Katleho-engineer/Solidworks-design/Calculations/Screenshot (3).png

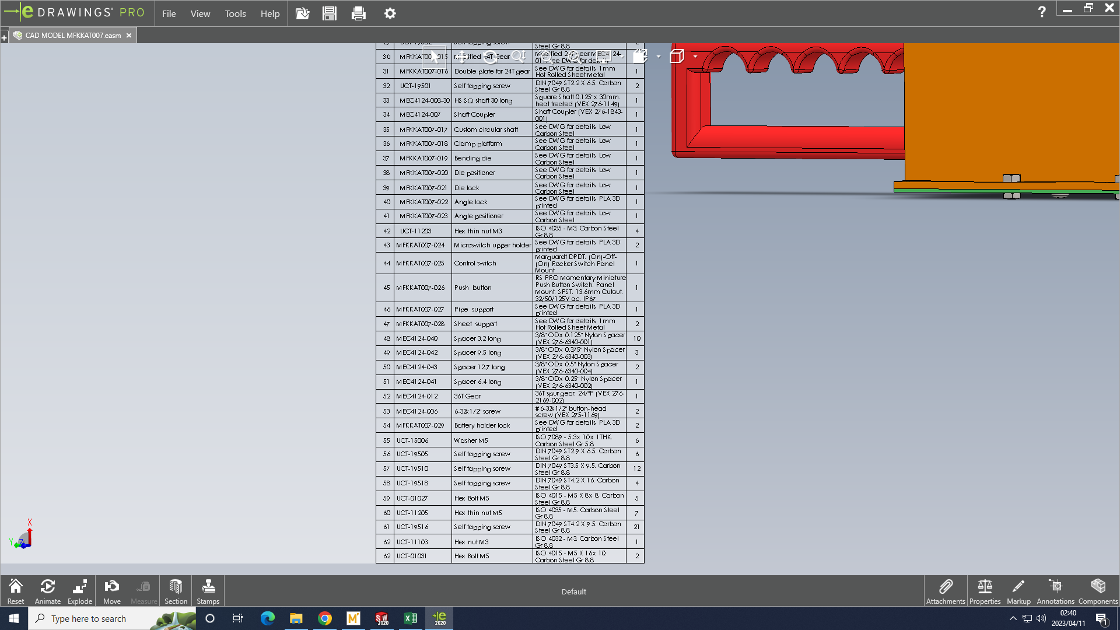
Calculations/Screenshot (3).png
