Katleho-engineer/Solidworks-design/Calculations/Screenshot (2).png

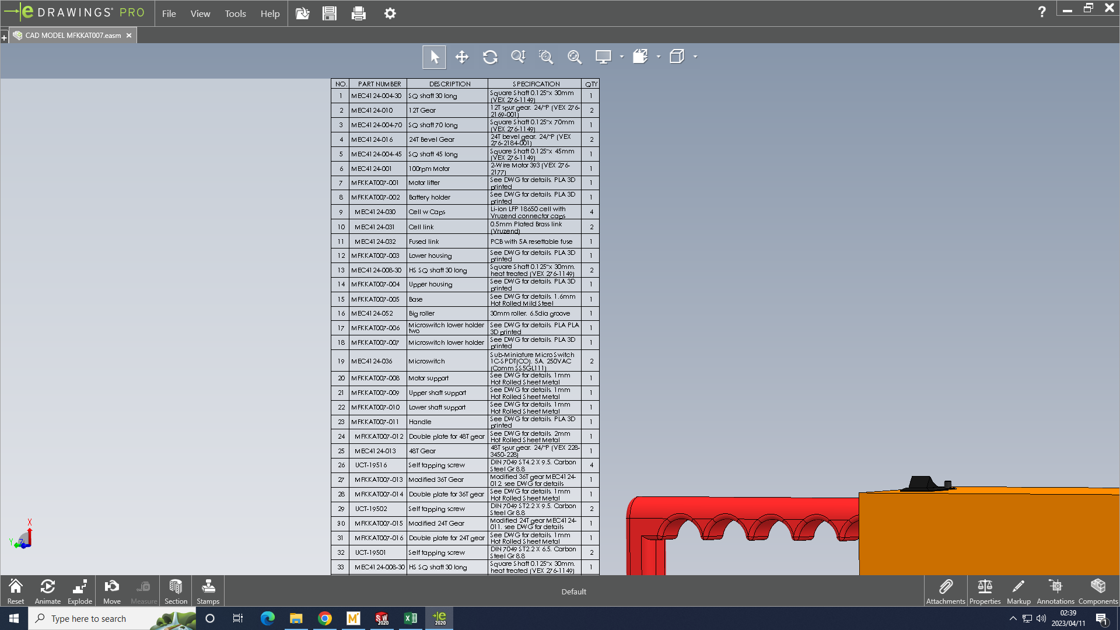
Calculations/Screenshot (2).png
