Katleho-engineer/Solidworks-design/PDF/Bending req.pdf

Appendix A: Bending requirements
The user requirements document gives the properties of the pipe that must be bent by the battery operated bending tool. Those properties are:
Pipe yield strength: | Tyield≔650 ⋅MPa
Pipe thickness: | t≔1.5 mm
Pipe outer diameter: | OD≔6 mm

Using the pipe outer diameter and thickness, the inner diameter can be calculated.

Pipe inner diameter: | ID≔OD -2 ⋅t
| ID =3 mm

Using the above pipe properties, the required bending moment to bend the pipe can be calculated.

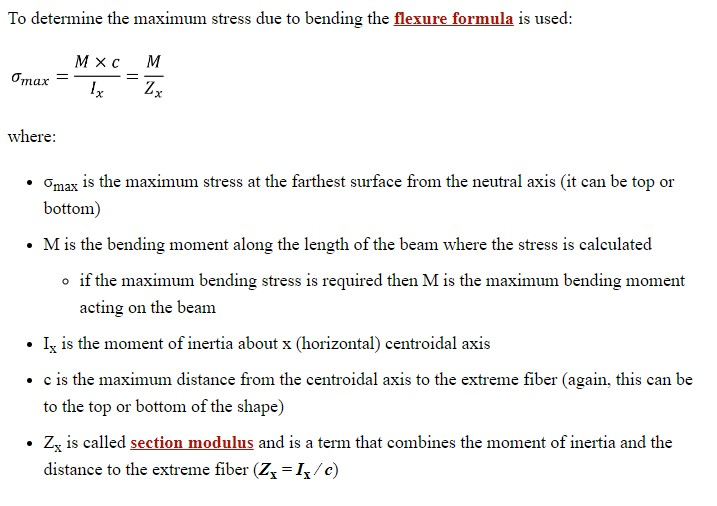
[picture p53: figure]

Figure 1: Bending stress formula

The above formula is taken from a book called "Mechanic of Materials" 11th edition, written by Russell C. Hibbeler

Non-Commercial Use Only

Figure 1: Section modulus formula

The above formula is taken from a book called "Mechanic of Materials" 11th edition, written by Russell C. Hibbeler.

Section Modulus: | SM≔―π⋅――――― ⎛⎝OD -
| 4 ID⁴ ⎞ ⎠ 32 ⋅ OD SM=19.88 mm³
Bending moment required: | Mrequired≔SM⋅Tyield
| Mrequired=12.922 N ⋅m

Now that the required bending moment is calculated, the gearbox should be designed such that the torque of the last gears is greater or equal to the required bending moment.

Non-Commercial Use Only
