Katleho-engineer/Solidworks-design/PDF/Deflection 4.pdf

Appendix D: Deflection calculations

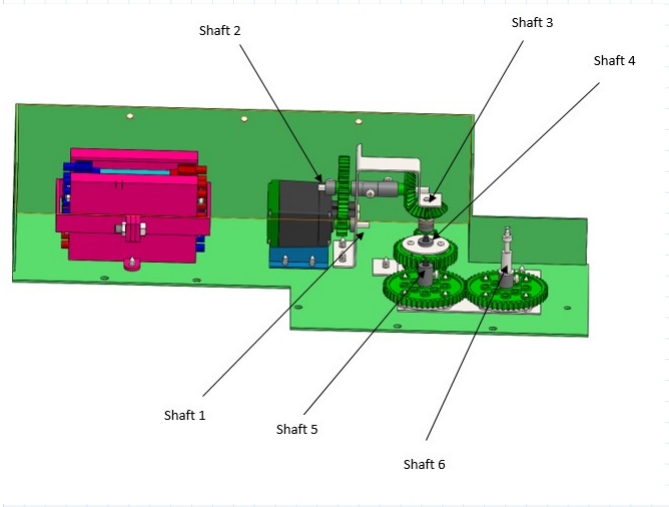
[picture p54: figure]

Figure 1: Shafts

Figure 1 above shows all the shafts that will be used in the prototype. It also shows all the the gears on the each shaft.

Non-Commercial Use Only

Maximum
Torque
[Nm]

Experience
d
Torque
[Nm]

Maximum
tangential
force [N]

Experience
d tangential
force [N]

Experience
d radial
force [N]

Rotational
speed
[rad/s]
Gear 1 [12T] | 3 | 0.941 | 450 | 148.228 | 53.95 | 14.537
Gear 2 [36T] | 3.4 | 2.627 | 700 | 137.879 | 50.184 | 4.508
Gear 3 [24T] | 3 | 2.627 | 300 | 206.819 | 75.276 | 4.508
Gear 4 [24T] | 3 | 2.489 | 300 | 195.99 | 71.335 | 4.272
Gear 5 [12T] | 3 | 2.489 | 450 | 391.98 | 142.669 | 4.272
Gear 6 [36T] | 3.4 | 6.946 | 700 | 364 | 132.709 | 1.324
Gear 7 [24T] | 1 | 6.946 | 580 | 546.923 | 199.064 | 1.324
Gear 8 [48T] | 1.2 | 13.269 | 580 | 522.417 | 190.144 | 0.638
Gear 9 [48T] | 1.2 | 12.922 | 580 | 508.74 | 185.166 | 0.621

Figure 1: Summary of the forces

The above table the shows all the forces calculated in Appendix C which will be used in this section to determine the deflection of each gear.

The above deflection equation from "Mechanic of Materials" 11th edition, written by Russell
C. Hibbeler, will be used to determine the deflection of the shaft.

All the shafts are made with low carbon steel and will have the same elastic modulus. All the square shafts have the same cross section and will the same moment of inertia.

Low carbon steel elastic
modulus:

Eshaft≔200 ⋅GPa

Cross sectional distance: | Dshaft≔3.18 mm

Moment of inertia: | Ishaft≔――― Dshaft
| 4
| 12
| Ishaft=8.522 mm⁴

Shaft 1

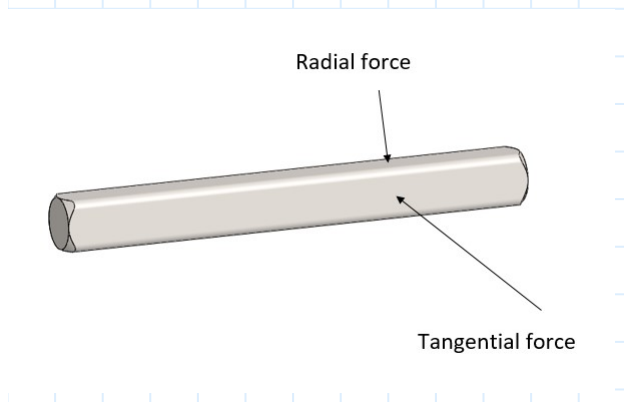
[picture p55: figure]

Shaft 1 has 12T spur gear on it. Thus, it will experience both radial and tangential forces. Shaft 1 has low carbon steel material.

Radial force will deflect the shaft vertically and the tangential force will deflect the shaft horizontally.

Shaft 1 length: | Lshaft_1≔30 mm

Deflection due to radial force

Radial force due to gear 1: | FR_1≔53.95 N

The distance from the
boundary the radial force:

ar1≔17.27 mm

The distance from the other boundary the radial force:

br1≔Lshaft_1-ar1

br1=12.73 mm

Maximum deflection caused
by the radial force:

δr1≔―――――――

| FR_1 ⋅ b ⋅ r1 | ar1
6 ⋅L | ⋅ | ⋅ shaft_1 Eshaft | Ishaft

⎛
⎝Lshaft_1 | - | -

### 2 br1

2
ar1

2 ⎞
⎠

δr1=0.017 mm

Deflection due to tangential force

Radial force due to gear 1: | FT_1≔148.228 N

The distance from the
boundary the radial force:

at1≔17.27 mm

The distance from the other boundary the radial force:

bt1≔Lshaft_1-ar1

bt1=12.73 mm

Maximum deflection caused
by the radial force:

δt1≔―――――――

| FT_1 ⋅ b ⋅ t1 | at1
6 ⋅L | ⋅ | ⋅ shaft_1 Eshaft | Ishaft

⎛
⎝Lshaft_1 | - | -

### 2 bt1

2
at1

2 ⎞
⎠

δt1=0.047 mm

Shaft 2

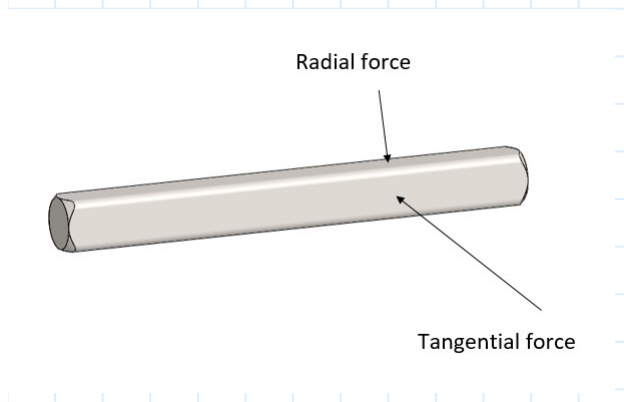
[picture p56: figure]

Shaft 2 has 36T spur gear and 24T bevel gear on it. Thus, it will experience both radial and tangential forces.

Radial force will deflect the shaft vertically and the tangential force will deflect the shaft horizontally.

Shaft 2 length: | Lshaft_2≔70 mm

Shaft 2 will experience radial forces caused by the 36T spur gear and 24T bevel gear. The deflection of interest will be at the two points at where the gears are meshing.

First meshing distance from the left: | b2_1l1≔16 mm

First meshing distance from
the right:

a2_1r1≔Lshaft_2-b2_1l1

a2_1r1=54 mm

Second meshing distance from the left:

a2_2l1≔58 mm

Second meshing distance from the right:

b2_2r2≔Lshaft_2-a2_2l1

b2_2r2=12 mm

Deflection due to radial force

Radial force due to 36T spur gear:

FR_2_36T≔50.184 N

Radial force due to 24T
bevel gear:

FR_2_24T≔75.276 N

For 36T gear

Deflection caused by the
radial force of gear 2 at the mesh 2:

δr2_36T≔―――――――

FR_2_36T ⋅ b | ⋅ 2_1l1 | a2_1r1
6 ⋅L | ⋅ | ⋅ shaft_2 | Eshaft | Ishaft

⎛
⎝Lshaft_2 - | -

### 2 b2_1l1

2
a2_1r1

2 ⎞
⎠

δr2_36T=0.105 mm

Deflection caused by the
radial force of gear 2 at the mesh 3:

δr3_36T≔―――――――

FR_2_36T ⋅ b | ⋅ 2_2r2 | b2_1l1
6 ⋅L | ⋅ | ⋅ shaft_2 | Eshaft | Ishaft

⎛
⎝Lshaft_2 - | -

### 2 b2_2r2

### 2 b2_1l1

2 ⎞
⎠

δr3_36T=0.061 mm

For 24T gear

Deflection caused by the
radial force of gear 3
at the mesh 2:

δr2_24T≔―――――――

FR_2_24T ⋅ b | ⋅ 2_2r2 | b2_1l1
6 ⋅L | ⋅ | ⋅ shaft_2 | Eshaft | Ishaft

⎛
⎝Lshaft_2 - | -

### 2 b2_2r2

### 2 b2_1l1

2 ⎞
⎠

δr2_24T=0.091 mm

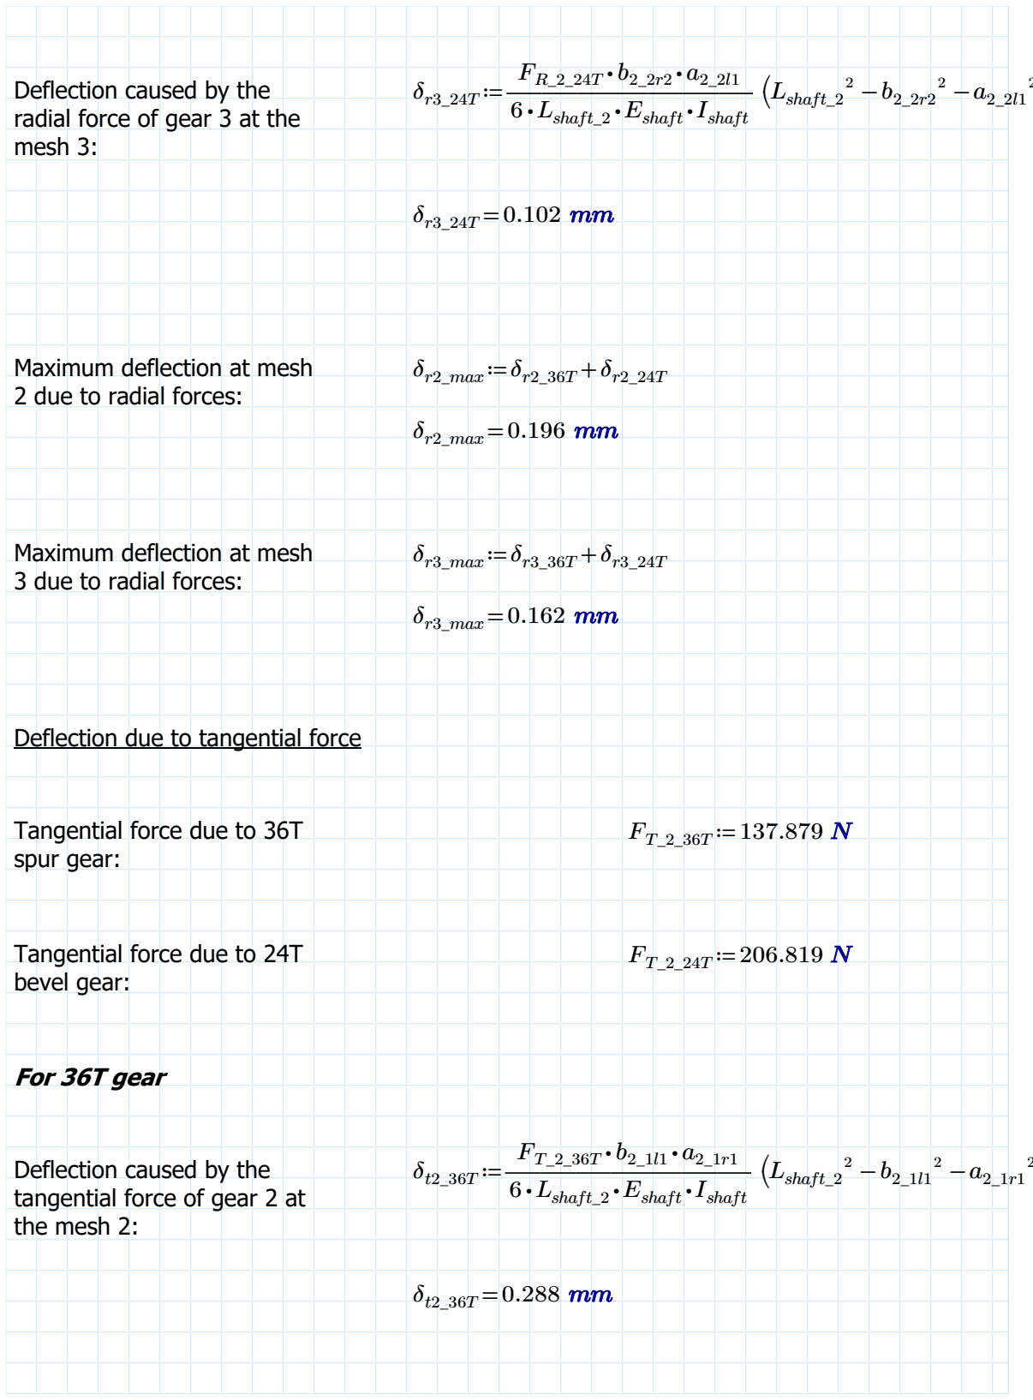
[picture p57: figure]
Deflection caused by the radial force of gear 3 at the mesh 3:; ⋅ shaft_2; Eshaft; Ishaft; ⎝Lshaft_2 -; Maximum deflection at mesh 2 due to radial forces:; δr2_max≔δr2_36T+δr2_24T; δr2_max=0.196 mm; Maximum deflection at mesh 3 due to radial forces:; δr3_max≔δr3_36T+δr3_24T; δr3_max=0.162 mm; Deflection due to tangential force; Tangential force due to 36T spur gear:; Tangential force due to 24T bevel gear:; For 36T gear; Deflection caused by the tangential force of gear 2 at the mesh 2:

2 ⎞
⎠

2 ⎞
⎠

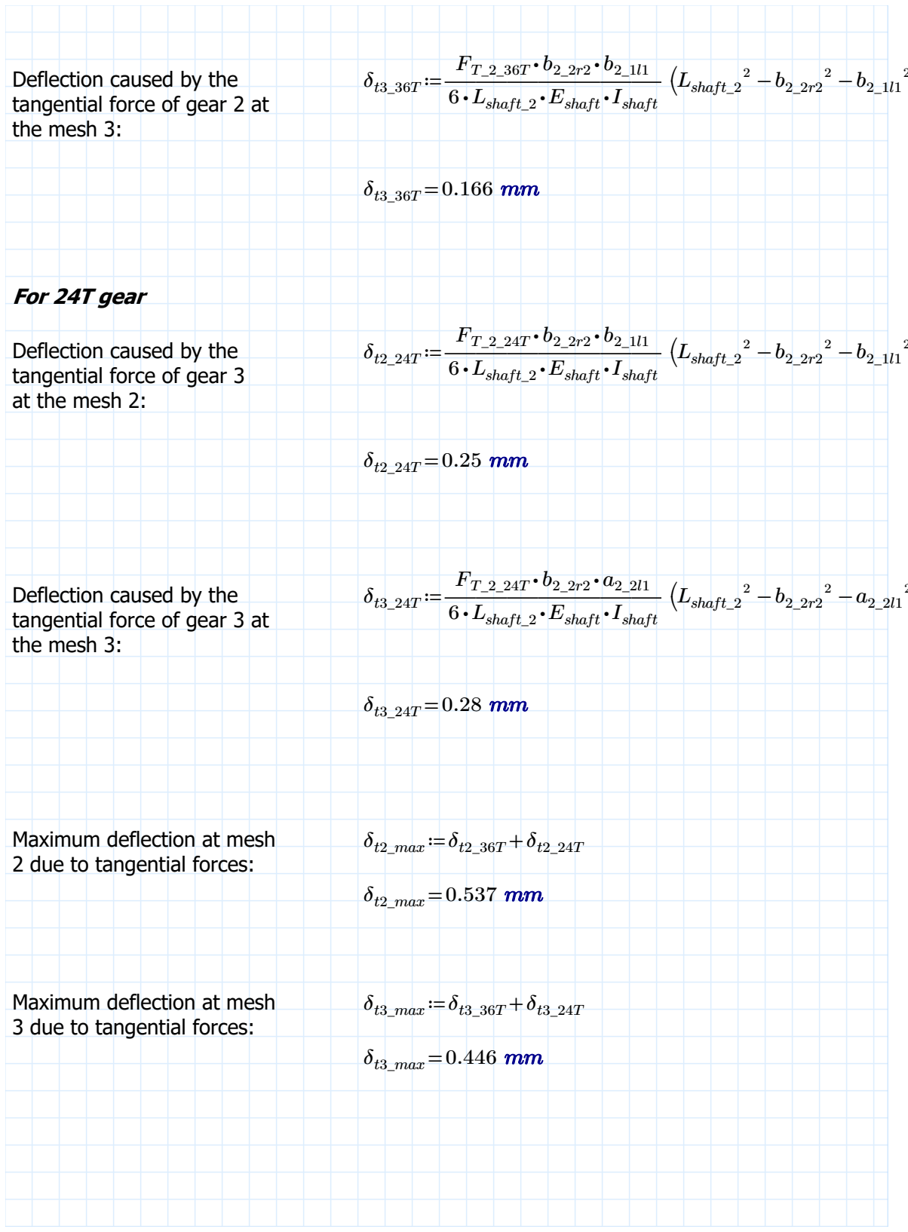
[picture p58: figure]
Deflection caused by the tangential force of gear 2 at the mesh 3:; ⋅ shaft_2; Eshaft; Ishaft; ⎝Lshaft_2 -; For 24T gear; Deflection caused by the tangential force of gear 3 at the mesh 2:; Deflection caused by the tangential force of gear 3 at the mesh 3:; Maximum deflection at mesh 2 due to tangential forces:; δt2_max≔δt2_36T+δt2_24T; δt2_max=0.537 mm; Maximum deflection at mesh 3 due to tangential forces:; δt3_max≔δt3_36T+δt3_24T; δt3_max=0.446 mm

2 ⎞
⎠

2 ⎞
⎠

2 ⎞
⎠

Shaft 3

Shaft 3 has 24T spur gear and 12T bevel gear on it. Thus, it will experience both radial and tangential forces.

Radial force will deflect the shaft vertically and the tangential force will deflect the shaft horizontally.

Shaft 3 length: | Lshaft_3≔45 mm

Shaft 3 will experience radial forces caused by the 24T bevel gear and 12T spur gear. The deflection of interest will be at the two points at where the gears are meshing.

First meshing distance from the left: | b3_1l1≔8 mm

First meshing distance from
the right:

a3_1r1≔Lshaft_3-b3_1l1

a3_1r1=37 mm

Second meshing distance from the left:

a3_2l1≔26 mm

Second meshing distance from the right:

b3_2r2≔Lshaft_3-a3_2l1

b3_2r2=19 mm

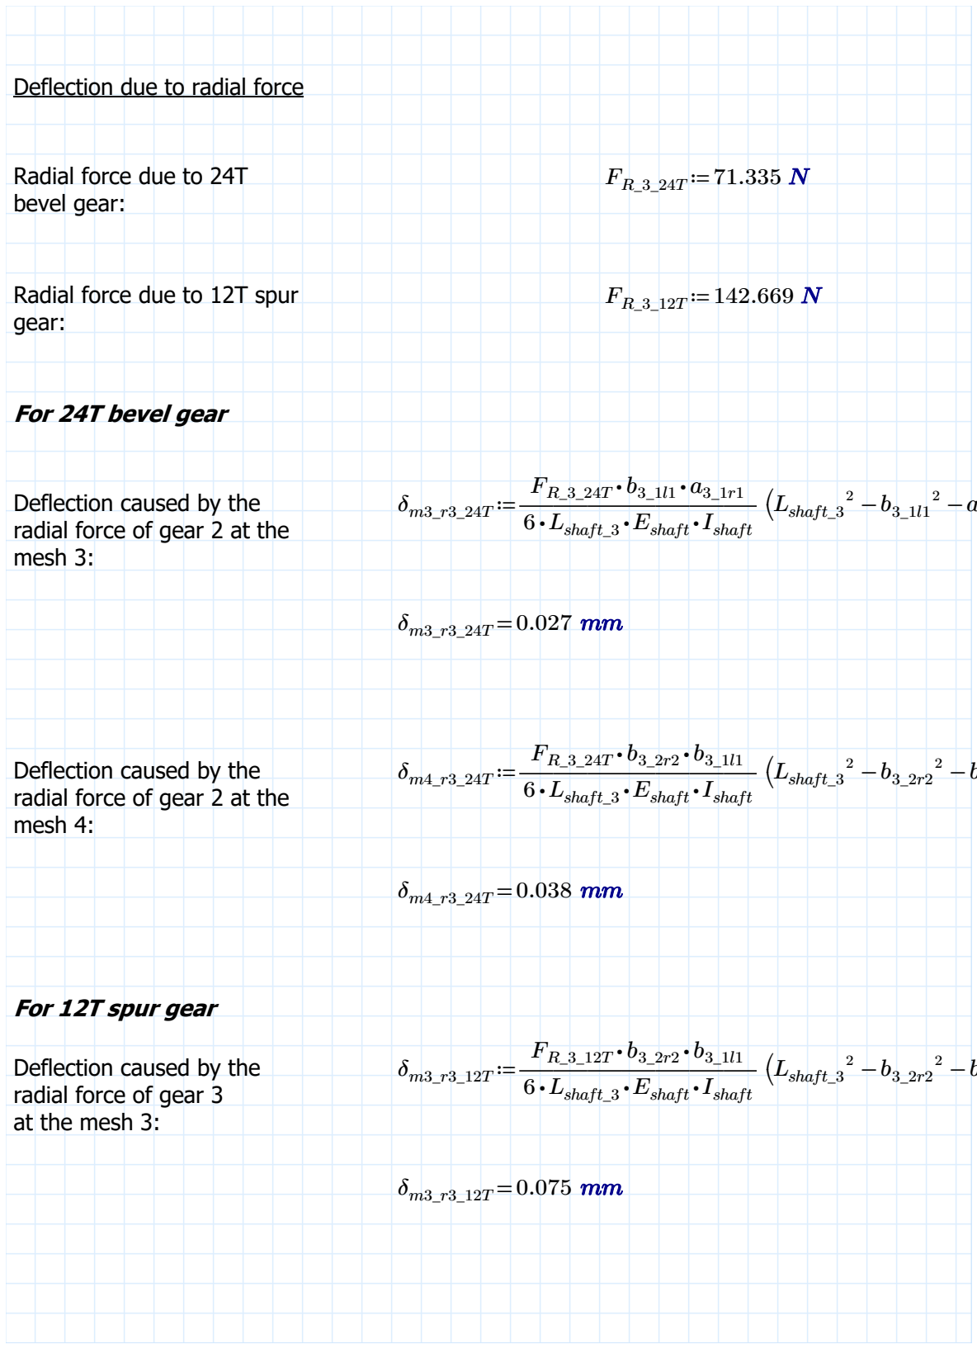
[picture p59: figure]
Deflection due to radial force; Radial force due to 24T bevel gear:; Radial force due to 12T spur gear:; For 24T bevel gear; Deflection caused by the radial force of gear 2 at the mesh 3:; ⋅ shaft_3; Eshaft; Ishaft; ⎝Lshaft_3 -; Deflection caused by the radial force of gear 2 at the mesh 4:; For 12T spur gear; Deflection caused by the radial force of gear 3 at the mesh 3:

a3_1r1

2 ⎞
⎠

### 2 b3_1l1

2 ⎞
⎠

### 2 b3_1l1

2 ⎞
⎠

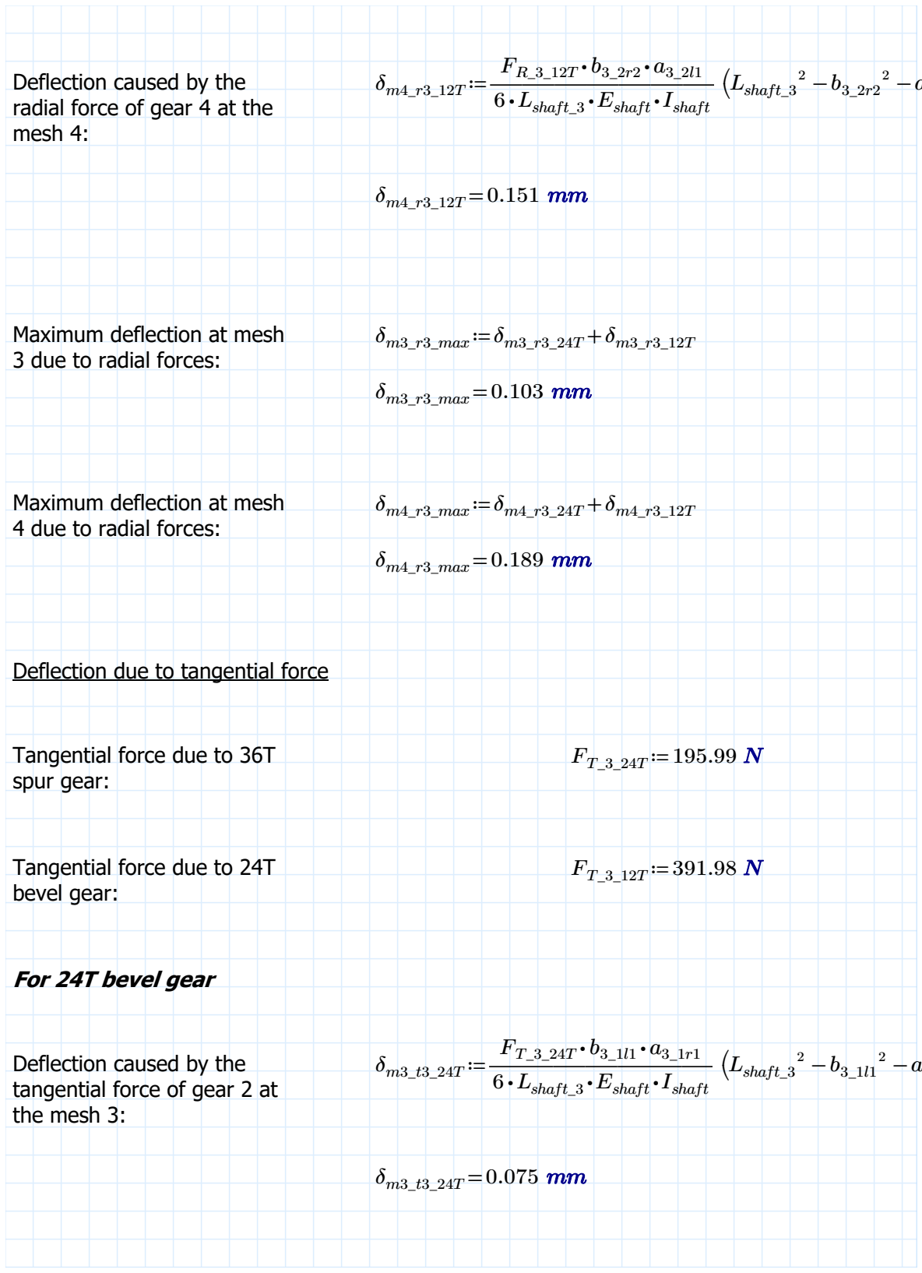
[picture p60: figure]
Deflection caused by the radial force of gear 4 at the mesh 4:; ⋅ shaft_3; Eshaft; Ishaft; ⎝Lshaft_3 -; Maximum deflection at mesh 3 due to radial forces:; δm3_r3_max≔δm3_r3_24T+δm3_r3_12T; δm3_r3_max=0.103 mm; Maximum deflection at mesh 4 due to radial forces:; δm4_r3_max≔δm4_r3_24T+δm4_r3_12T; δm4_r3_max=0.189 mm; Deflection due to tangential force; Tangential force due to 36T spur gear:; Tangential force due to 24T bevel gear:; For 24T bevel gear; Deflection caused by the tangential force of gear 2 at the mesh 3:

a3_2l1

2 ⎞
⎠

a3_1r1

2 ⎞
⎠

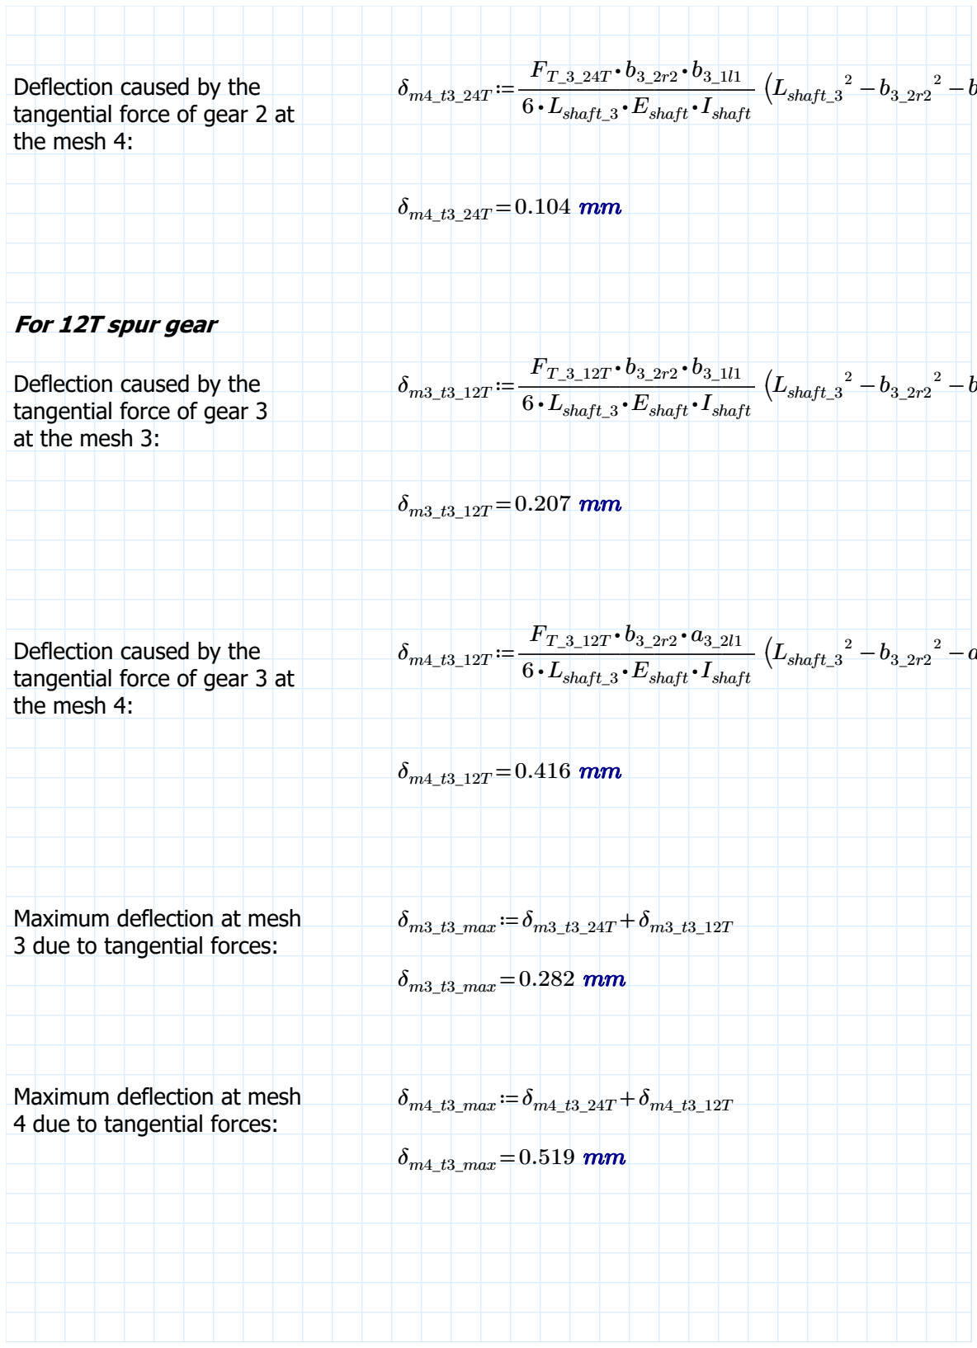
[picture p61: figure]
Deflection caused by the tangential force of gear 2 at the mesh 4:; ⋅ shaft_3; Eshaft; Ishaft; ⎝Lshaft_3 -; For 12T spur gear; Deflection caused by the tangential force of gear 3 at the mesh 3:; Deflection caused by the tangential force of gear 3 at the mesh 4:; Maximum deflection at mesh 3 due to tangential forces:; δm3_t3_max≔δm3_t3_24T+δm3_t3_12T; δm3_t3_max=0.282 mm; Maximum deflection at mesh 4 due to tangential forces:; δm4_t3_max≔δm4_t3_24T+δm4_t3_12T; δm4_t3_max=0.519 mm

### 2 b3_1l1

2 ⎞
⎠

### 2 b3_1l1

2 ⎞
⎠

a3_2l1

2 ⎞
⎠

Shaft 4

Shaft 4 has 36T spur gear and 24T bevel gear on it. Thus, it will experience both radial and tangential forces.

Radial force will deflect the shaft vertically and the tangential force will deflect the shaft horizontally.

Shaft 4 length: | Lshaft_4≔30 mm

Shaft 3 will experience radial forces caused by the 24T bevel gear and 12T spur gear. The deflection of interest will be at the two points at where the gears are meshing.

First meshing distance from the left: | b4_1l1≔11 mm

First meshing distance from
the right:

a4_1r1≔Lshaft_4-b4_1l1

a4_1r1=19 mm

Second meshing distance from the left:

a4_2l1≔19 mm

Second meshing distance from the right:

b4_2r2≔Lshaft_4-a4_2l1

b4_2r2=11 mm

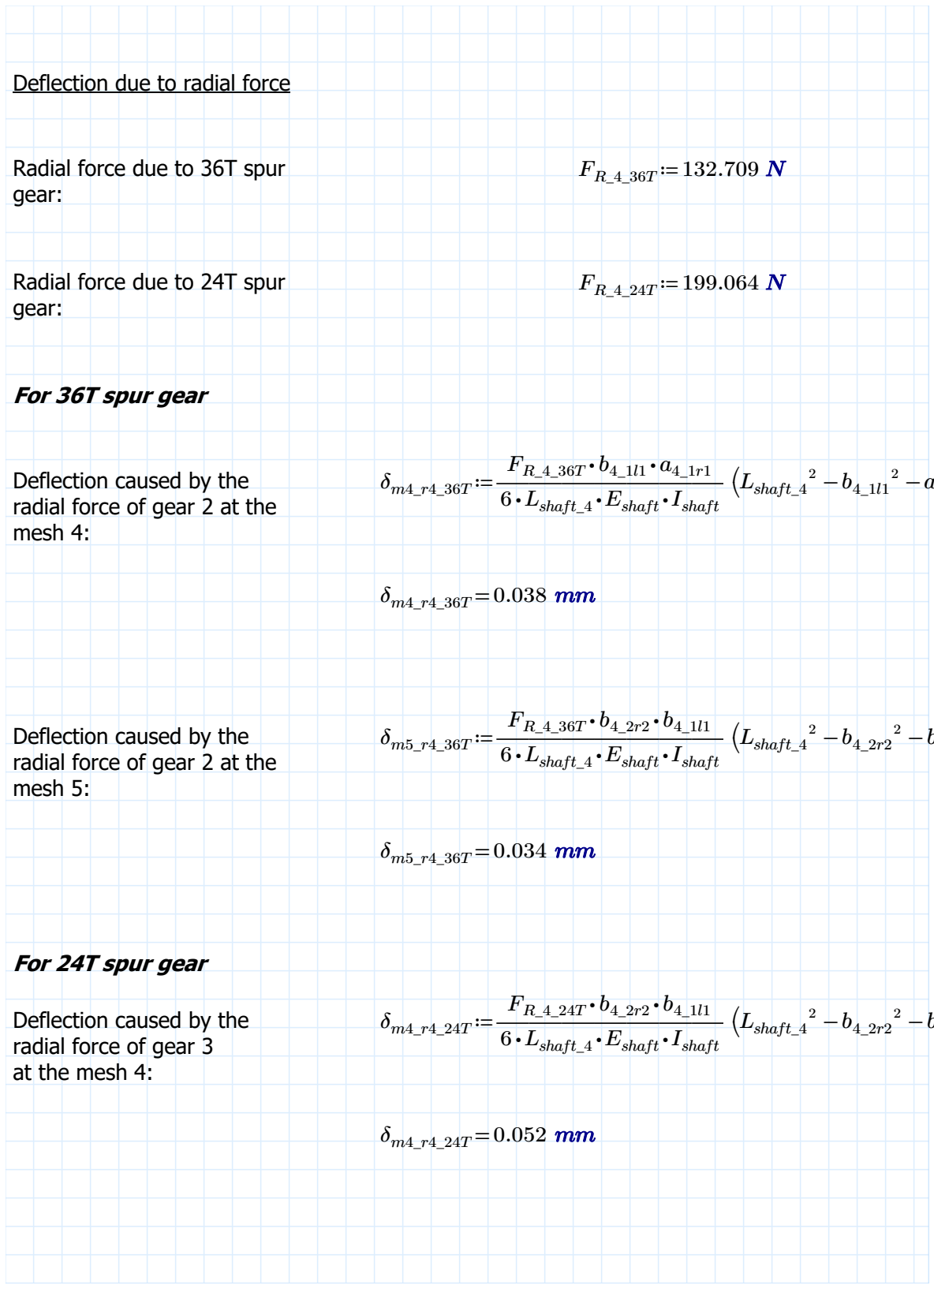
[picture p62: figure]
Deflection due to radial force; Radial force due to 36T spur gear:; Radial force due to 24T spur gear:; For 36T spur gear; Deflection caused by the radial force of gear 2 at the mesh 4:; ⋅ shaft_4; Eshaft; Ishaft; ⎝Lshaft_4 -; Deflection caused by the radial force of gear 2 at the mesh 5:; For 24T spur gear; Deflection caused by the radial force of gear 3 at the mesh 4:

a4_1r1

2 ⎞
⎠

### 2 b4_1l1

2 ⎞
⎠

### 2 b4_1l1

2 ⎞
⎠

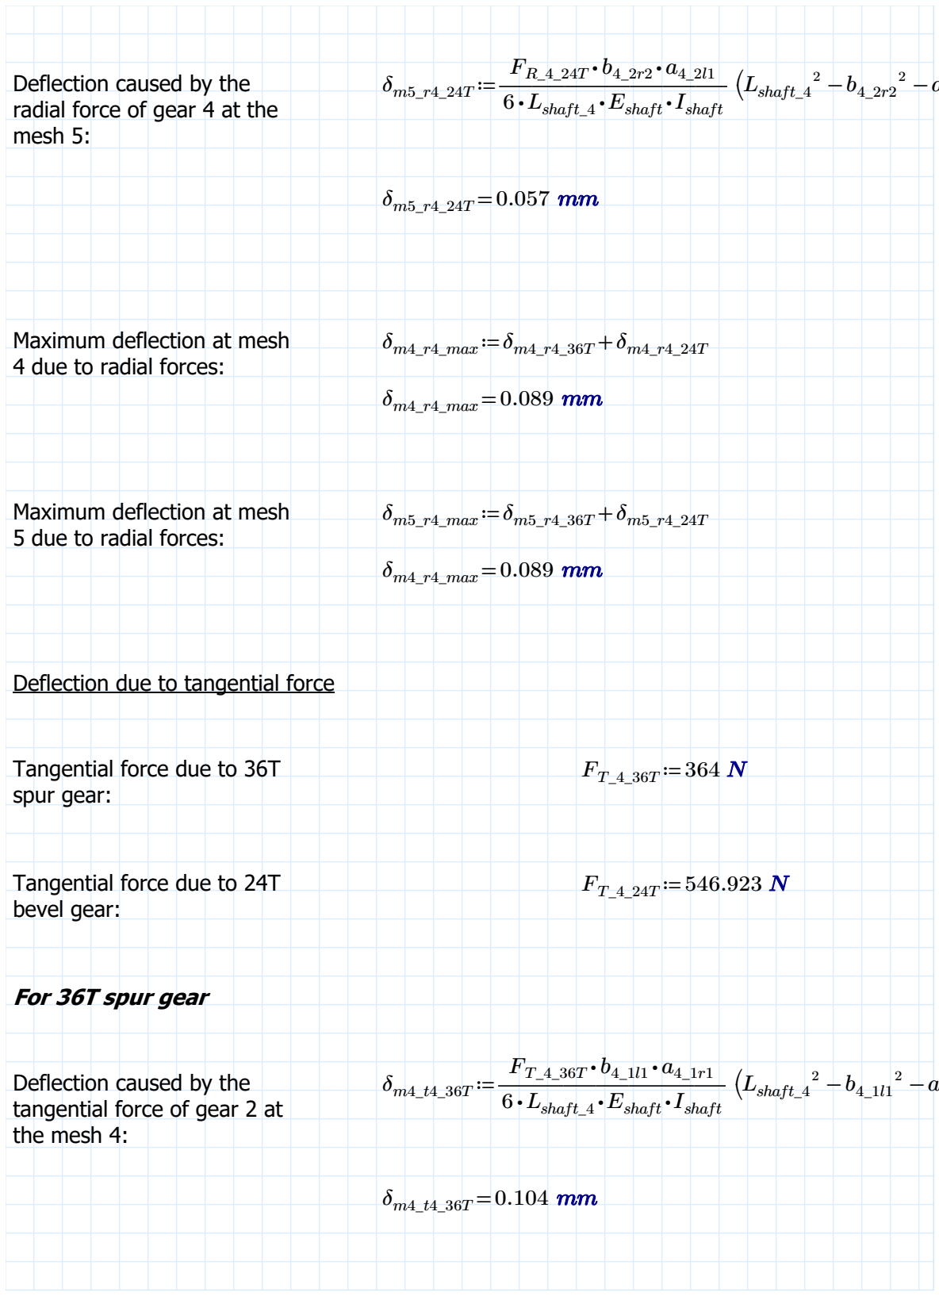
[picture p63: figure]
Deflection caused by the radial force of gear 4 at the mesh 5:; ⋅ shaft_4; Eshaft; Ishaft; ⎝Lshaft_4 -; Maximum deflection at mesh 4 due to radial forces:; δm4_r4_max≔δm4_r4_36T+δm4_r4_24T; δm4_r4_max=0.089 mm; Maximum deflection at mesh 5 due to radial forces:; δm5_r4_max≔δm5_r4_36T+δm5_r4_24T; Deflection due to tangential force; Tangential force due to 36T spur gear:; Tangential force due to 24T bevel gear:; For 36T spur gear; Deflection caused by the tangential force of gear 2 at the mesh 4:

a4_2l1

2 ⎞
⎠

a4_1r1

2 ⎞
⎠

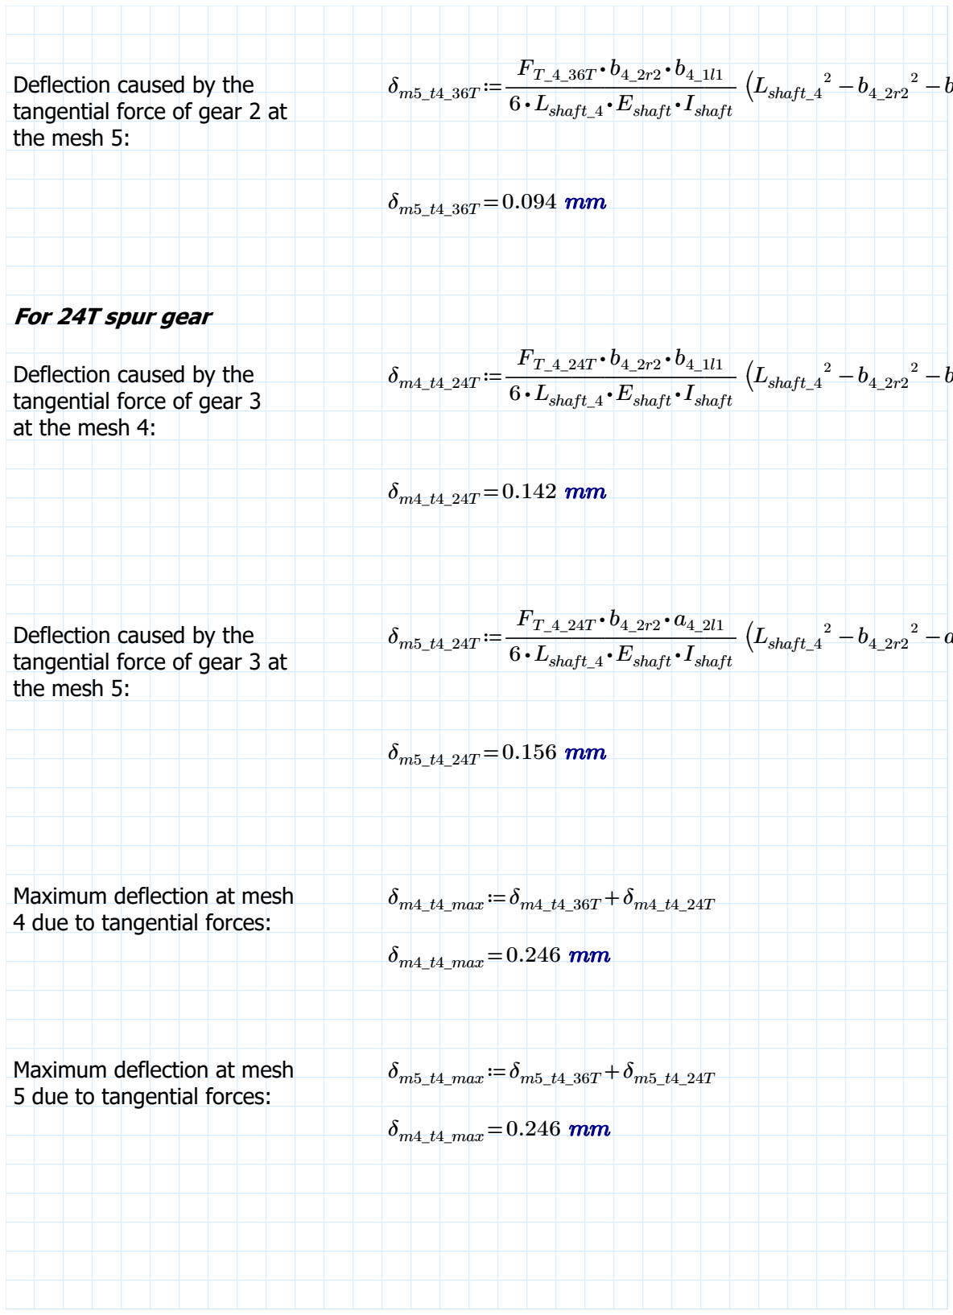
[picture p64: figure]
Deflection caused by the tangential force of gear 2 at the mesh 5:; ⋅ shaft_4; Eshaft; Ishaft; ⎝Lshaft_4 -; For 24T spur gear; Deflection caused by the tangential force of gear 3 at the mesh 4:; Deflection caused by the tangential force of gear 3 at the mesh 5:; Maximum deflection at mesh 4 due to tangential forces:; δm4_t4_max≔δm4_t4_36T+δm4_t4_24T; δm4_t4_max=0.246 mm; Maximum deflection at mesh 5 due to tangential forces:; δm5_t4_max≔δm5_t4_36T+δm5_t4_24T

### 2 b4_1l1

2 ⎞
⎠

### 2 b4_1l1

2 ⎞
⎠

a4_2l1

2 ⎞
⎠

Shaft 5

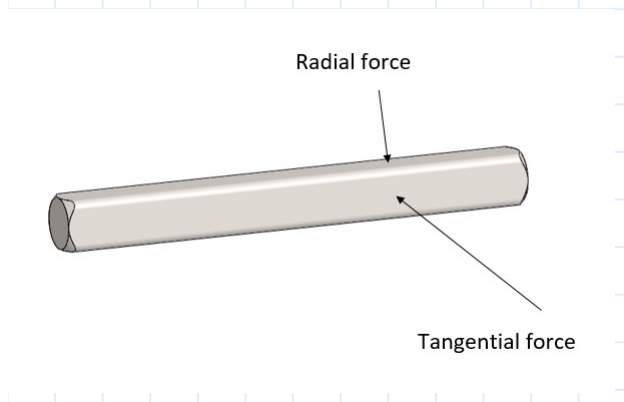
[picture p65: figure]

Shaft 5 has 48T spur gear on it. Thus, it will experience both radial and tangential forces.

Radial force will deflect the shaft vertically and the tangential force will deflect the shaft horizontally.

Shaft 5 length: | Lshaft_5≔30 mm

Shaft 5 will experience radial forces caused by the 24T bevel gear and 12T spur gear. The deflection of interest will be at the two points at where the gears are meshing.

First meshing distance from
the left:

b5_1l1≔18.57 mm

First meshing distance from the right:

a5_1r1≔Lshaft_5-b5_1l1

a5_1r1=11.43 mm

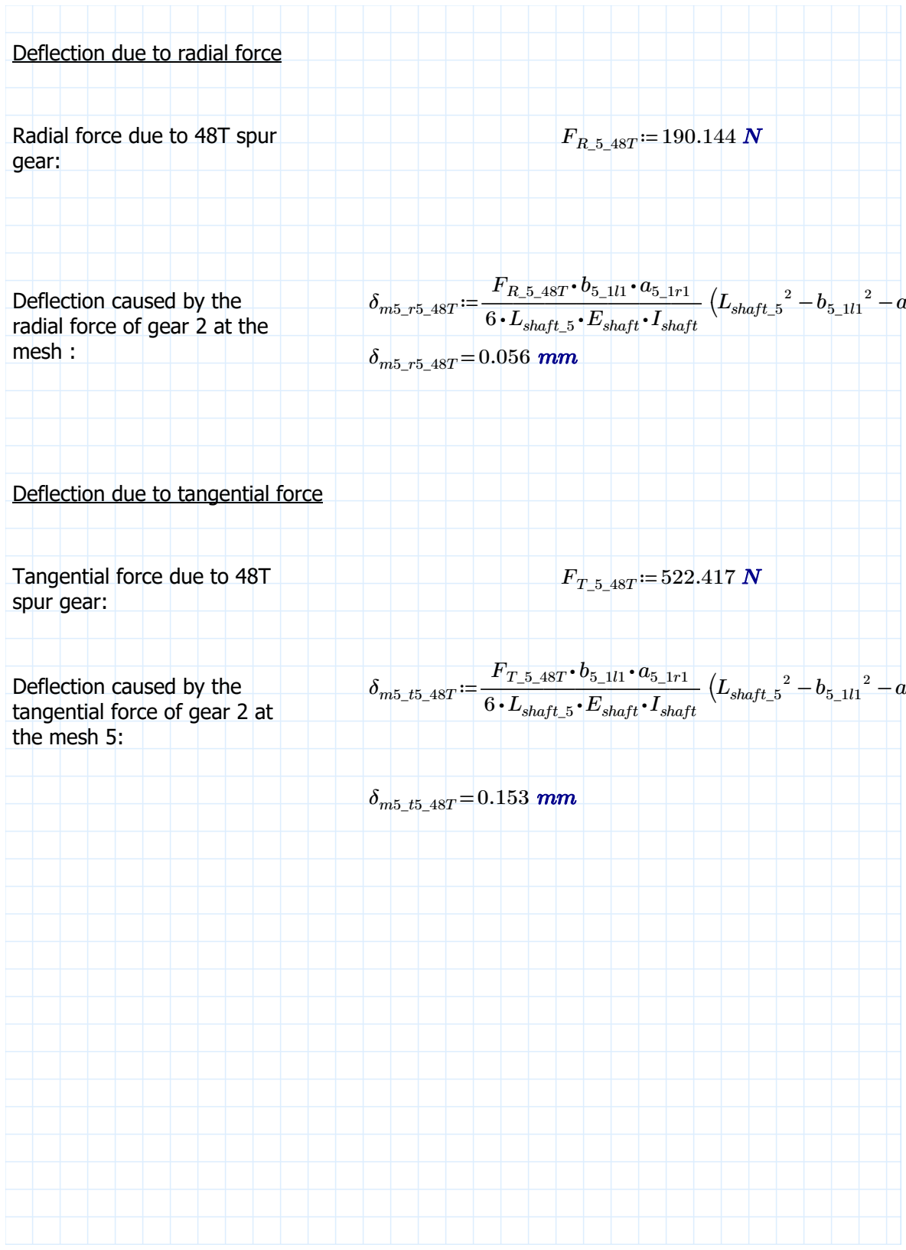
[picture p66: figure]
Deflection due to radial force; Radial force due to 48T spur gear:; Deflection caused by the radial force of gear 2 at the mesh :; ⋅ shaft_5; Eshaft; Ishaft; ⎝Lshaft_5 -; Deflection due to tangential force; Tangential force due to 48T spur gear:; Deflection caused by the tangential force of gear 2 at the mesh 5:

a5_1r1

2 ⎞
⎠

a5_1r1

2 ⎞
⎠

Shaft 6

Shaft 6 has 48T spur gear on it. Thus, it will experience both radial and tangential forces.

Radial force will deflect the shaft vertically and the tangential force will deflect the shaft horizontally.

Shaft 5 length: | Lshaft_6≔54.2 | mm

Shaft 5 will experience radial forces caused by the 24T bevel gear and 12T spur gear. The deflection of interest will be at the two points at where the gears are meshing.

First meshing distance from
the left:

b6_1l1≔11 mm

First meshing distance from the right:

a6_1r1≔Lshaft_6-b6_1l1

a6_1r1=43.2 mm

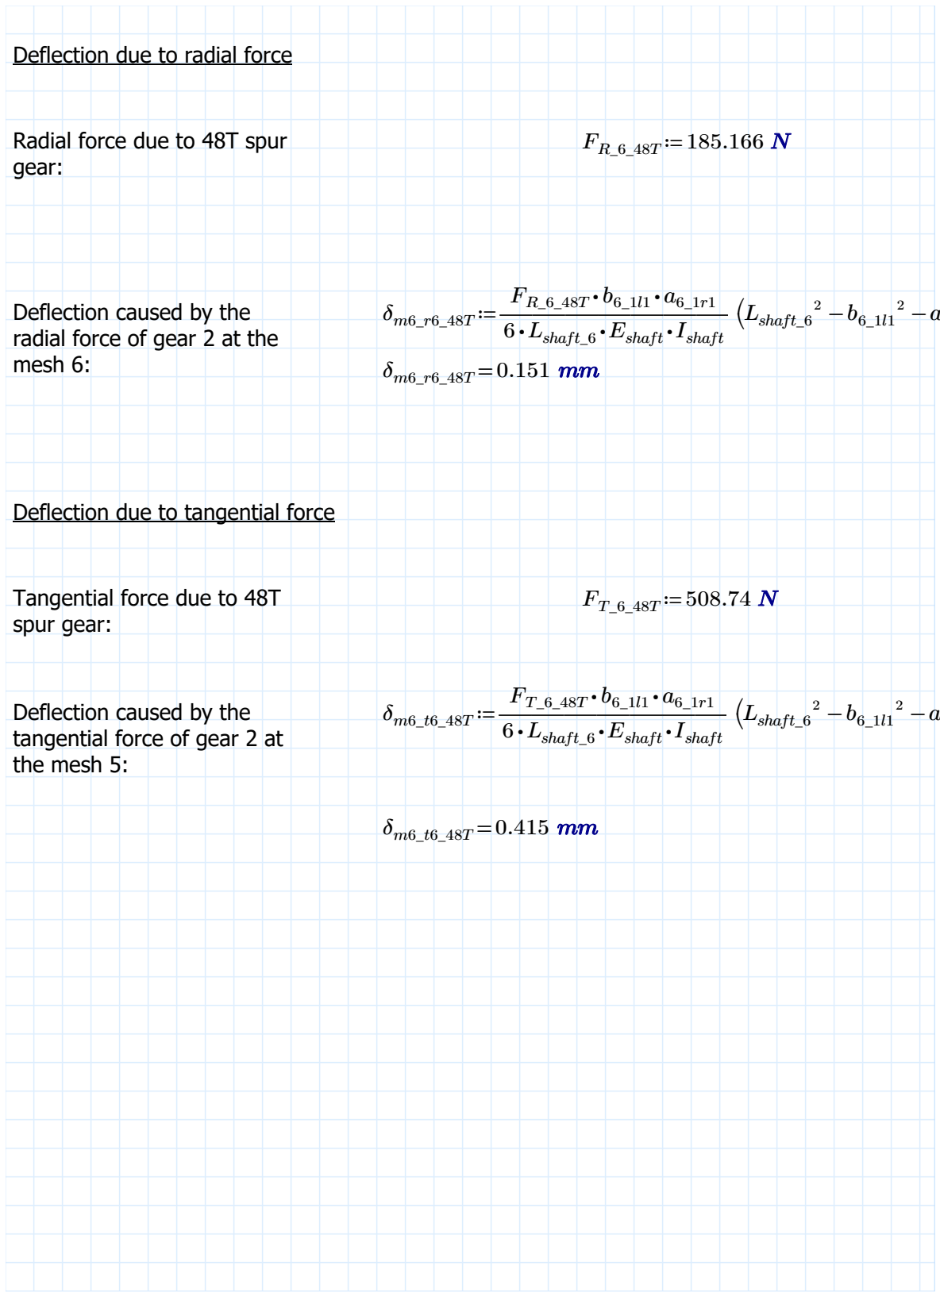
[picture p67: figure]
Deflection due to radial force; Radial force due to 48T spur gear:; Deflection caused by the radial force of gear 2 at the mesh 6:; ⋅ shaft_6; Eshaft; Ishaft; ⎝Lshaft_6 -; Deflection due to tangential force; Tangential force due to 48T spur gear:; Deflection caused by the tangential force of gear 2 at the mesh 5:

a6_1r1

2 ⎞
⎠

a6_1r1

2 ⎞
⎠
