Katleho-engineer/Solidworks-design/PDF/Gear 3.pdf

Appendix C: Gear calculations

In Appendix B the 100 rpm motor was selected. Its calculated properties are listed below:

The maximum motor
current: | Imax≔2.936 A

The maximum output
torque: | Tmax≔1.211 N ⋅m
The maximum output speed: | wmax≔11.367 ―rad―s

The maximum overload time
to trip:

tmax_trip≔3.091 s

In Appendix A the required bending moment to bend the pipe was determined to be the following:

Bending moment required to
bend the pipe:

Mrequired≔12.922 N ⋅m

Before selecting the gears, the required gear ratio needs to be determined. The required gear ratio will be determined using the required bending moment and the peak output torque of the motor.

Required gear ratio: | GRrequired≔――― Mrequired Tmax GRrequired=10.671

Therefore, the gear train ratio has to be equal to the required gear ratio taking into account all the efficiencies.

Through trial and error, and taking into account the shape of the model and the user requirements. Below is how the gear train is designed.

Non-Commercial Use Only

Gears | Driven by | Drives | On the same shaft as
12T spur gear | The motor | 36T spur gear | -
36T spur gear | 12T spur gear | - | 24T bevel gear
24T bevel gear | - | 24T bevel gear | 36T spur gear
24T bevel gear | 24T bevel gear | - | 12T spur gear
12T spur gear | - | 36T spur gear | 24T bevel gear
36T spur gear | 12T spur gear | - | 24T spur gear
24T spur gear | - | 48T spur gear | 36T spur gear
48T spur gear | 24T spur gear | - | -

Figure 2: Table summarising the gearbox design.

In the table above each gear is given its own colour to make it easy for the reader to follow. The table also shows which gears are driven, which gears drives and which gears are on the same shaft.

Using figure 1 and 2, the meshing gears can be shown in the table below.

Meshing gears
Mesh 1 | 12T spur gear with 36T spur gear
Mesh 2 | 24T bevel gear with 24T bevel gear
Mesh 3 | 12T spur gear with 36T spur gear
Mesh 4 | 24T spur gear with 48T spur gear
Mesh 5 | 48T spur gear with 48T spur gear

Figure 3: Table showing meshing gears

Using the above table, the gear train efficiency can be calculated

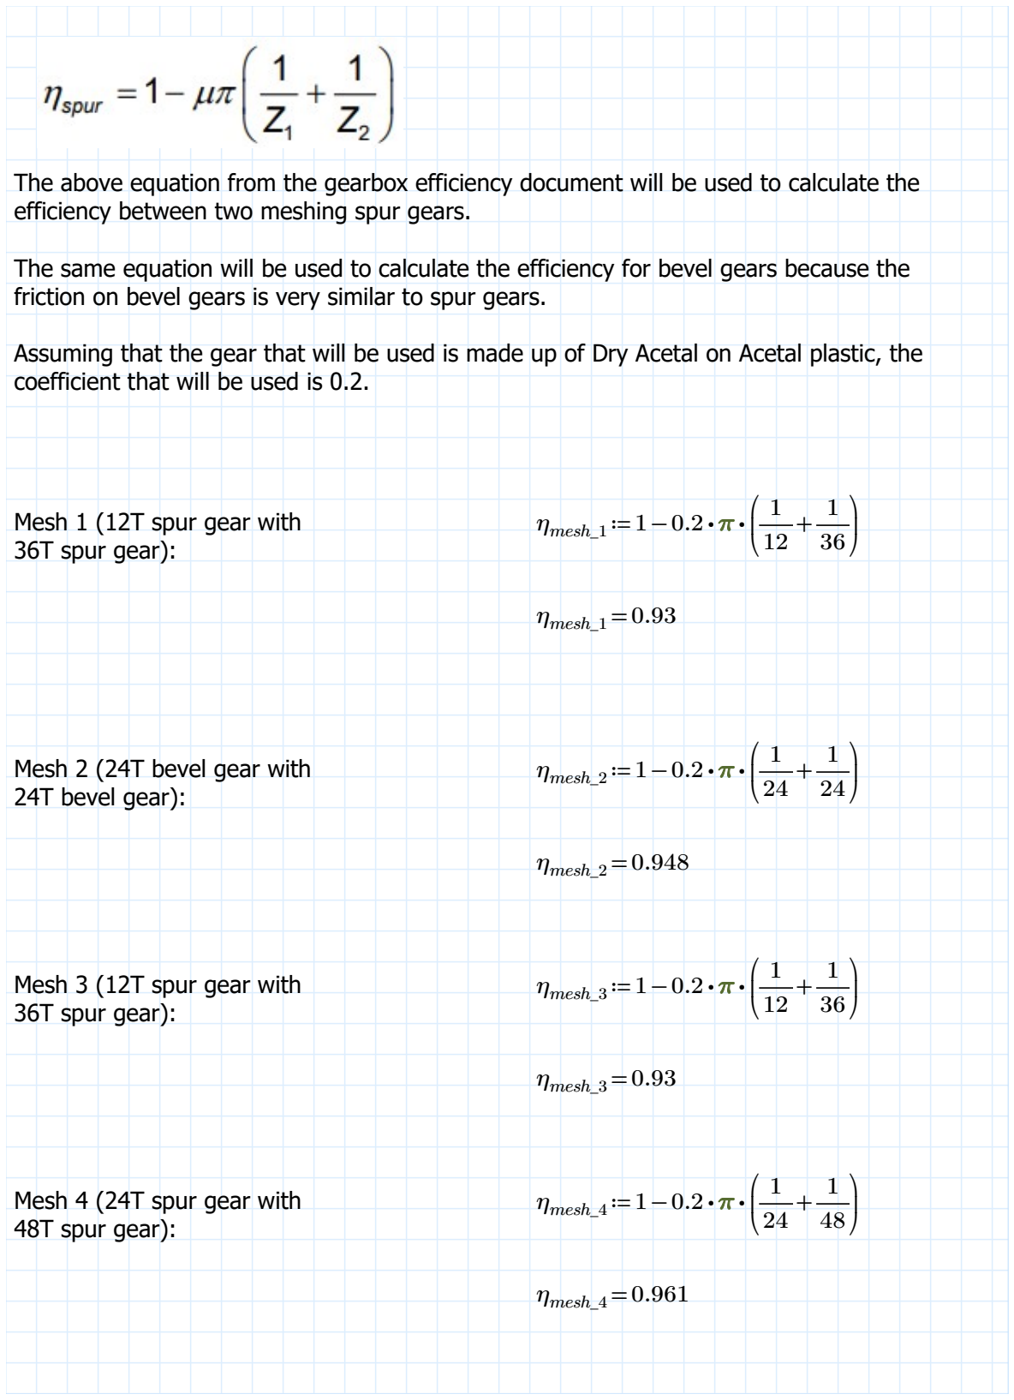
[picture p68: figure]
coefficient that will be used is 0.2.; Mesh 1 (12T spur gear with 36T spur gear):; ηmesh_1≔1-0.2 ⋅π⋅; ηmesh_1=0.93; Mesh 2 (24T bevel gear with 24T bevel gear):; ηmesh_2≔1-0.2 ⋅π⋅; ηmesh_2=0.948; Mesh 3 (12T spur gear with 36T spur gear):; ηmesh_3≔1-0.2 ⋅π⋅; ηmesh_3=0.93; Mesh 4 (24T spur gear with 48T spur gear):; ηmesh_4≔1-0.2 ⋅π⋅; ηmesh_4=0.961

The above equation from the gearbox efficiency document will be used to calculate the efficiency between two meshing spur gears.

The same equation will be used to calculate the efficiency for bevel gears because the friction on bevel gears is very similar to spur gears.

Assuming that the gear that will be used is made up of Dry Acetal on Acetal plastic, the

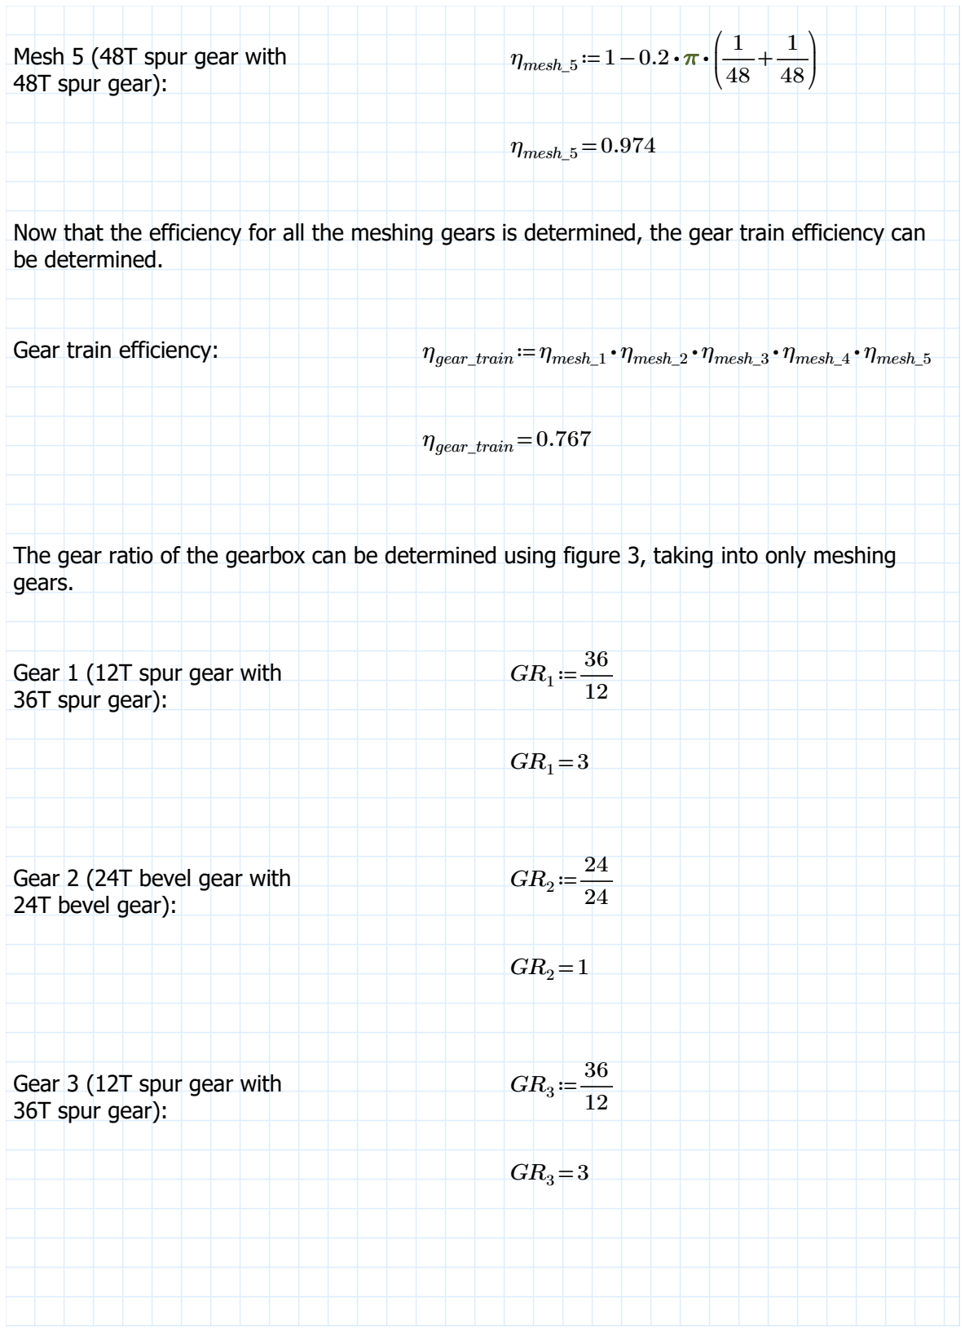
[picture p69: figure]
Mesh 5 (48T spur gear with 48T spur gear):; ηmesh_5≔1-0.2 ⋅π⋅; ηmesh_5=0.974; be determined.; Gear train efficiency:; ηgear_train≔ηmesh_1 ⋅ηmesh_2 ⋅ηmesh_3 ⋅ηmesh_4 ⋅ηmesh_5; ηgear_train=0.767; gears.; Gear 1 (12T spur gear with 36T spur gear):; Gear 2 (24T bevel gear with 24T bevel gear):; Gear 3 (12T spur gear with 36T spur gear):

Now that the efficiency for all the meshing gears is determined, the gear train efficiency can

The gear ratio of the gearbox can be determined using figure 3, taking into only meshing

Gear 4 (24T spur gear with 48T spur gear):

GR4≔―48
24

GR4=2

Gear 5 (48T spur gear with 48T spur gear):

GR5≔―48
48

GR5=1

Now that the gear ratio for all the meshing gears is determined, the gear train ratio can be determined, taking into account the efficiency.

Gear train ratio: | GRgear_train≔GR ⋅ | ⋅ | ⋅ | ⋅ | ⋅ 1 | GR2 GR3 GR4 GR5 ηgear_train

GRgear_train=13.808

The gear train ratio works out perfectly because it greater than the required gear ratio, which
is | GR | = | . required | 10.671

Now the actual current, output torque, output speed and trip time for the motor can be calculated.

Actual output motor torque: | Tactual≔――――

Mrequired

GRgear_train

Tactual=0.936 N ⋅m

Figure 4: Motor torque equation

The above equation is from the motor specification document, it will be used to calculate the operating motor current. The motor specification document also gives the values for the constant in the equation.

Gearbox reduction ratio: | rg≔156.8
Gearbox efficiency: | ηg≔0.7
Static drag: | T0≔110 ⋅N ⋅mm
Torque constant: | KT≔4.1 N ⋅―mm―A
Armature resistance: | Ra≔1.87 Ω
Operating motor current: | Iactual≔―――― Tactual-T0 KT ⋅ r ⋅ g ηg Iactual=1.835 A

Figure 5: Motor speed equation

The above equation is from the motor specification document, it will be used to calculate the motor output speed.

Supply voltage to the motor
calculated in Appendix B:
Vsupply≔12.8 | V
Motor output speed: | wactual≔――――――
Vsupply-I | ⋅ actual Ra
KT ⋅ rg

wactual=14.573 ―rad―s

⎛

⎞
-3.54

Overload time to trip: | tactual_trip≔140 ⋅ | ⋅

⎛
⎜

⎝――

Iactual
1 ⋅A

⎞
⎟
⎠

-3.54
s

tactual_trip=16.322 s

| Peak condition | Actual condition
Current [A] | 2.936 | 1.847
Output speed [rad/s] | 11.367 | 14.537
Output torque [Nm] | 1.211 | 0.941
Trip time [s] | 3.091 | 15.948

Figure 6: Comparing peak conditions and actual conditions

The table above the shows the difference when the motor is operating at its peak and at its actual point.

Now the torque and forces experienced by each gear can calculated. The efficiencies for all the meshing gears are calculated.

Gear 1

Gear 1 is a spur gear driven by the motor through a shaft.

Number of teeth of gear 1: | Ngear_1≔12
Diameter of gear 1: | Dgear_1≔12.7 | mm
Pressure angle of gear 1: | θgear_1≔20 | °
Speed of gear 1: | wgear_1≔wactual
wgear_1=14.573 ―rad―s

Torque of gear 1: | Tgear_1≔Tactual
| Tgear_1=0.936 N ⋅m
Tangential force of gear 1: | Ftan_gear_1≔――――

Tgear_1

D | ⋅ gear_1 | 0.5

Ftan_gear_1=147.374 N

Radial force of gear 1: | Frad_gear_1≔F | ⋅ tan_gear_1 | tan⎛⎝θgear_1⎞
⎠

Frad_gear_1=53.64 N

Gear 2

Gear 2 is a spur gear that meshes with gear 1. The efficiency is already calculated earlier in this section.

Number of teeth of gear 2: | Ngear_2≔36
Diameter of gear 2: | Dgear_2≔38.1 | mm
Pressure angle of gear 2: | θgear_2≔20 | °
Speed of gear 2: | wgear_2≔―――⋅ | ⋅
| Ngear_1 Ngear_2
wgear_1 | ηmesh_1
| wgear_2=4.518 ―rad―s

Torque of gear 2: | Tgear_2≔―――⋅ | ⋅
| Ngear_2 Ngear_1
Tgear_1 | ηmesh_1
| Tgear_2=2.611 N ⋅m
Tangential force of gear 2: | Ftan_gear_2≔――――

Tgear_2

D | ⋅ gear_2 | 0.5

Ftan_gear_2=137.085 N

Radial force of gear 2: | Frad_gear_2≔F | ⋅ tan_gear_2 | tan⎛⎝θgear_2⎞
⎠

Frad_gear_2=49.895 N

Gear 3

Gear 3 is a bevel gear and is on the shaft as gear 2.

Number of teeth of gear 3: | Ngear_3≔24
Diameter of gear 3: | Dgear_3≔25.4 | mm
Pressure angle of gear 3: | θgear_3≔20 | °
Speed of gear 3: | wgear_3≔wgear_2
wgear_3=4.518 ―rad―s
Torque of gear 3: | Tgear_3≔Tgear_2

gear_3 gear_2

Tgear_3=2.611 N ⋅m

Tangential force of gear 3: | Ftan_gear_3≔――――

Tgear_3

D | ⋅ gear_3 | 0.5

Ftan_gear_3=205.627 N

Radial force of gear 3: | Frad_gear_3≔F | ⋅ tan_gear_3 | tan⎛⎝θgear_1⎞
⎠

Frad_gear_3=74.842 N

Gear 4

Gear 4 is a bevel gear that meshes with gear 3. The efficiency is already calculated earlier in this section.

Number of teeth of gear 4: | Ngear_4≔24
Diameter of gear 4: | Dgear_4≔25.4 | mm
Pressure angle of gear 4: | θgear_4≔20 | °
Speed of gear 4: | wgear_4≔―――⋅ | ⋅
| Ngear_3 Ngear_4
wgear_3 | ηmesh_2
| wgear_4=4.282 ―rad―s

Torque of gear 4: | Tgear_4≔―――⋅ | ⋅
| Ngear_4 Ngear_3
Tgear_3 | ηmesh_2
| Tgear_4=2.475 N ⋅m
Tangential force of gear 4: | Ftan_gear_4≔――――

Tgear_4

D | ⋅ gear_4 | 0.5

Ftan_gear_4=194.861 N

Radial force of gear 4: | Frad_gear_4≔F | ⋅ tan_gear_4 | tan⎛⎝θgear_4⎞
⎠

Frad_gear_4=70.924 N

Gear 5

Gear 5 is a spur gear and it's on the shaft as gear 4.

Number of teeth of gear 5: | Ngear_5≔12
Diameter of gear 5: | Dgear_5≔12.7 | mm
Pressure angle of gear 5: | θgear_5≔20 | °
Speed of gear 5: | wgear_5≔wgear_4
wgear_5=4.282 ―rad―s
Torque of gear 5: | Tgear_5≔Tgear_4
| Tgear_5=2.475 N ⋅m

gear_5

Tangential force of gear 5: | Ftan_gear_5≔――――

Tgear_5

D | ⋅ gear_5 | 0.5

Ftan_gear_5=389.722 N

Radial force of gear 5: | Frad_gear_5≔F | ⋅ tan_gear_5 | tan⎛⎝θgear_5⎞
⎠

Frad_gear_5=141.847 N

Gear 6

Gear 6 is a spur gear that meshes with gear 5. The efficiency is already calculated earlier in this section.

Number of teeth of gear 6: | Ngear_6≔36
Diameter of gear 6: | Dgear_6≔38.1 | mm
Pressure angle of gear 6: | θgear_6≔20 | °
Speed of gear 6: | wgear_6≔―――⋅ | ⋅
| Ngear_5 Ngear_6
wgear_5 | ηmesh_3
| wgear_6=1.328 ―rad―s

Torque of gear 6: | Tgear_6≔―――⋅ | ⋅
| Ngear_6 Ngear_5
Tgear_5 | ηmesh_3
| Tgear_6=6.906 N ⋅m
Tangential force of gear 6: | Ftan_gear_6≔――――

Tgear_6

D | ⋅ gear_6 | 0.5

Ftan_gear_6=362.514 N

Radial force of gear 6: | Frad_gear_6≔F | ⋅ tan_gear_6 | tan⎛⎝θgear_6⎞
⎠

Frad_gear_6=131.944 N

Gear 7

Gear 7 is a spur gear and it's on the shaft as gear 6.

Number of teeth of gear 7: | Ngear_7≔24
Diameter of gear 7: | Dgear_7≔25.4 | mm
Pressure angle of gear 7: | θgear_7≔20 | °
Speed of gear 7: | wgear_7≔wgear_6
wgear_7=1.328 ―rad―s
Torque of gear 7: | Tgear_7≔Tgear_6

Tgear_7=6.906 N ⋅m

Tangential force of gear 7: | Ftan_gear_7≔――――

Tgear_7

D | ⋅ gear_7 | 0.5

Ftan_gear_7=543.771 N

Radial force of gear 7: | Frad_gear_7≔F | ⋅ tan_gear_7 | tan⎛⎝θgear_7⎞
⎠

Frad_gear_7=197.916 N

Gear 8

Gear 8 is a spur gear that meshes with gear 7. The efficiency is already calculated earlier in this section.

Number of teeth of gear 8: | Ngear_8≔48
Diameter of gear 8: | Dgear_8≔50.8 | mm
Pressure angle of gear 8: | θgear_8≔20 | °
Speed of gear 8: | wgear_8≔―――⋅ | ⋅
| Ngear_7 Ngear_8
wgear_7 | ηmesh_4
| wgear_8=0.638 ―rad―s

Torque of gear 8: | Tgear_8≔―――⋅ | ⋅
| Ngear_8 Ngear_7
Tgear_7 | ηmesh_4
| Tgear_8=13.269 N ⋅m
Tangential force of gear 8: | Ftan_gear_8≔――――

Tgear_8

D | ⋅ gear_8 | 0.5

Ftan_gear_8=522.417 N

Radial force of gear 8: | Frad_gear_8≔F | ⋅ tan_gear_8 | tan⎛⎝θgear_8⎞
⎠

Frad_gear_8=190.144 N

Gear 9

Gear 9 is a spur gear that meshes with gear 8. The efficiency is already calculated earlier in this section.

Number of teeth of gear 8: | Ngear_9≔48
Diameter of gear 8: | Dgear_9≔50.8 | mm
Pressure angle of gear 8: | θgear_9≔20 | °
Speed of gear 8: | wgear_9≔―――⋅ | ⋅
| Ngear_8 Ngear_9
wgear_8 | ηmesh_5
| wgear_9=0.621 ―rad―s

Torque of gear 8: | Tgear_9≔―――⋅ | ⋅
| Ngear_9 Ngear_8
Tgear_8 | ηmesh_5
| Tgear_9=12.922 N ⋅m
Tangential force of gear 8: | Ftan_gear_9≔――――

Tgear_9

D | ⋅ gear_9 | 0.5

Ftan_gear_9=508.74 N

Radial force of gear 8: | Frad_gear_9≔F | ⋅ tan_gear_9 | tan⎛⎝θgear_9⎞
⎠

Frad_gear_9=185.166 N

Maximum
Torque
[Nm]

Experience
d
Torque
[Nm]

Maximum
tangential
force [N]

Experience
d tangential
force [N]

Experience
d radial
force [N]

Rotational
speed
[rad/s]
Gear 1 [12T] | 3 | 0.941 | 450 | 148.228 | 53.95 | 14.537
Gear 2 [36T] | 3.4 | 2.627 | 700 | 137.879 | 50.184 | 4.508
Gear 3 [24T] | 3 | 2.627 | 300 | 206.819 | 75.276 | 4.508
Gear 4 [24T] | 3 | 2.489 | 300 | 195.99 | 71.335 | 4.272
Gear 5 [12T] | 3 | 2.489 | 450 | 391.98 | 142.669 | 4.272
Gear 6 [36T] | 3.4 | 6.946 | 700 | 364 | 132.709 | 1.324
Gear 7 [24T] | 1 | 6.946 | 580 | 546.923 | 199.064 | 1.324
Gear 8 [48T] | 1.2 | 13.269 | 580 | 522.417 | 190.144 | 0.638
Gear 9 [48T] | 1.2 | 12.922 | 580 | 508.74 | 185.166 | 0.621

Figure 6: Summary of gear calculations

The above highlights which gears must be support in red, this is because the torque that their experiencing is more than the torque it can withstand.

From the above table the following must be supported:
Gear 6 (36T spur gear)
Gear 7 (24T spur gear)
Gear 8 (48T spur gear)
Gear 9 (48T spur gear)
