Katleho-engineer/Solidworks-design/PDF/Mass 7.pdf

### 1. Appendix G: Mass calculations

Notation:

p : | density
m : | mass
V : | volume

The mass of each part will be calculated using the below equation:

Mass = density x volume

Density will be a value specific to the material used. The volume will be a value from solidworks, because solidworks is able to calculate the volume of complex parts accurately.

3D printed parts

The material that will be used for 3D printed parts is PLA plastic. ρPLA≔1240 ⋅―kg―m

3

Battery holder

Vbh≔30227.85 ⋅mm³

mbh≔ρPLA ⋅Vbh

mbh=0.037 kg

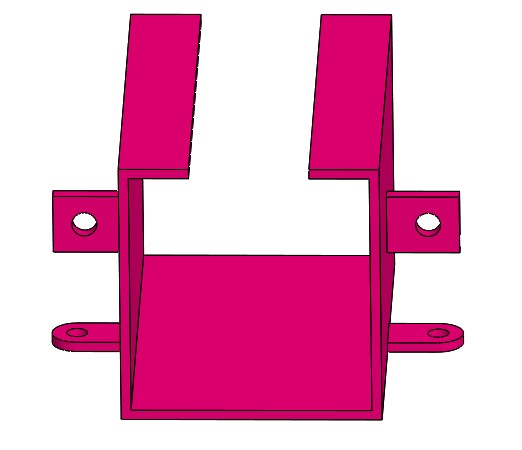
[picture p70: figure]

Motor lifter

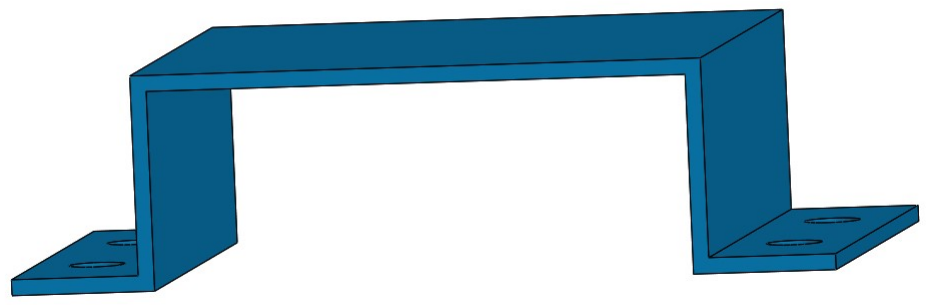
[picture p71: figure]

Vml≔2810.52 ⋅mm³

mml≔ρPLA ⋅Vml

mml=0.003 kg

Non-Commercial Use Only

Lower housing

Vlh≔128903.53 ⋅mm³

mlh≔ρPLA ⋅Vlh

mlh=0.16 kg

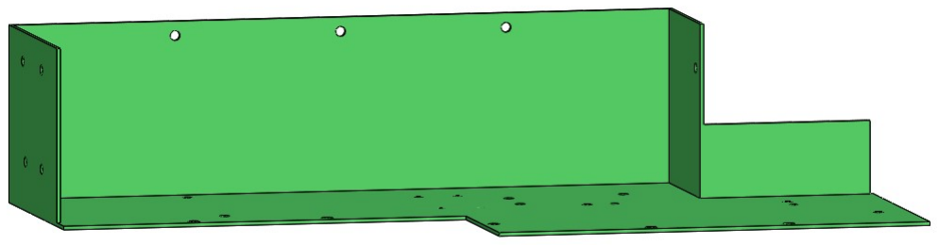
[picture p72: figure]

Upper housing

Vuh≔120305.23 ⋅mm³

muh≔ρPLA ⋅Vuh

muh=0.149 kg

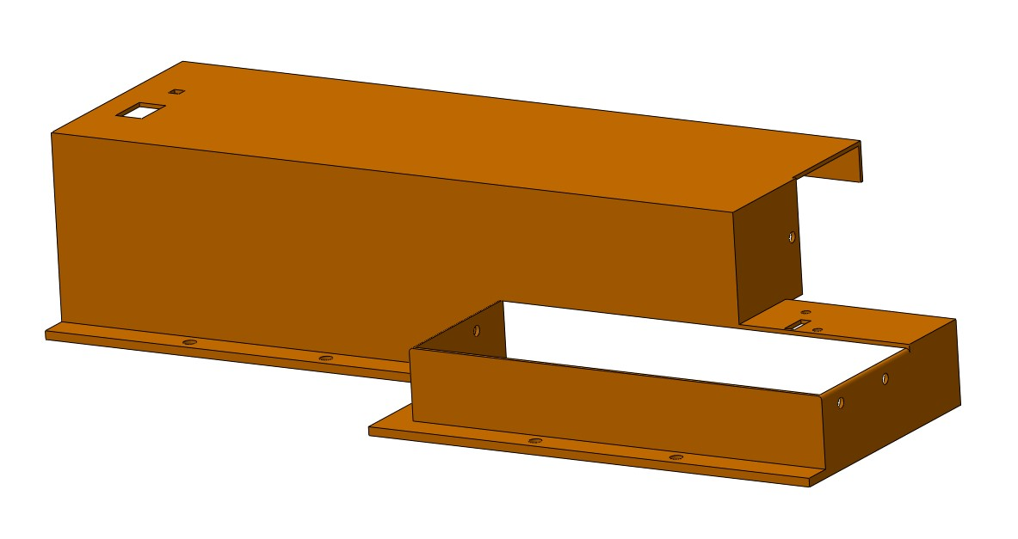
[picture p73: figure]

Handle

Vh≔77838.31 ⋅mm³

mh≔ρPLA ⋅Vh

mh=0.097 kg

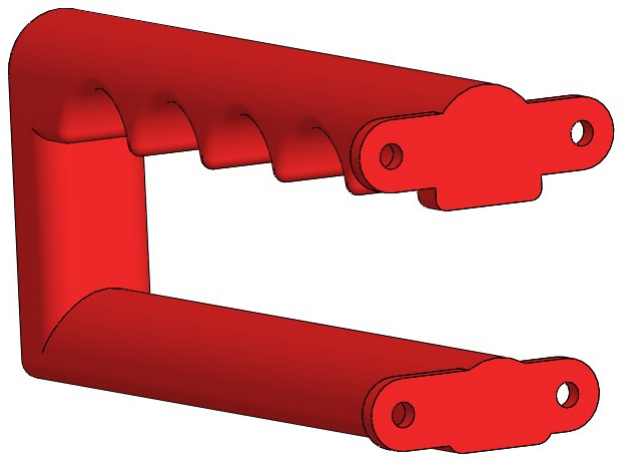
[picture p74: figure]

Angle lock

Val≔409.63 ⋅mm³

mal≔ρPLA ⋅Val

mal=⎛⎝5.079 ⋅ 10⁻⁴⎞
⎠ kg

al

Microswitch holder

Vmch≔3068.22 ⋅mm³

mmch≔ρPLA ⋅Vmch

mmch=0.004 kg

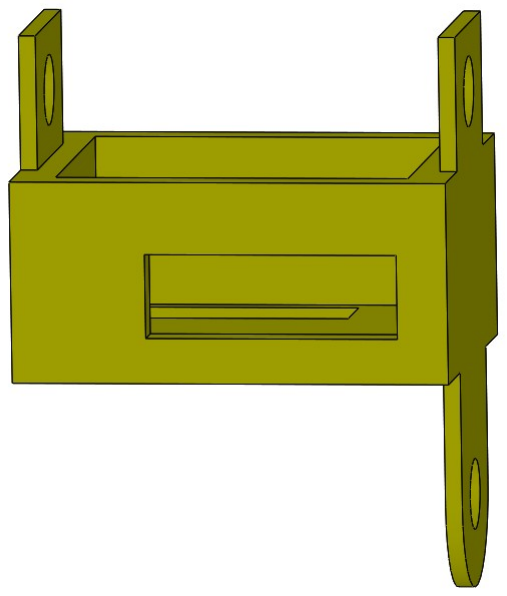
[picture p75: figure]

Microswitch holder two

Vmcht≔3223.97 ⋅mm³

mmcht≔ρPLA ⋅Vmcht

mmcht=0.004 kg

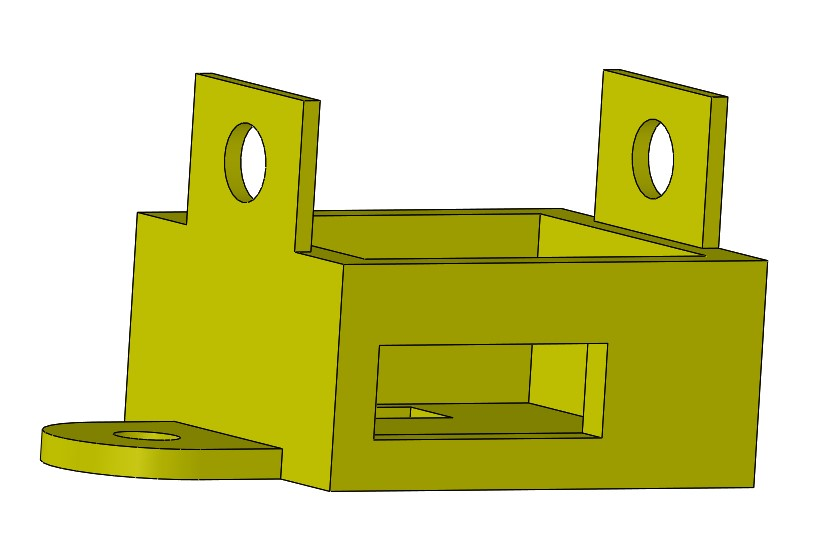
[picture p76: figure]

Two microswitch upper holders

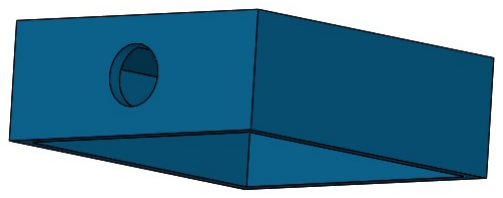
[picture p77: figure]

Vmuh≔1494.40 ⋅mm³

mmuh≔2 ⋅ ρPLA ⋅Vmuh

mmuh=0.004 kg

Two battery clamps

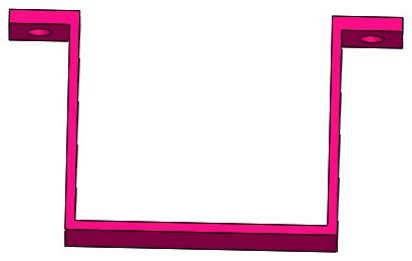
[picture p78: figure]

Vb_clamp≔4286.19 ⋅mm³

mb_c≔2 ⋅ ρPLA ⋅Vb_clamp

mb_c=0.011 kg

M3D_p≔mbh+mml+mlh+muh+mh+mal+mmch+mmcht+mmuh+mb_c

M3D_p=0.469 kg

Sheet metal parts

Sheet metal will be made using hot rolled mild steel. The density varies based on the alloying constituents but usually ranges between 7750 and 8050 kg/m3.

To design for maximum conditions, I'll assume that the density of hot rolled mild steel is 8050 kg/m3.

ρmild_steel≔8050 ⋅―kg―m

3

Base

Vbase≔20288.17 ⋅mm³

mbase≔ρmild_steel⋅Vbase

mbase=0.163 kg

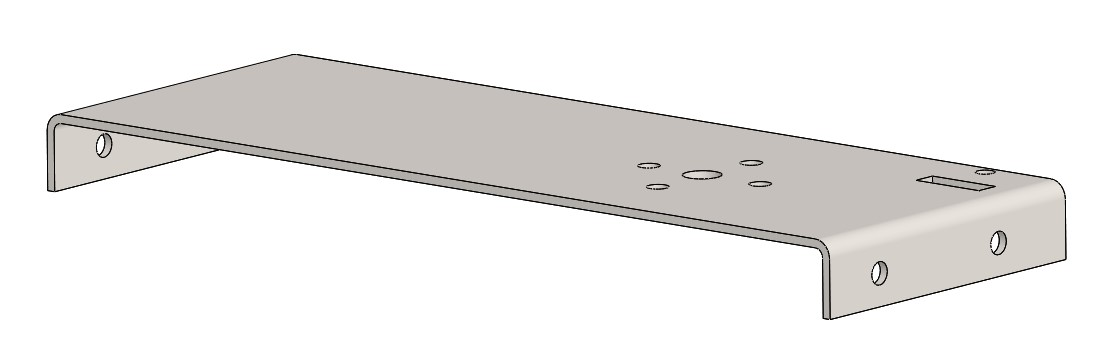
[picture p79: figure]

Lower shaft support

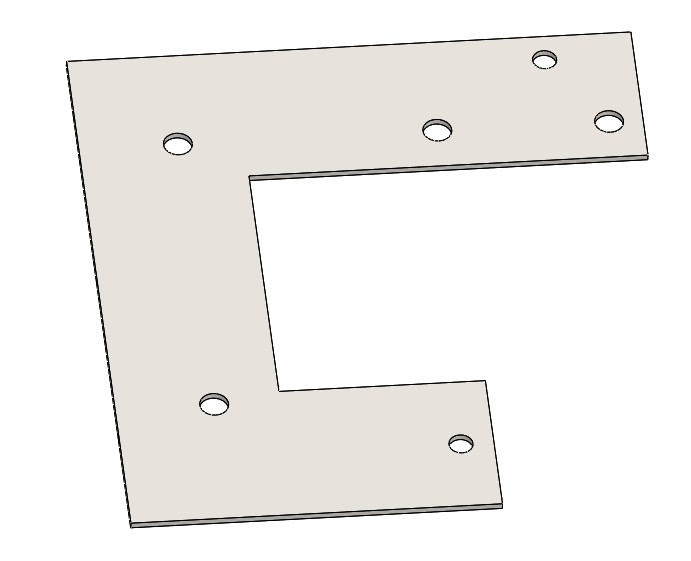
[picture p80: figure]

Vlss≔4197.34 ⋅mm³

mlss≔ρmild_steel⋅Vlss

mlss=0.034 kg

Upper shaft support

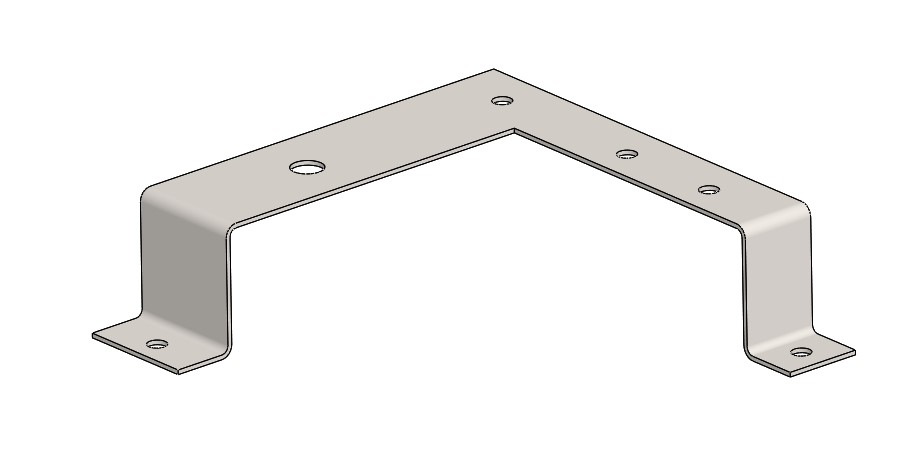
[picture p81: figure]

Vuss≔5116.73 ⋅mm³

muss≔ρmild_steel⋅Vuss

muss=0.041 kg

Motor support

Vmotor_s≔4596.91 ⋅mm³

mmotor_s≔ρmild_steel⋅Vmotor_s

mmotor_s=0.037 kg

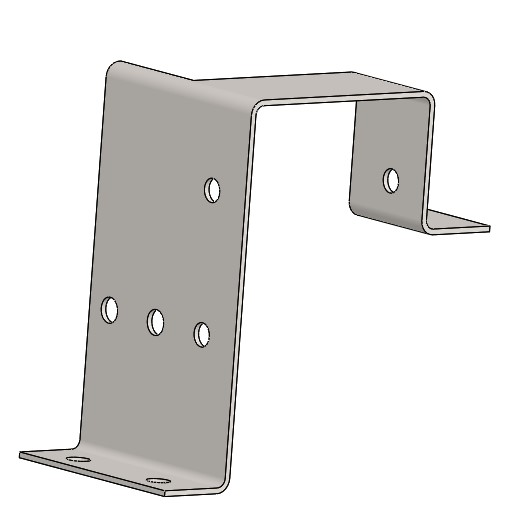
[picture p82: figure]

Two sheet support

Vsheet_s≔552.52 ⋅mm³

msheet_s≔2 ⋅ ρmild_steel⋅Vsheet_s

msheet_s=0.009 kg

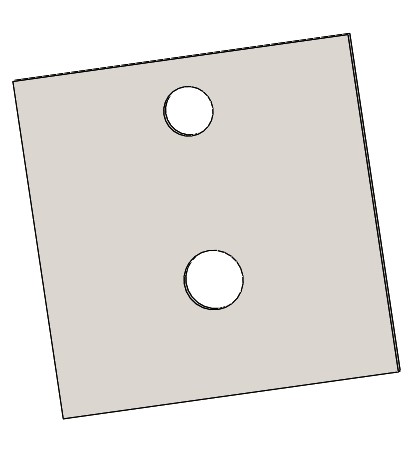
[picture p83: figure]

Two double plate for 48T gear

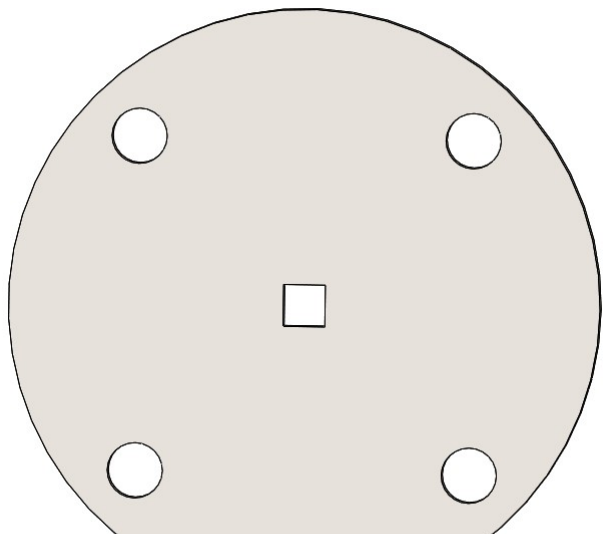
[picture p84: figure]

VD_48T≔3049.80 ⋅mm³

mD_48T≔2 ⋅ ρmild_steel⋅VD_48T

mD_48T=0.049 kg

Double plate for 36T gear

VD_36T≔689.14 ⋅mm³

mD_36T≔ρmild_steel⋅VD_36T

mD_36T=0.006 kg

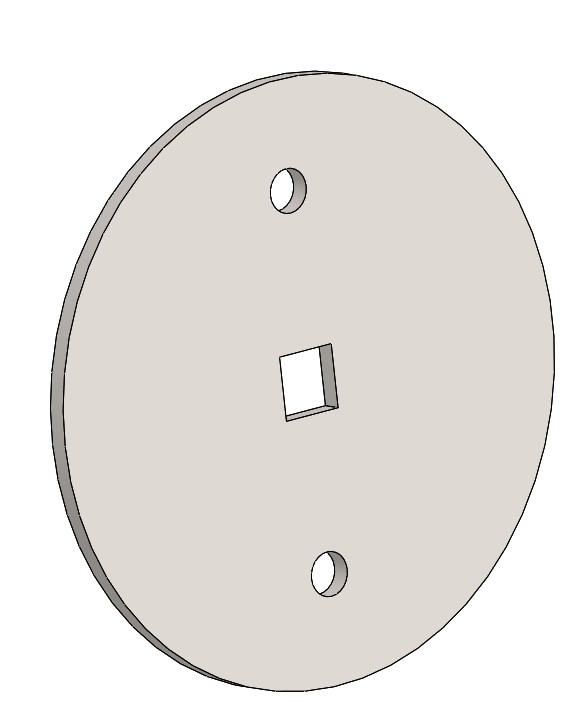
[picture p85: figure]

Double plate for 24T gear

VD_24T≔296.44 ⋅mm³

mD_24T≔ρmild_steel⋅VD_24T

mD_24T=0.002 kg

Total mass of the machined parts:

Ms≔mbase+mlss+muss+mmotor_s+msheet_s+mD_48T+mD_36T+mD_24T

Ms=0.341 kg

Machined parts

Machined components will be made up of low carbon steel. Low carbon steel has a density of
7850 kg/m3.

ρcarbon_steel≔7850 ⋅―kg―m

3

Die positioner

VDie_p≔113.22 ⋅mm³

mDie_p≔ρ | ⋅ carbon_steel VDie_p

mDie_p=⎛⎝8.888 ⋅ 10⁻⁴⎞
⎠ kg

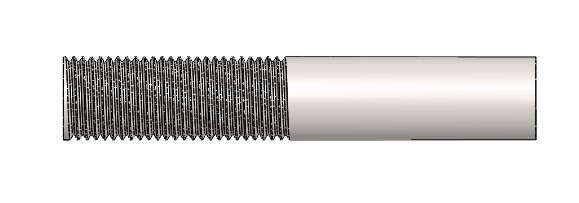
[picture p86: figure]

Die lock

VDie_l≔122.48 ⋅mm³

mDie_l≔ρ | ⋅ carbon_steel VDie_l

mDie_l=⎛⎝9.615 ⋅ 10⁻⁴⎞
⎠ kg

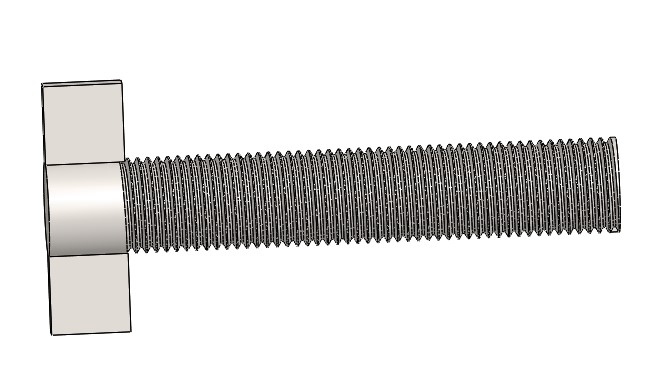
[picture p87: figure]

Clamp platform

VClamp_p≔3055.02 ⋅mm³

mClamp_p≔ρ | ⋅ carbon_steel VClamp_p

mClamp_p=0.024 kg

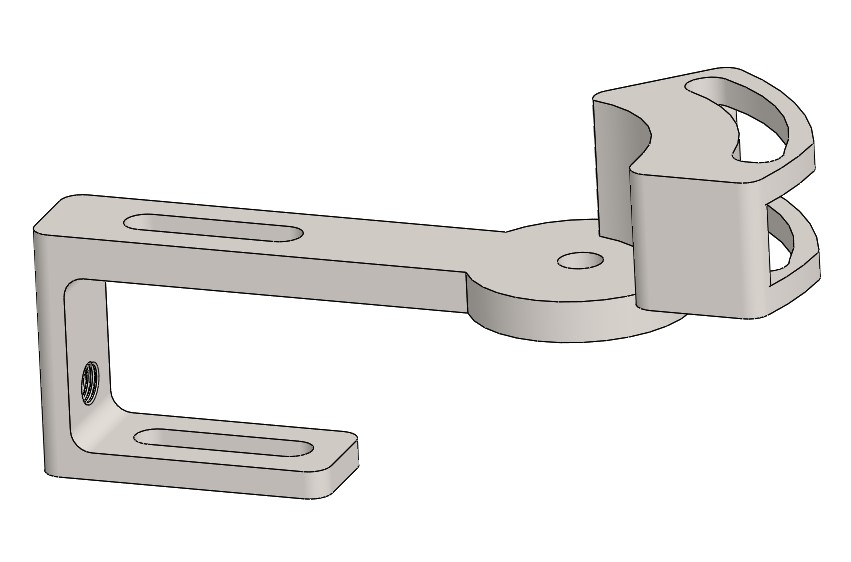
[picture p88: figure]

Circular custom shaft

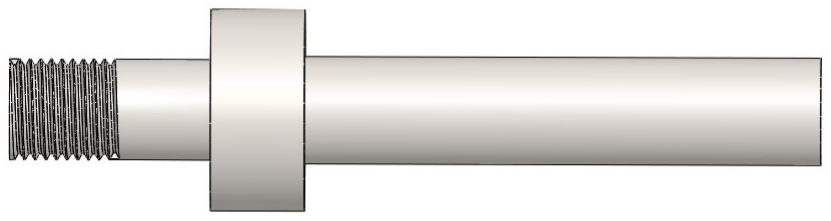
[picture p89: figure]

VCustom_s≔242.83 ⋅mm³

mCustom_s≔ρ | ⋅ carbon_steel VCustom_s

mCustom_s=0.002 kg

Angle positioner

VAngle_p≔94.76 ⋅mm³

mAngle_p≔ρ | ⋅ carbon_steel VAngle_p

mAngle_p=⎛⎝7.439 ⋅ 10⁻⁴⎞
⎠ kg

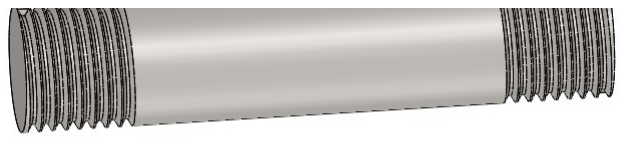
[picture p90: figure]

Bending die

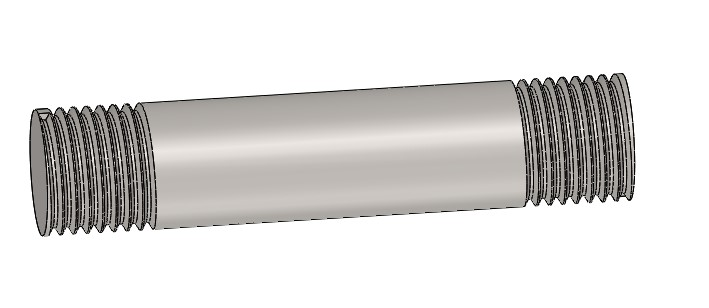
[picture p91: figure]

VDie_b≔229.77 ⋅mm³

mDie_b≔ρ | ⋅ carbon_steel VDie_b

mDie_b=0.002 kg

Total mass of the machined parts:

Mmachine≔mDie_p+mDie_l+mClamp_p+mCustom_s+mAngle_p+mDie_b

Mmachine=0.03 kg

Bought parts

Some parts will be bought. Their mass is given.

100rpm Motor: | mmotor≔0.09 ⋅kg
Two 12T spur gears: | m12T_s≔2 ⋅――⋅ =
| 1.2
| 1000 | kg 0.002 kg
Two 24T bevel gears: | m24T_b≔2 ⋅――⋅ =
| 1.2
| 1000 | kg 0.002 kg
Two 36T spur gears: | m36T_s≔2 ⋅――⋅ =
| 5.2
| 1000 | kg 0.01 kg
Two 48T spur gears: | m48T_s≔2 ⋅――⋅ =
| 7.5
| 1000 | kg 0.015 kg
Square shaft 30 long: | m30_sq≔――⋅ | ⋅ =
| 77

1000 ―30―1000
kg 0.002 kg

Square shaft 70 long: | m70_sq≔――⋅ | ⋅ =
| 77

1000 ―70―1000
kg 0.005 kg
Square shaft 45 long: | m45_sq≔――⋅ | ⋅ =
| 77

1000 ―45―1000
kg 0.003 kg

Three high strength
square shaft 30 long:

m30_hsq≔3 ⋅――⋅ ⋅ =

77

1000 ―30―1000
kg 0.007 kg
Shaft coupler: | mshaft_c≔――⋅ =
| 2.3
| 1000 kg 0.002 kg
Four cells with caps: | mcell_w_caps≔4 ⋅――⋅ =
| 54
| 1000 kg 0.216 kg
Two cell links: | mcell_link≔2 ⋅――⋅ =
| 1
| 1000 kg 0.002 kg
Fused link: | mfused_link≔――⋅ =
| 1.5
| 1000 kg 0.002 kg
Two microswitches: | mmicroswitch≔2 ⋅――⋅ =
| 2.2
| 1000 kg 0.004 kg
Ten spacers 3.2 long: | m3.2_spacer≔10 ⋅――⋅ =
| 0.25
| 1000 kg 0.003 kg
Spacer 6.4 long: | m6.4_spacer≔――⋅ =
| 0.5
| 1000 kg ⎛⎝5 ⋅ 10⁻⁴⎞
⎠ kg
Three spacers 9.5 long: | m9.5_spacer≔3 ⋅――⋅ =
| 0.75
| 1000 kg 0.002 kg
Two spacers 12.7 long: | m12.7_spacer≔2 ⋅――⋅ =
| 1
| 1000 kg 0.002 kg
Two button head screws: | mb_screws≔2 ⋅――⋅ =
| 1.3
| 1000 kg 0.003 kg

m2.9x6.5_screws≔6 ⋅――⋅ =

1.3
Six (2.9x6.5) self | kg 0.008 kg

tapping screws:

2.9x6.5_screws
1000

Twelve (3.5x9.5) self
tapping screws:

m3.5x9.5_screws≔12 ⋅――⋅ =

1.5
1000

kg 0.018 kg

Four (4.2x16) self
tapping screws:

m4.2x16_screws≔12 ⋅――⋅ =

1.6
1000

kg 0.019 kg

Twenty one (4.2x9.5)
self tapping screws:

m4.2x9.5_screws≔21 ⋅――⋅ =

1.6
1000

kg 0.034 kg

Seven hex M5 (16x10)
bolts:

m16x10_bolt≔7 ⋅――⋅ =

2.72
1000

kg 0.019 kg

Seven hex M5 nut: | mM5_nut≔7 ⋅――⋅ =
| 0.85
| 1000 kg 0.006 kg
Five hex M3 nut: | mM3_nut≔5 ⋅――⋅ =
| 0.85
| 1000 kg 0.004 kg
Six M5 washers: | mM5_washer≔6 ⋅――⋅ =
| 0.44
| 1000 kg 0.003 kg
Big roller: | mBig_roller≔――⋅ =
| 65
| 1000 kg 0.065 kg
Push button: | mpush_b≔――⋅ =
| 27
| 1000 kg 0.027 kg
Control switch: | mcontrol_s≔――⋅ =
| 30
| 1000 kg 0.03 kg

M1≔mcontrol_s+mpush_b+mBig_roller+mM5_washer+mM5_nut+mM3_nut+m16x10_bolt+m4.2x9.5_screws

M2≔m4.2x16_screws+m3.5x9.5_screws+m2.9x6.5_screws+mb_screws+m12.7_spacer+m9.5_spacer+m6.4_spacer

M3≔m3.2_spacer+mmicroswitch+mfused_link+mcell_link+mcell_w_caps+mshaft_c+m30_hsq+m45_sq

M4≔m70_sq+m30_sq+m48T_s+m36T_s+m24T_b+m12T_s+mmotor

Total mass of the bought
parts:

Mbought≔M1+M2+M3+M4

Mbought=0.607 kg

Total CAD mass: | Mtot≔Mbought+Mmachine+Ms+M3D_p

Mtot=1.447 kg
