Katleho-engineer/Solidworks-design/PDF/Motor 2.pdf

Appendix B: Motor calculations
The motor calculations will be done in the following steps:

### 1. Choose the number of cells that will be used 2. Determine the stall current of the motor 3. Select a motor

Choose the number of cells that will be used

The motor specification document state that the maximum voltage 15V and the cell specification document state that the nominal voltage is 3.2V.

Maximum voltage of that the
motor can take:

Vmax≔15 V

The nominal cell voltage: | Vnominal≔3.2 V

Therefore, using the above information the maximum number of cells that should be connected in series can be calculated.

Maximum number of cells in series: | Nmax≔――― Vmax Vnominal
| Nmax=4.688

Thus, the maximum number of cells in series should be 4.

Number of cells chosen for the design: | Ncells≔4
Supply voltage to the motor: | Vsupply≔V | ⋅ nominal Ncells
| Vsupply=12.8 V

Non-Commercial Use Only

Determine the stall current of the motor

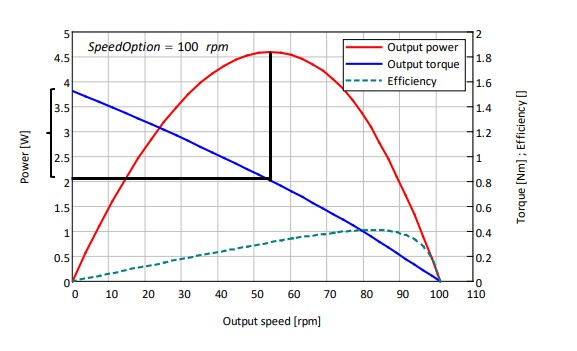
[picture p92: figure]

Figure 1: Curves generated from the motor specification document

The above figure is. The black lines depict that the maximum motor current occurs at half the stall current. Stall current occurs when the output speed is 0rpm.

Thus, in order to determine the maximum motor operating current, stall current and torque must be calculated first.

Stall current occurs at the output speed of 0rpm.

Figure 2: Output speed from the motor specification document

The equation from figure 2 reduces to the one on the left due to the output speed equating to 0rpm.

Figure 3: armature resistance equation from the motor specification document

Using the reduced equation from figure 2 and the armature resistance equation from figure 3, the below calculations are done.

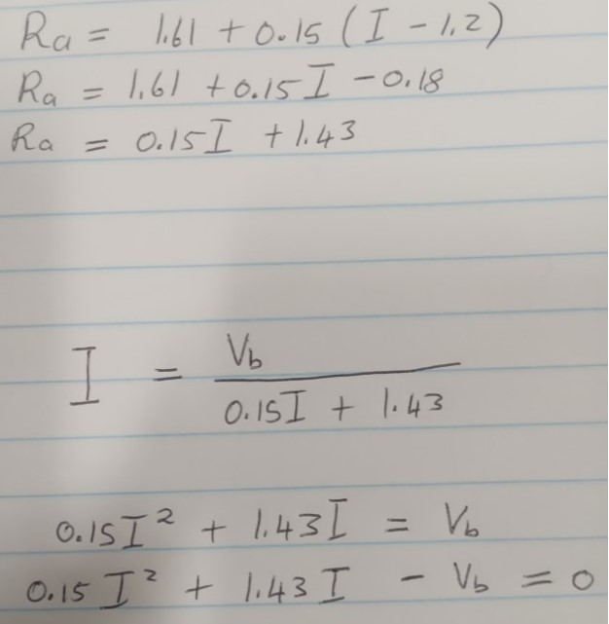
[picture p93: figure]
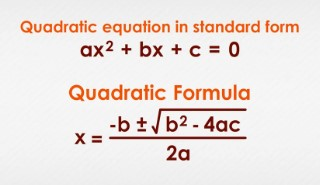
[picture p94: figure]

Quadratic equation will be used to solve for the stall current.

Stall current: | Istall≔

⎛
⎜

⎝―-1.43―+――――――――――

- 1.43² 4 ⋅ ((0.15)) ⋅ ((-12.8)) 2 ⋅ 0.15

⎞
⎟
⎠

A

Istall=5.628 A

Select a motor

In order to select the correct motor, the maximum conditions of all the motors will be calculated.

Now that stall current is determined. Stall torque can be calculated.

Figure 4: Output torque equation from the motor specification document

The constants in the above equation are given in the motor specification document, they are listed below.

Torque constant: | KT≔4.1 ⋅N ⋅―mm―A

For the 100 rpm motor

Gearbox reduction ratio: | rg_100≔156.8
Gearbox efficiency: | ηg_100≔0.7
Static drag: | T0_100≔110 ⋅N ⋅mm

Therefore, using the properties above stall torque can be calculated.

Stall current for 100rpm motor: | Tstall_100≔Istall⋅KT ⋅ rg_100 ⋅ηg_100-T0_100

Tstall_100=2.423 N ⋅m

As explained in figure 1 that the maximum motor operating current is when the motor current is at half the stall current. The output torque equation from figure 4 will be used to solve for the maximum motor current.

The maximum motor current

for 100rpm motor: | Imax_100≔―――――― +

⎛
⎜

⎝―――

Tstall_100
2

⎞
⎟
⎠

T0_100

KT ⋅ r ⋅ g_100 ηg_100

Imax_100=2.936 A

Armature resistance for
100rpm motor:

Ra_100≔

⎛
⎜
⎝

1.61+0.15 ⋅

⎛
⎜

⎝―――-

Imax_100

### 1 A

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
Ra_100=1.87 Ω

The maximum output torque
for 100rpm motor:

Tmax_100≔Imax_100 ⋅KT ⋅ rg_100 ⋅ηg_100-T0_100

Tmax_100=1.211 N ⋅m

Overload time to trip for
100rpm motor:
ttrip_100≔140 ⋅ | ⋅

⎛
⎜

⎝―――

Imax_100
1 ⋅A

⎞
⎟
⎠

-3.54
s

ttrip_100=3.091 s

Output speed for
100rpm motor:

wm_100≔――――――――

Vsupply-Imax_100 ⋅Ra_100

KT ⋅ rg_100

wm_100=11.367 ―rad―s

For the 160 rpm motor

Gearbox reduction ratio: | rg_160≔98
Gearbox efficiency: | ηg_160≔0.72
Static drag: | T0_160≔85 ⋅N ⋅mm

As explained in figure 1 that the maximum motor operating current is when the motor current is at half the stall current. The output torque equation from figure 4 will be used to solve for the maximum motor current.

Stall current for 160rpm motor: | Tstall_160≔Istall⋅KT ⋅ rg_160 ⋅ηg_160-T0_160

Tstall_160=1.543 N ⋅m

The maximum motor current

for 160rpm motor: | Imax_160≔―――――― +

⎛
⎜

⎝―――

Tstall_160
2

⎞
⎟
⎠

T0_160

KT ⋅ r ⋅ g_160 ηg_160

Imax_160=2.961 A

Armature resistance for
160rpm motor:

Ra_160≔

⎛
⎜
⎝

1.61+0.15 ⋅

⎛
⎜

⎝―――-

Imax_160

### 1 A

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
Ra_160=1.874 Ω

The maximum output torque
for 160rpm motor:

Tmax_160≔Imax_160 ⋅KT ⋅ rg_160 ⋅ηg_160-T0_160

Tmax_160=0.772 N ⋅m

Overload time to trip for
160rpm motor:
ttrip_160≔140 ⋅ | ⋅

⎛
⎜

⎝―――

Imax_160
1 ⋅A

⎞
⎟
⎠

-3.54
s

ttrip_160=3.001 s

Output speed for
160rpm motor:

wm_160≔――――――――

Vsupply-Imax_160 ⋅Ra_160

KT ⋅ rg_160

wm_160=18.045 ―rad―s

For the 240 rpm motor

Gearbox reduction ratio: | rg_240≔65.33
Gearbox efficiency: | ηg_240≔0.75
Static drag: | T0_240≔65 ⋅N ⋅mm

As explained in figure 1 that the maximum motor operating current is when the motor current is at half the stall current. The output torque equation from figure 4 will be used to solve for the maximum motor current.

Stall current for 240rpm motor: | Tstall_240≔Istall⋅KT ⋅ rg_240 ⋅ηg_240-T0_240

Tstall_240=1.066 N ⋅m

The maximum motor current

for 240rpm motor: | Imax_240≔―――――― +

⎛
⎜

⎝―――

Tstall_240
2

⎞
⎟
⎠

T0_240

KT ⋅ r ⋅ g_240 ηg_240

Imax_240=2.976 A

Armature resistance for
240rpm motor:

Ra_240≔

⎛
⎜
⎝

1.61+0.15 ⋅

⎛
⎜

⎝―――-

Imax_240

### 1 A

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
Ra_240=1.876 Ω

The maximum output torque
for 240rpm motor:

Tmax_240≔Imax_240 ⋅KT ⋅ rg_240 ⋅ηg_240-T0_240

Tmax_240=0.533 N ⋅m

Overload time to trip for
240rpm motor:
ttrip_240≔140 ⋅ | ⋅

⎛
⎜

⎝―――

Imax_240
1 ⋅A

⎞
⎟
⎠

-3.54
s

ttrip_240=2.948 s

Output speed for
240rpm motor:

wm_240≔――――――――

Vsupply-Imax_240 ⋅Ra_240

KT ⋅ rg_240

wm_240=26.94 ―rad―s

rpm_motor≔1

The results for the different motors can be summarised in the below table.

Compare

100 rpm_motor
160 rpm_motor
240 rpm_motor

Maximum_current

((A))

2.936
2.961
2.976

Trip_time

((s))

3.091
3.001
2.948

Output_torque

((N ⋅m))

1.211
0.772
0.533

Output_speed
⎛
⎜

⎝―rad―s

⎞
⎟
⎠
11.367
18.045
26.94

Thus, for this design the 100rpm motor will be used because it has the largest output torque and longest trip time.

Largest output torque allows one to design the gearbox with a low gear ratio.

Longest trip time gives the design more time to achieve the goal before it stops working.
