Katleho-engineer/Solidworks-design/PDF/Strength 6.pdf

Appendix F: Strength calculations

| Maximum Torque [Nm] | Experience d Torque [Nm] | Maximum tangential force [N] | Experience d tangential force [N] | Experience d radial force [N] | Rotational speed [rad/s]
Gear 1 [12T] | 3 | 0.941 | 450 | 148.228 | 53.95 | 14.537
Gear 2 [36T] | 3.4 | 2.627 | 700 | 137.879 | 50.184 | 4.508
Gear 3 [24T] | 3 | 2.627 | 300 | 206.819 | 75.276 | 4.508
Gear 4 [24T] | 3 | 2.489 | 300 | 195.99 | 71.335 | 4.272
Gear 5 [12T] | 3 | 2.489 | 450 | 391.98 | 142.669 | 4.272
Gear 6 [36T] | 3.4 | 6.946 | 700 | 364 | 132.709 | 1.324
Gear 7 [24T] | 1 | 6.946 | 580 | 546.923 | 199.064 | 1.324
Gear 8 [48T] | 1.2 | 13.269 | 580 | 522.417 | 190.144 | 0.638
Gear 9 [48T] | 1.2 | 12.922 | 580 | 508.74 | 185.166 | 0.621

Figure 1: Summary of calculations from Appendix C

In the summary calculations from figure 1, it can be seen that Gear 6, 7, 8 and 9 need to be reinforced because the torque they experience is greater that the torque it can withstand.

Gear 6

Gear 6 is 36 teeth spur gear.

Gear 6 yield strength: | Sy_gear6≔66 MPa
Gear 6 maximum torque: | Tmax_gear6≔3.4 N ⋅m
Gear 6 boss thickness: | tboss_gear6≔9.5 mm

Non-Commercial Use Only

The k-factor for gear 6 can be calculated using the above properties.

Gear 6 k-factor: | kgear6≔――――――

Tmax_gear6

t | ⋅ boss_gear6 Sy_gear6

kgear6=5.423 mm²

Now the thickness of the sheet metal plate can be determined. Sheet metal is made with hot rolled mild plate

The sheet metal plate yield
strength:

Sy_plate1≔250 MPa

Torque experienced by the
plate:

Tplate1≔6.946 N ⋅m

kgear6≔39 mm²

Plate thickness needed by
the plate:

tplate1≔―――――

Tplate1

k ⋅ gear6 Sy_plate1

tplate1=0.712 mm

Gear 7

Gear 7 is 24 teeth spur gear.

Gear 7 yield strength: | Sy_gear7≔66 MPa
Gear 7 maximum torque: | Tmax_gear7≔1 N ⋅m
Gear 7 boss thickness: | tboss_gear7≔9.5 mm

The k-factor for gear 7 can be calculated using the above properties.

Gear 7 k-factor: | kgear7≔――――――

Tmax_gear7

t | ⋅ boss_gear7 Sy_gear7

kgear7=1.595 mm²

Now the thickness of the sheet metal plate can be determined. Sheet metal is made with hot rolled mild plate

The sheet metal plate yield
strength:

Sy_plate7≔250 MPa

Torque experienced by the
plate:

Tplate7≔6.946 N ⋅m

kgear7≔29 mm²

Plate thickness needed by
the plate:

tplate7≔―――――

Tplate7

k ⋅ gear7 Sy_plate7

tplate7=0.958 mm

Gear 8

Gear 8 is 48 teeth spur gear.

Gear 8 yield strength: | Sy_gear8≔66 MPa
Gear 8 maximum torque: | Tmax_gear8≔1 N ⋅m
Gear 8 boss thickness: | tboss_gear8≔9.5 mm

The k-factor for gear 8 can be calculated using the above properties.

Gear 8 k-factor: | kgear8≔――――――

Tmax_gear8

t | ⋅ boss_gear8 Sy_gear8

kgear8=1.595 mm²

Now the thickness of the sheet metal plate can be determined. Sheet metal is made with hot rolled mild plate

The sheet metal plate yield
strength:

Sy_plate8≔250 MPa

Torque experienced by the
plate:

Tplate8≔13.269 N ⋅m

kgear8≔32 mm²

Plate thickness needed by
the plate:

tplate8≔―――――

Tplate8

k ⋅ gear8 Sy_plate8

tplate8=1.659 mm

Gear 9

Gear 9 is 48 teeth spur gear.

Gear 9 yield strength: | Sy_gear9≔66 MPa
Gear 9 maximum torque: | Tmax_gear9≔1 N ⋅m

Gear 8 boss thickness: | tboss_gear9≔9.5 mm

The k-factor for gear 8 can be calculated using the above properties.

Gear 8 k-factor: | kgear9≔――――――

Tmax_gear9

t | ⋅ boss_gear9 Sy_gear9

kgear9=1.595 mm²

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

The sheet metal plate yield
strength:

Sy_plate9≔250 MPa

Torque experienced by the
plate:

Tplate9≔12.922 N ⋅m

kgear9≔32 mm²

Plate thickness needed by
the plate:

tplate9≔―――――

Tplate9

k ⋅ gear9 Sy_plate9

tplate9=1.615 mm

| Maximum torque [Nm] | Experienced torque [Nm] | Plate thickness needed [mm]
Gear 6 [36T] | 3.4 | 6.946
Gear 7 [24T] | 1 | 6.946
Gear 8 [48T] | 1.2 | 13.269
Gear 9 [48T] | 1.2 | 12.922

Figure 2: Summary table of plate thickness need

The above table shows how much thickness is needed for the plates to reinforce the gears that need to be supported.

Base

The base of the pipe bending platform has a lot of parts on it. Thus, it will experience forces due to the weight of the parts. The forces can be converted to stresses.

Big roller

Big roller mass: | Mbig_roller≔――⋅
| 22.72
| 1000

kg

Big roller force: | Fbig_roller≔M | ⋅ big_roller

⎛
⎜
⎝

9.81 ―m
s

2

⎞
⎟
⎠

Fbig_roller=0.223 N

Big roller outer radius: | ODbig_roller≔―35
| 2

mm

Big roller inner radius: | IDbig_roller≔―8
| 2

mm

Big roller area: | Abig_roller≔π⋅ ⎛ ⎝ODbig_roller -
2
IDbig_roller

2 ⎞
⎠
Big roller stress: | σbig_roller≔――― Fbig_roller Abig_roller
| σbig_roller=244.43 Pa

Pipe support

Pipe support mass: | Mpipe_s≔――⋅
| 1.26
| 1000

kg

Pipe support force: | Fpipe_s≔M | ⋅ pipe_s

⎛
⎜
⎝

9.81 ―m
s

2

⎞
⎟
⎠

Fpipe_s=0.012 N

Pipe support area: | Apipe_s≔26 ⋅ 21 mm²
Pipe support stress: | σpipe_s≔――― Fpipe_s Apipe_s σpipe_s=22.638 Pa

Lower & upper microswitch holder and microswitch

Lower & upper microswitch holder and microswitch mass [lum]: | Mlum ≔――⋅
| 19.1
| 1000 kg

Lower & upper microswitch
holder and microswitch force [lum]:

Flum ≔M ⋅ lum

⎛
⎜
⎝

9.81 ―m
s

2

⎞
⎟
⎠

Flum =0.187 N

Lower & upper microswitch
holder and microswitch area [lum]:

Alum ≔26 ⋅ 7 mm²

Lower & upper microswitch
holder and microswitch
stress [lum]:

σlum ≔――

Flum

Alum

σlum =⎛⎝1.03 ⋅ 10³ ⎞
⎠ Pa

Total stress on the base

Total stress on the base: | σbase_ex≔σlum +σpipe_s+σbig_roller

σbase_ex=0.001 MPa

The base tensile strength at
yield:

σbase_yield≔220 MPa

Factor of safety: | FOCbase≔――― σbase_yield σbase_ex

FOCbase=1.697 ⋅ 10⁵

Lower casing

The base of the lower housing has a lot components, it will be 3D printed using PLA plastic. Thus, it needs to be ensured that it will not fail due bending.

Total mass of the parts
acting on the lower housing:

Mlower_s≔――⋅

560
1000

kg

Total mass of the parts
acting on the lower housing:
Flower_s≔M | ⋅ lower_s

⎛
⎜
⎝

9.81 ―m
s

2

⎞
⎟
⎠

Flower_s=5.494 N

Total mass of the parts
acting on the lower housing:

Alower_s≔44899.54 mm²

Total mass of the parts
acting on the lower housing:

σlower_s≔―――

Flower_s

Alower_s

σlower_s=122.353 Pa

The stress experienced by the lower housing is very small compared to the lower housing flexural strength. Thus, the lower housing will be able to withstand bending forces applied perpendicular to its longitudinal axis.

Flexural strength of the
lower housing:

σflexural_lower_s≔80 MPa

Factor of safety: | FOClower_s≔――――― σflexural_lower_s σlower_s

FOClower_s=6.538 ⋅ 10⁵

Bending die

Bending die is responsible for bending the pipe and it will be in contact with the pipe. Thus, the strength of the bending die needs to be determined.

The bending die will be machined using low carbon steel

Bending die tensile strength: | σtensile_die≔550 MPa
Bending die yield strength: | σyield_die≔250 MPa

The tensile stress experienced by the die can be determined. By first determining the force the will be experienced by the die.

The calculate bending moment of the die: | Mdie≔12.922 N ⋅m

The distance that the force is
acting:

Ddie≔10 mm

The area that the force is
acting:

Adie≔75.4 mm²

The force acting on the die: | Fdie≔―― Mdie Ddie
| Fdie=⎛⎝1.292 ⋅ 10³ ⎞
⎠ N

The tensile stress acting on the die:

σdie_ex≔――

Fdie

Adie

σdie_ex=17.138 MPa

Factor of safety: | FOCdie≔―――― σtensile_die σdie_ex

FOCdie=32.093

Handle

The handle of the design will be responsible for allowing the user to lift the design, it will be 3D printed using PLA plastic. Thus, it needs to be ensured that it will not .

Total mass of the parts
acting on the handle:

Mhandle≔1.11 ⋅kg

Total mass of the parts
acting on the handle:

Fhandle≔M ⋅ handle

⎛
⎜
⎝

9.81 ―m
s

2

⎞
⎟
⎠

Fhandle=10.889 N

Total mass of the parts
acting on the handle:

Ahandle≔44899.54 mm²

Total mass of the parts
acting on the handle:

σhandle_ex≔―――

Fhandle

Ahandle

σhandle_ex=242.521 Pa

The stress experienced by the lower housing is very small compared to the lower housing flexural strength. Thus, the lower housing will be able to withstand bending forces applied perpendicular to its longitudinal axis.

Flexural strength of the
lower housing:

σflexural_handle≔80 MPa

Factor of safety: | FOChandle≔――――― σflexural_handle σhandle_ex

FOChandle=3.299 ⋅ 10⁵
