Katleho-engineer/Solidworks-design/PDF/Torsion 5.pdf

Appendix E: Torsion calculations

Maximum
Torque
[Nm]

Experience
d
Torque
[Nm]

Maximum
tangential
force [N]

Experience
d tangential
force [N]

Experience
d radial
force [N]

Rotational
speed
[rad/s]
Gear 1 [12T] | 3 | 0.941 | 450 | 148.228 | 53.95 | 14.537
Gear 2 [36T] | 3.4 | 2.627 | 700 | 137.879 | 50.184 | 4.508
Gear 3 [24T] | 3 | 2.627 | 300 | 206.819 | 75.276 | 4.508
Gear 4 [24T] | 3 | 2.489 | 300 | 195.99 | 71.335 | 4.272
Gear 5 [12T] | 3 | 2.489 | 450 | 391.98 | 142.669 | 4.272
Gear 6 [36T] | 3.4 | 6.946 | 700 | 364 | 132.709 | 1.324
Gear 7 [24T] | 1 | 6.946 | 580 | 546.923 | 199.064 | 1.324
Gear 8 [48T] | 1.2 | 13.269 | 580 | 522.417 | 190.144 | 0.638
Gear 9 [48T] | 1.2 | 12.922 | 580 | 508.74 | 185.166 | 0.621

Figure 1: Table from appendix C

The table above shows the summary torque calculated

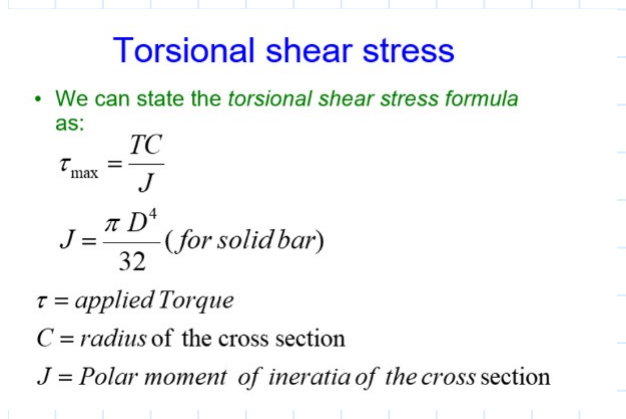
[picture p95: figure]

The above equation from "Mechanic of Materials" 11th edition, written by Russell C. Hibbeler will be used to determine shear strength

Non-Commercial Use Only

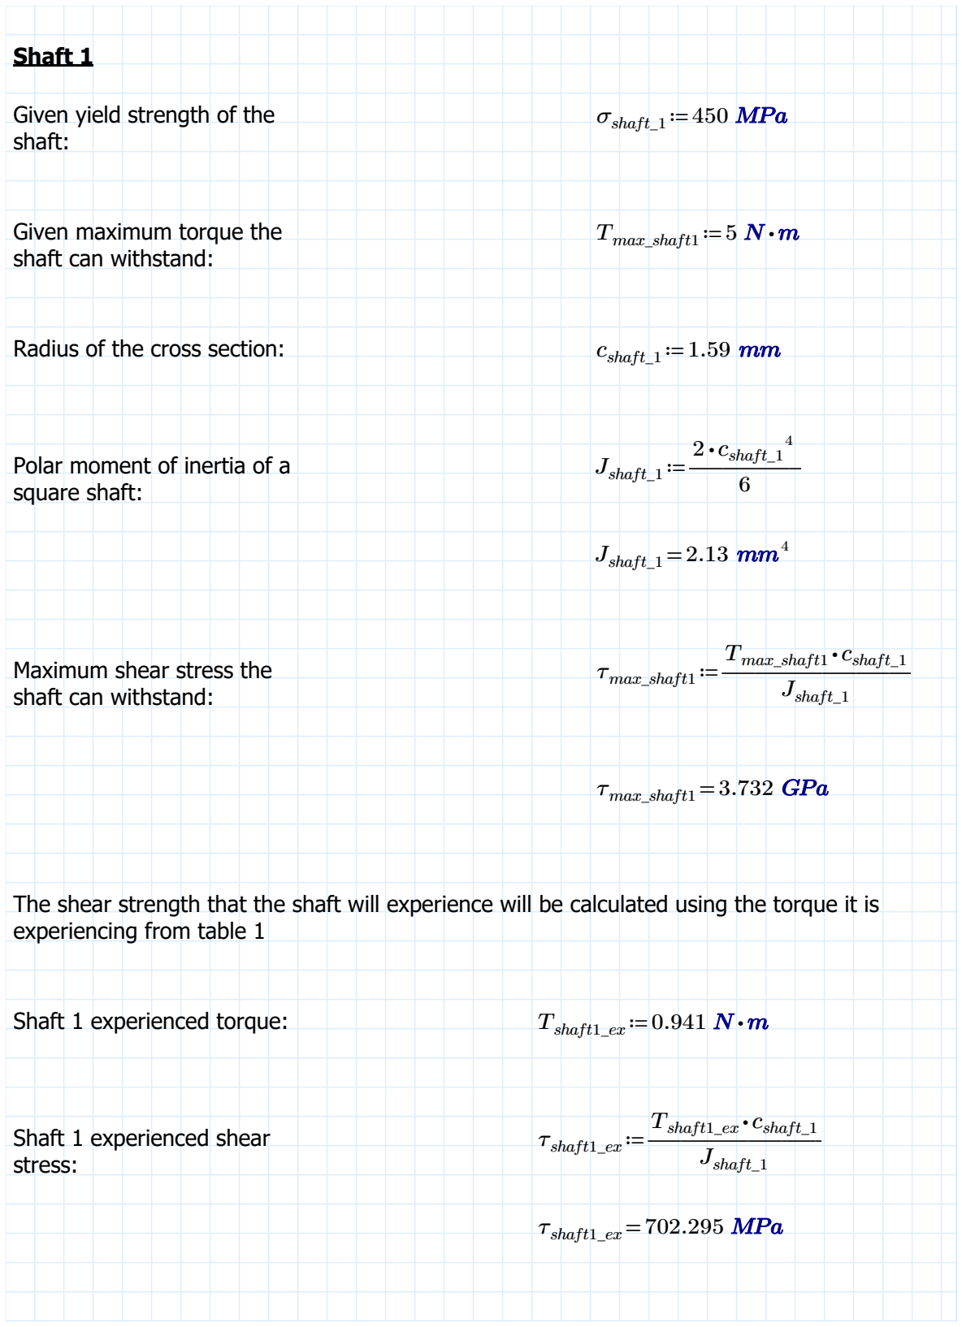
[picture p96: figure]
Shaft 1; Given yield strength of the shaft:; σshaft_1≔450 MPa; Given maximum torque the shaft can withstand:; Tmax_shaft1≔5 N ⋅m; Polar moment of inertia of a square shaft:; Jshaft_1≔――――; 2 ⋅ cshaft_1; Jshaft_1=2.13; mm⁴; Maximum shear stress the shaft can withstand:; τmax_shaft1≔――――――; Tmax_shaft1 ⋅ cshaft_1; Jshaft_1; τmax_shaft1=3.732 GPa; experiencing from table 1; Shaft 1 experienced shear stress:; τshaft1_ex≔――――――; T ⋅ shaft1_ex cshaft_1; τshaft1_ex=702.295 MPa

Radius of the cross section: | cshaft_1≔1.59 | mm

The shear strength that the shaft will experience will be calculated using the torque it is

Shaft 1 experienced torque: | Tshaft1_ex≔0.941 N ⋅m

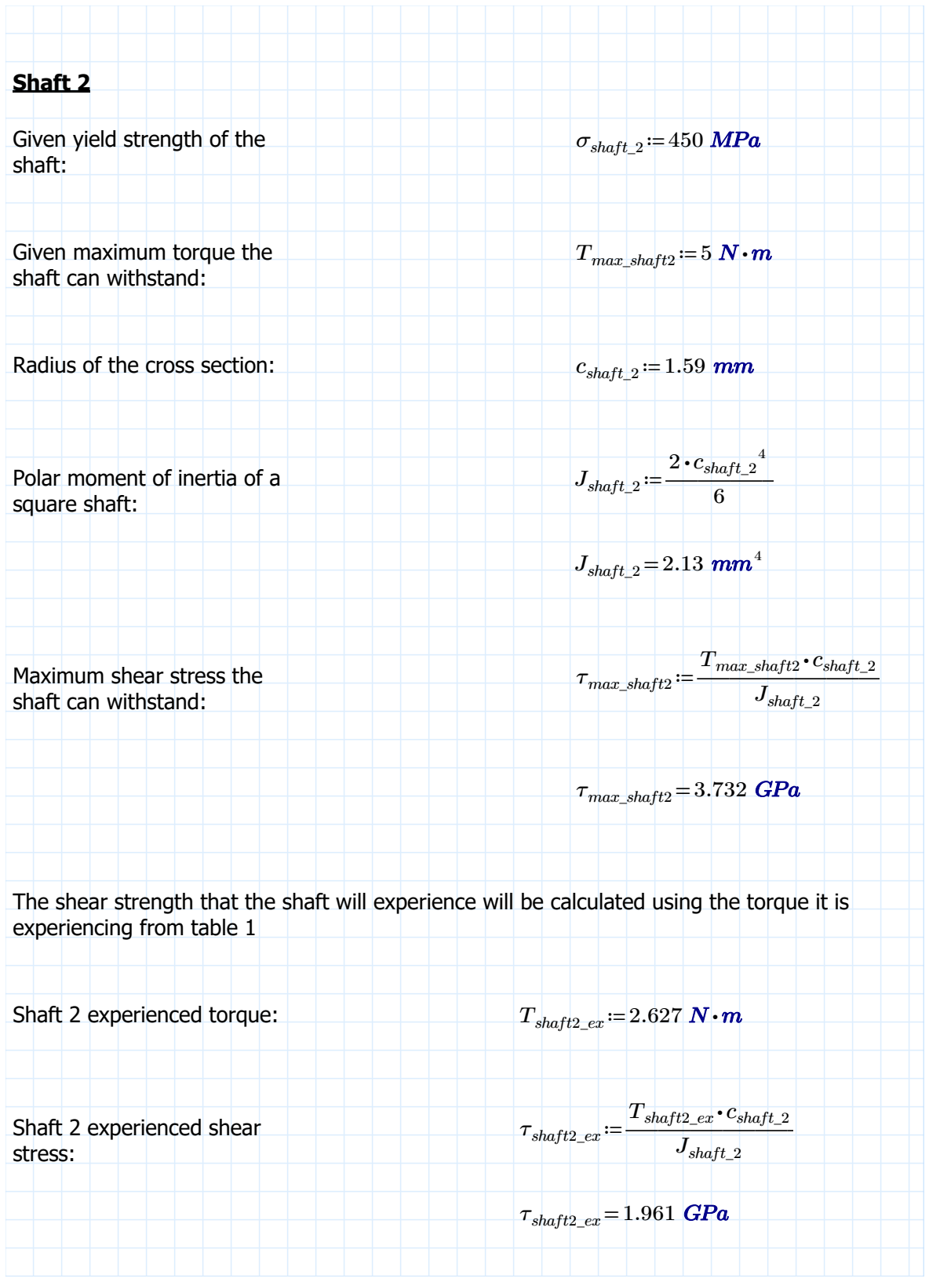
[picture p97: figure]
Shaft 2; Given yield strength of the shaft:; σshaft_2≔450 MPa; Given maximum torque the shaft can withstand:; Tmax_shaft2≔5 N ⋅m; Polar moment of inertia of a square shaft:; Jshaft_2≔――――; 2 ⋅ cshaft_2; Jshaft_2=2.13; mm⁴; Maximum shear stress the shaft can withstand:; τmax_shaft2≔――――――; Tmax_shaft2 ⋅ cshaft_2; Jshaft_2; τmax_shaft2=3.732 GPa; experiencing from table 1; Shaft 2 experienced shear stress:; τshaft2_ex≔――――――; T ⋅ shaft2_ex cshaft_2; τshaft2_ex=1.961; GPa

Radius of the cross section: | cshaft_2≔1.59 | mm

The shear strength that the shaft will experience will be calculated using the torque it is

Shaft 2 experienced torque: | Tshaft2_ex≔2.627 N ⋅m

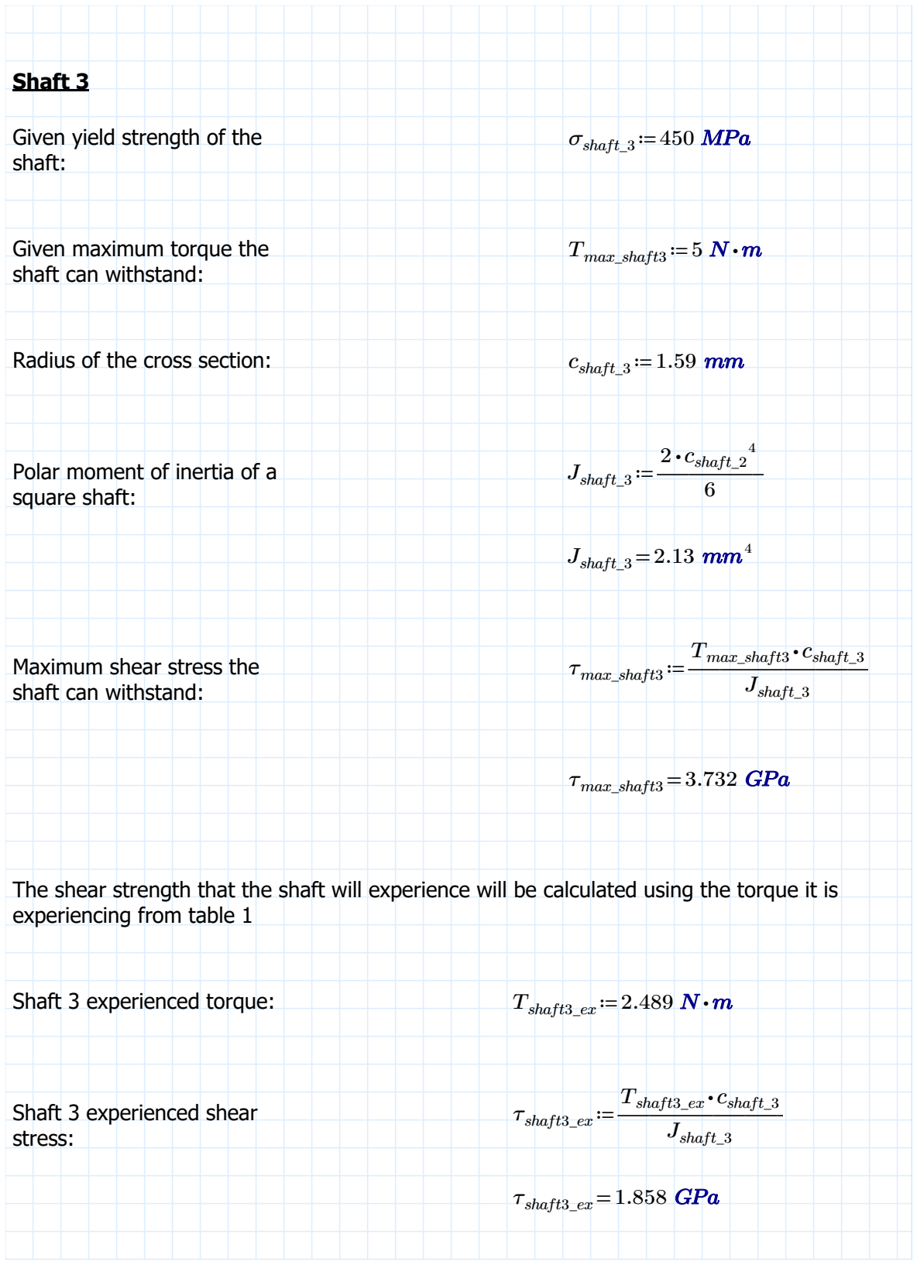
[picture p98: figure]
Shaft 3; Given yield strength of the shaft:; σshaft_3≔450 MPa; Given maximum torque the shaft can withstand:; Tmax_shaft3≔5 N ⋅m; Polar moment of inertia of a square shaft:; Jshaft_3≔――――; 2 ⋅ cshaft_2; Jshaft_3=2.13; mm⁴; Maximum shear stress the shaft can withstand:; τmax_shaft3≔――――――; Tmax_shaft3 ⋅ cshaft_3; Jshaft_3; τmax_shaft3=3.732 GPa; experiencing from table 1; Shaft 3 experienced shear stress:; τshaft3_ex≔――――――; T ⋅ shaft3_ex cshaft_3; τshaft3_ex=1.858; GPa

Radius of the cross section: | cshaft_3≔1.59 | mm

The shear strength that the shaft will experience will be calculated using the torque it is

Shaft 3 experienced torque: | Tshaft3_ex≔2.489 N ⋅m

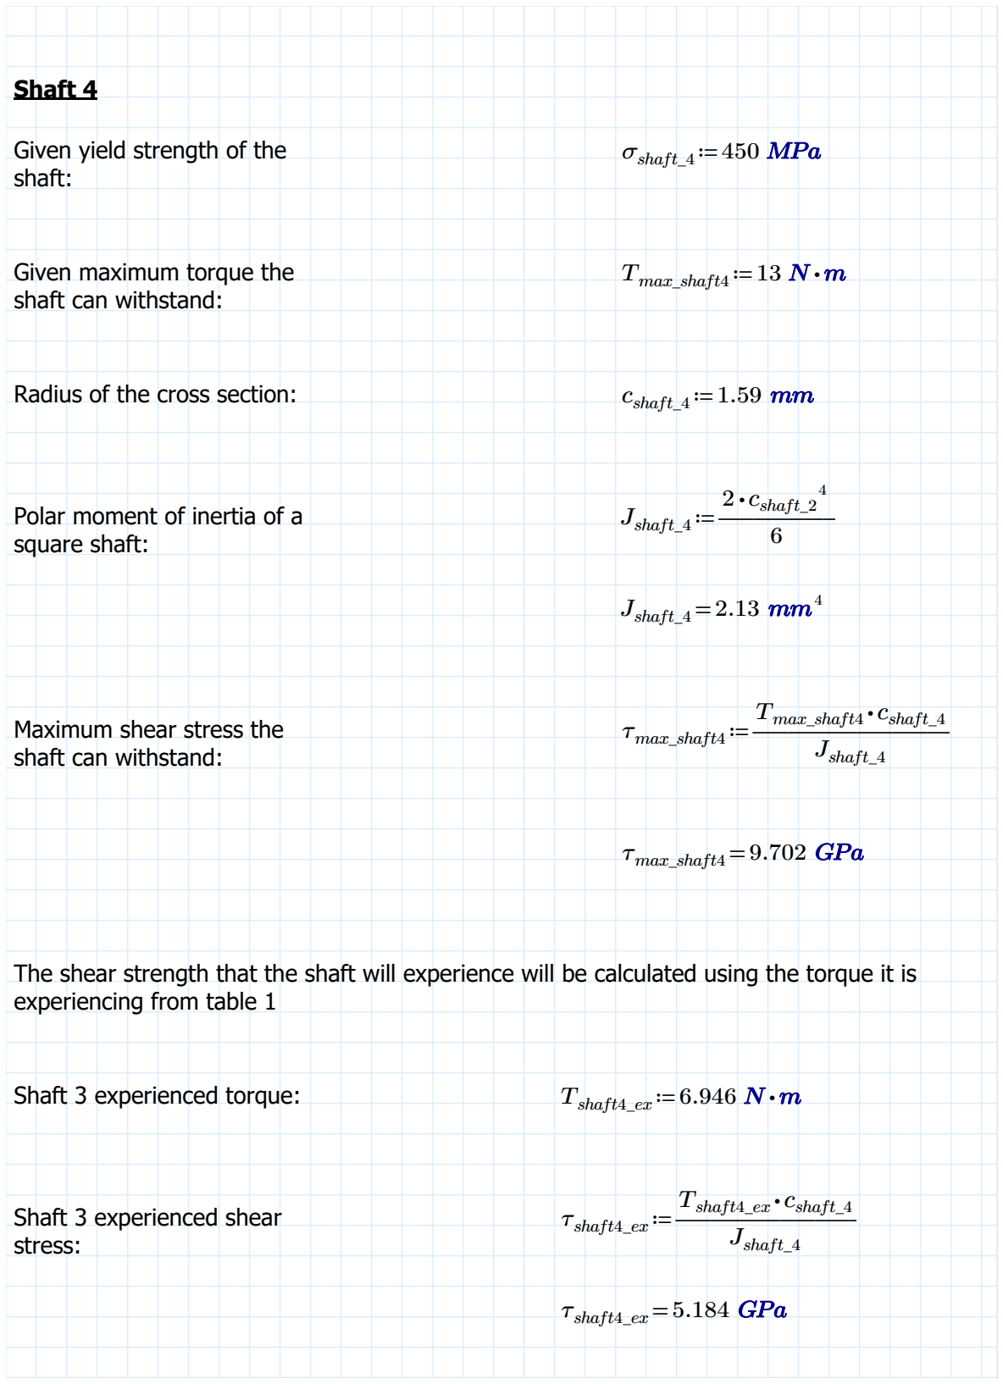
[picture p99: figure]
Shaft 4; Given yield strength of the shaft:; σshaft_4≔450 MPa; Given maximum torque the shaft can withstand:; Tmax_shaft4≔13 N ⋅m; Polar moment of inertia of a square shaft:; Jshaft_4≔――――; 2 ⋅ cshaft_2; Jshaft_4=2.13; mm⁴; Maximum shear stress the shaft can withstand:; τmax_shaft4≔――――――; Tmax_shaft4 ⋅ cshaft_4; Jshaft_4; τmax_shaft4=9.702 GPa; experiencing from table 1; Shaft 3 experienced shear stress:; τshaft4_ex≔――――――; T ⋅ shaft4_ex cshaft_4; τshaft4_ex=5.184; GPa

Radius of the cross section: | cshaft_4≔1.59 | mm

The shear strength that the shaft will experience will be calculated using the torque it is

Shaft 3 experienced torque: | Tshaft4_ex≔6.946 N ⋅m

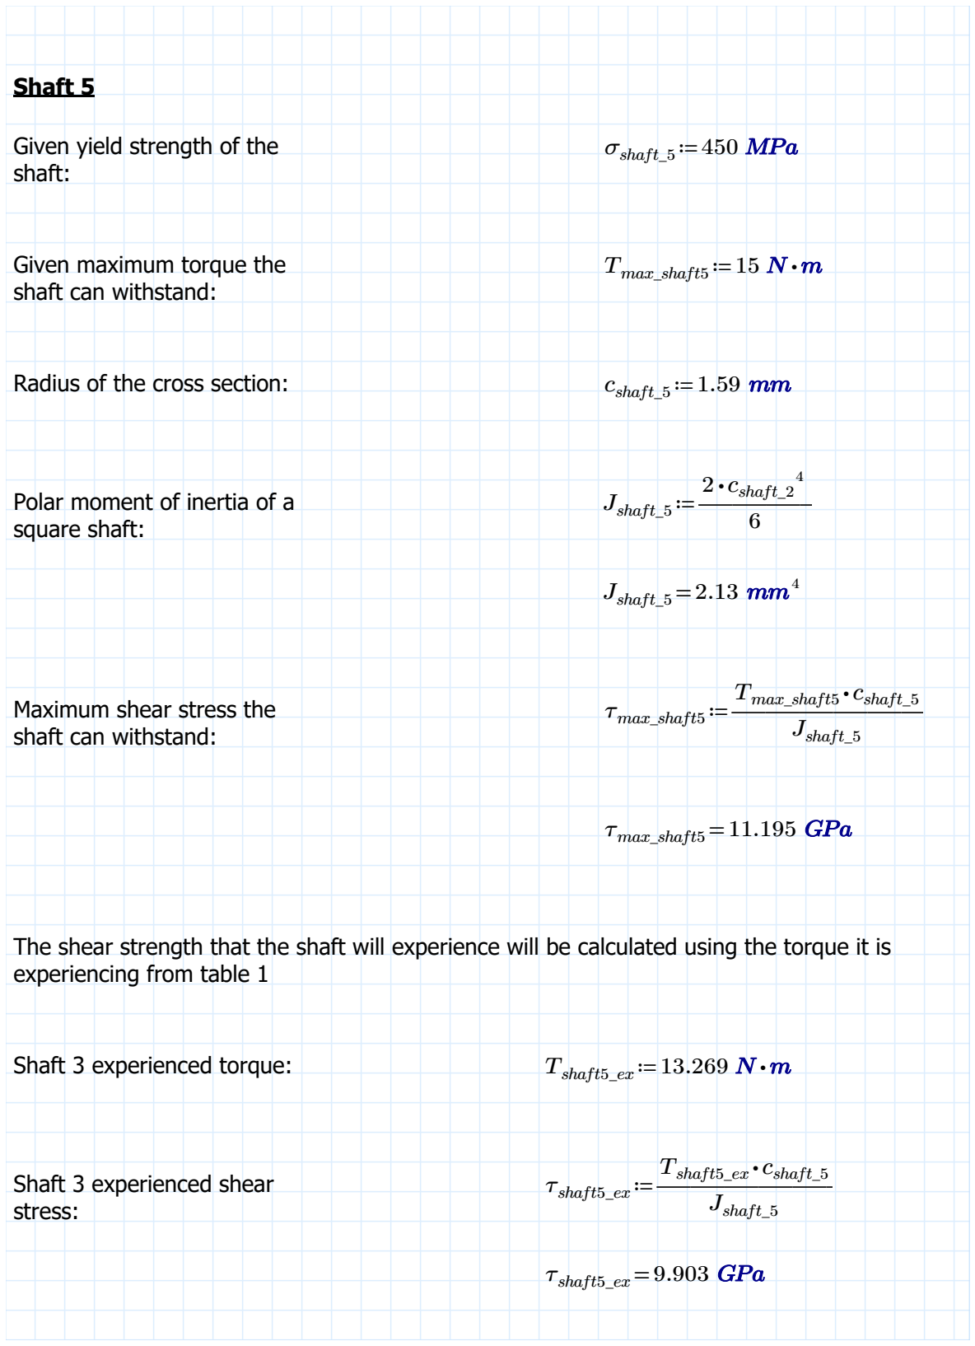
[picture p100: figure]
Shaft 5; Given yield strength of the shaft:; σshaft_5≔450 MPa; Given maximum torque the shaft can withstand:; Tmax_shaft5≔15 N ⋅m; Polar moment of inertia of a square shaft:; Jshaft_5≔――――; 2 ⋅ cshaft_2; Jshaft_5=2.13; mm⁴; Maximum shear stress the shaft can withstand:; τmax_shaft5≔――――――; Tmax_shaft5 ⋅ cshaft_5; Jshaft_5; τmax_shaft5=11.195; GPa; experiencing from table 1; Shaft 3 experienced shear stress:; τshaft5_ex≔――――――; T ⋅ shaft5_ex cshaft_5; τshaft5_ex=9.903

Radius of the cross section: | cshaft_5≔1.59 | mm

The shear strength that the shaft will experience will be calculated using the torque it is

Shaft 3 experienced torque: | Tshaft5_ex≔13.269 N ⋅m

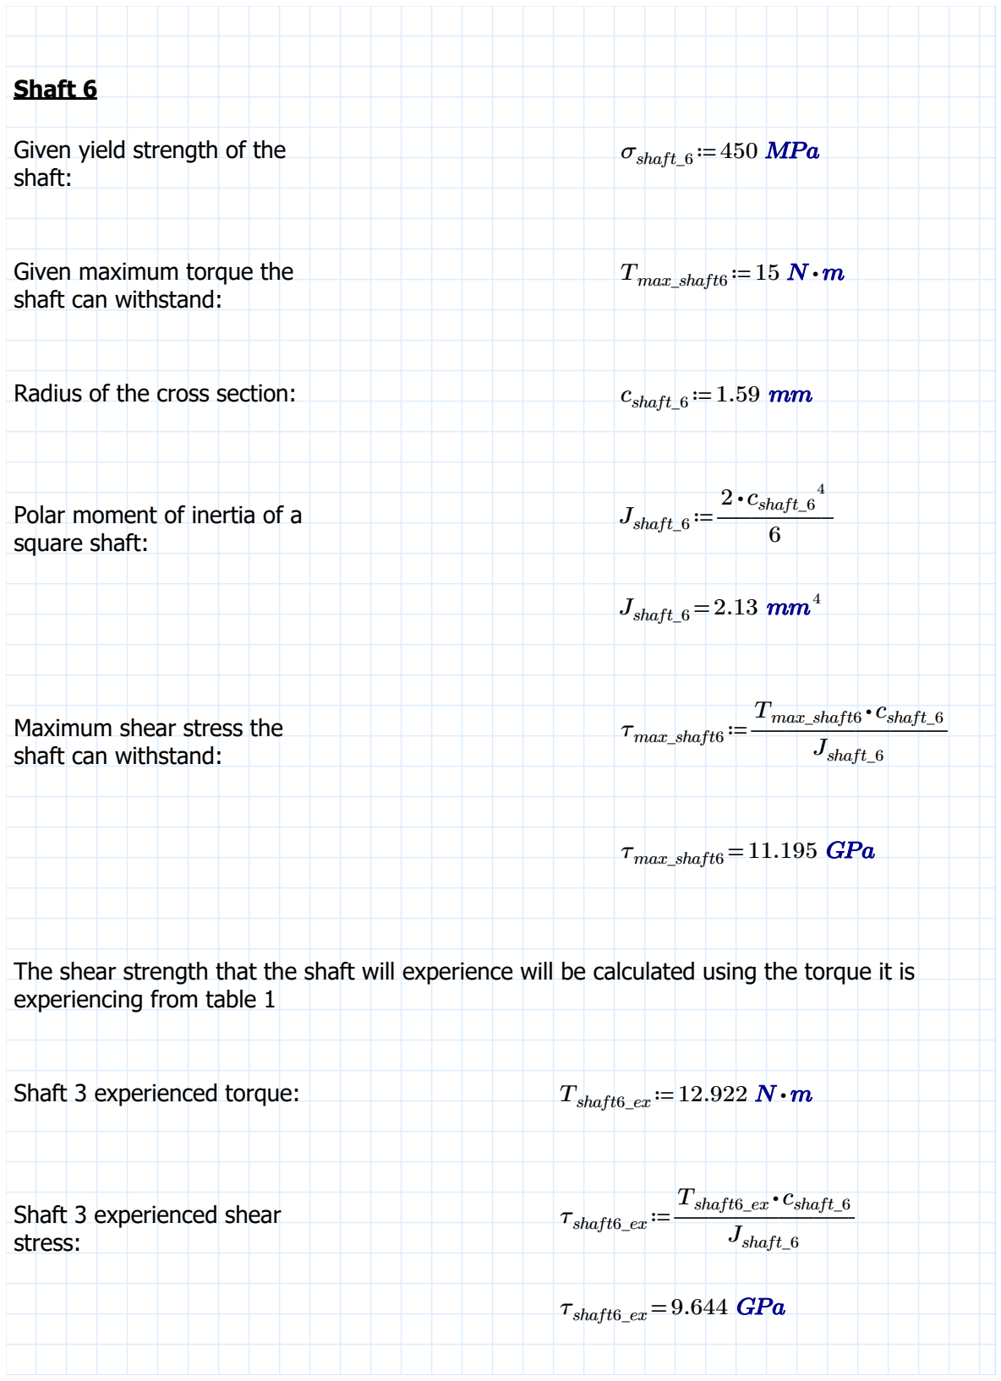
[picture p101: figure]
Shaft 6; Given yield strength of the shaft:; σshaft_6≔450 MPa; Given maximum torque the shaft can withstand:; Tmax_shaft6≔15 N ⋅m; Polar moment of inertia of a square shaft:; Jshaft_6≔――――; 2 ⋅ cshaft_6; Jshaft_6=2.13; mm⁴; Maximum shear stress the shaft can withstand:; τmax_shaft6≔――――――; Tmax_shaft6 ⋅ cshaft_6; Jshaft_6; τmax_shaft6=11.195; GPa; experiencing from table 1; Shaft 3 experienced shear stress:; τshaft6_ex≔――――――; T ⋅ shaft6_ex cshaft_6; τshaft6_ex=9.644

Radius of the cross section: | cshaft_6≔1.59 | mm

The shear strength that the shaft will experience will be calculated using the torque it is

Shaft 3 experienced torque: | Tshaft6_ex≔12.922 N ⋅m
