Katleho-engineer/Solidworks-design/Solidworks/Custom shaft assembly.SLDASM

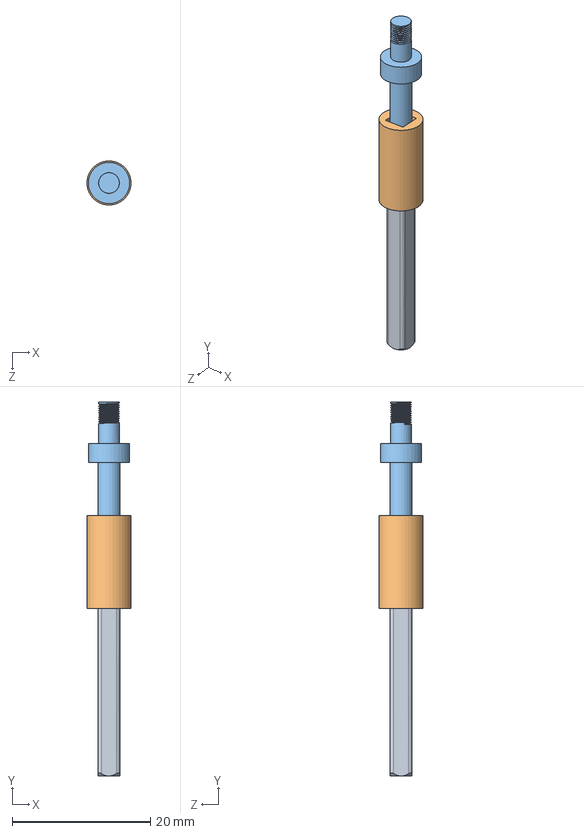
[picture p102: CAD file, 2023-12-31]
Solidworks/Custom shaft assembly.SLDASM
6.40 x 54.2 x 6.40 mm
Shaft High strength
Shaft Coupler
Circular custom shaft
