Katleho-engineer/Solidworks-design/Solidworks/reinforced 48T spur gear.SLDASM

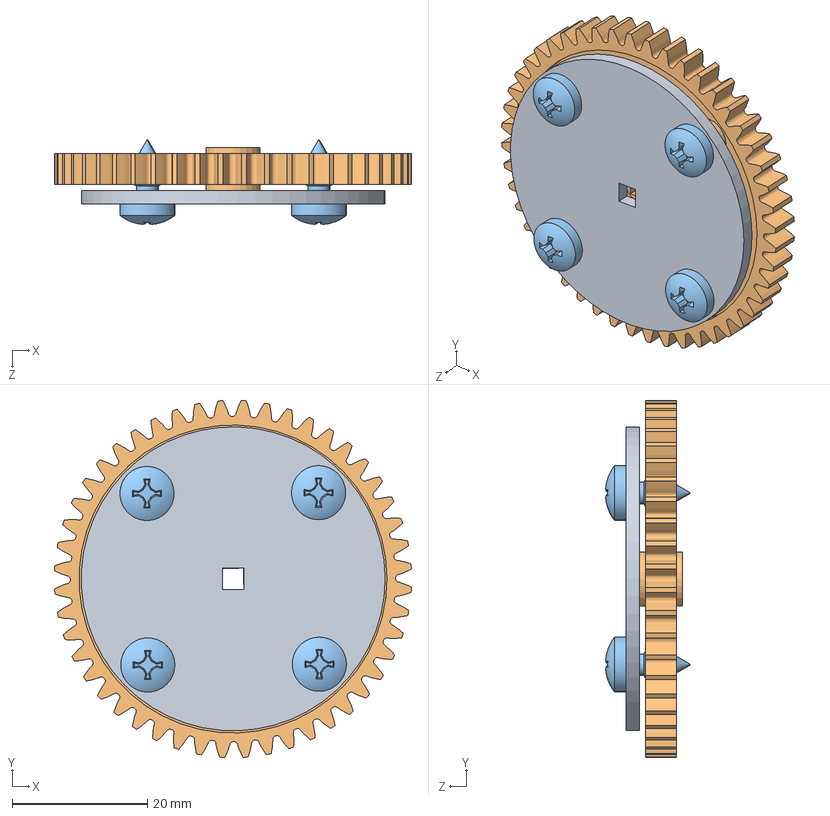
[picture p103: CAD file, 2023-12-31]
Solidworks/reinforced 48T spur gear.SLDASM
52.9 x 52.9 x 12.5 mm
double plate 48T gear
Spur gear
Tapping screw DIN 7049-ST4.2x9.5-C-H-S x 4
