Katleho-engineer/Solidworks-design/Solidworks/Battery Assembly.SLDASM

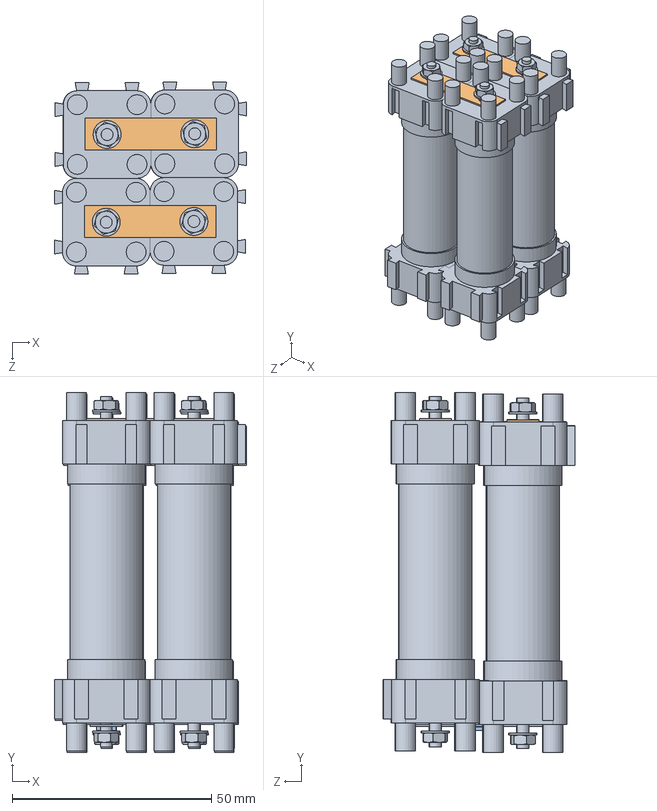
[picture p104: CAD file, 2023-12-31]
Solidworks/Battery Assembly.SLDASM
48.2 x 90.4 x 48.2 mm
Cell w Caps x 4
Cell link x 2
Fused link
