Katleho-engineer/Solidworks-design/Solidworks/reinforced 24T spur gear.SLDASM

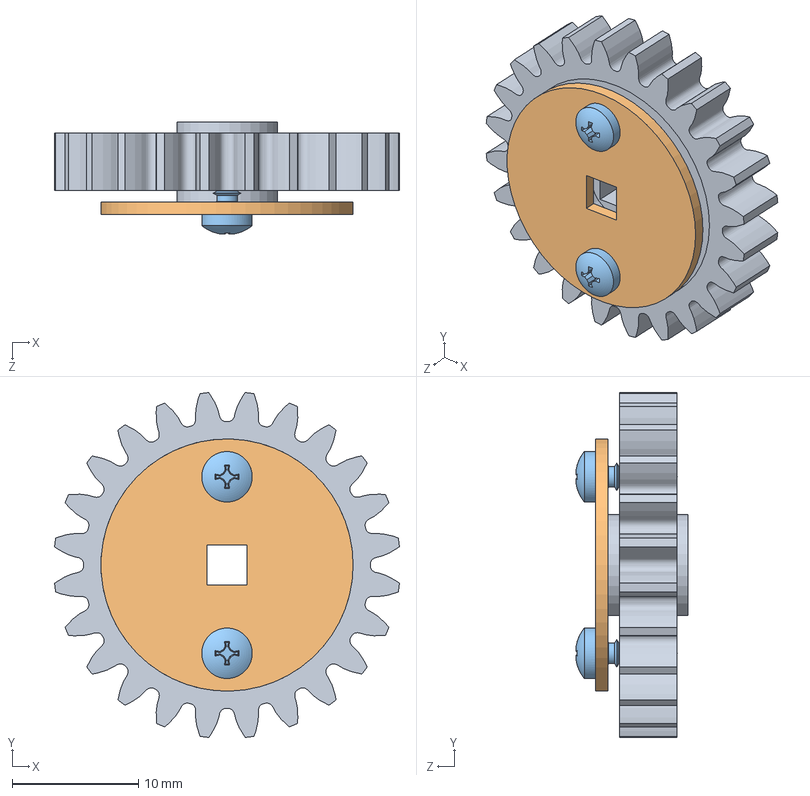
[picture p105: CAD file, 2023-12-31]
Solidworks/reinforced 24T spur gear.SLDASM
27.4 x 27.4 x 8.92 mm
Modified 24T gear
double plate 24T gear
Tapping screw DIN 7049-ST2.2x6.5-C-H-S x 2
