Katleho-engineer/Solidworks-design/Solidworks/Clamp assembly.SLDASM

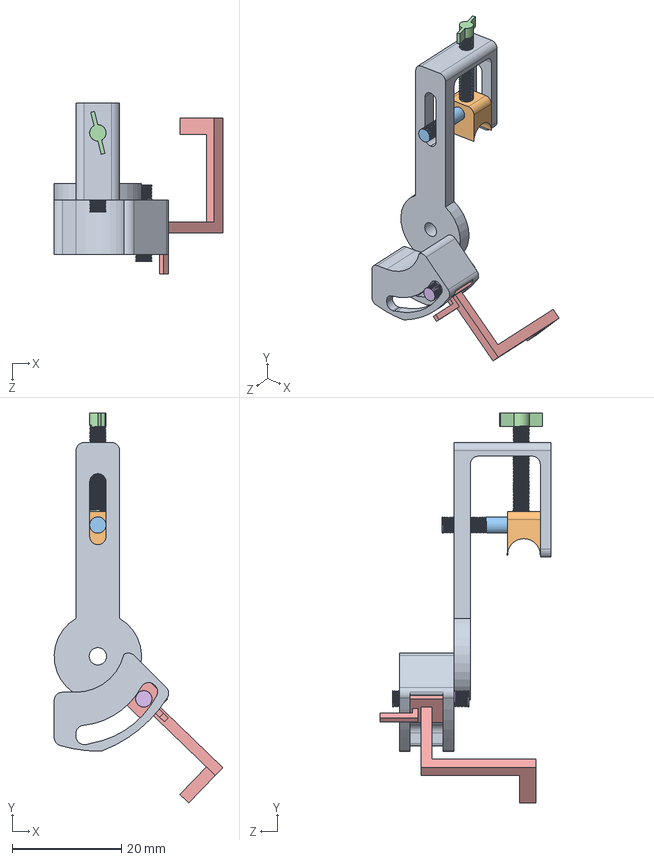
[picture p106: CAD file, 2023-12-31]
Solidworks/Clamp assembly.SLDASM
30.9 x 71.4 x 31.4 mm
clamp platform
Bending die
Die positioner
Die lock
angle lock
angle positioner
