Katleho-engineer/Solidworks-design/Solidworks/reinforced 36T spur gear.SLDASM

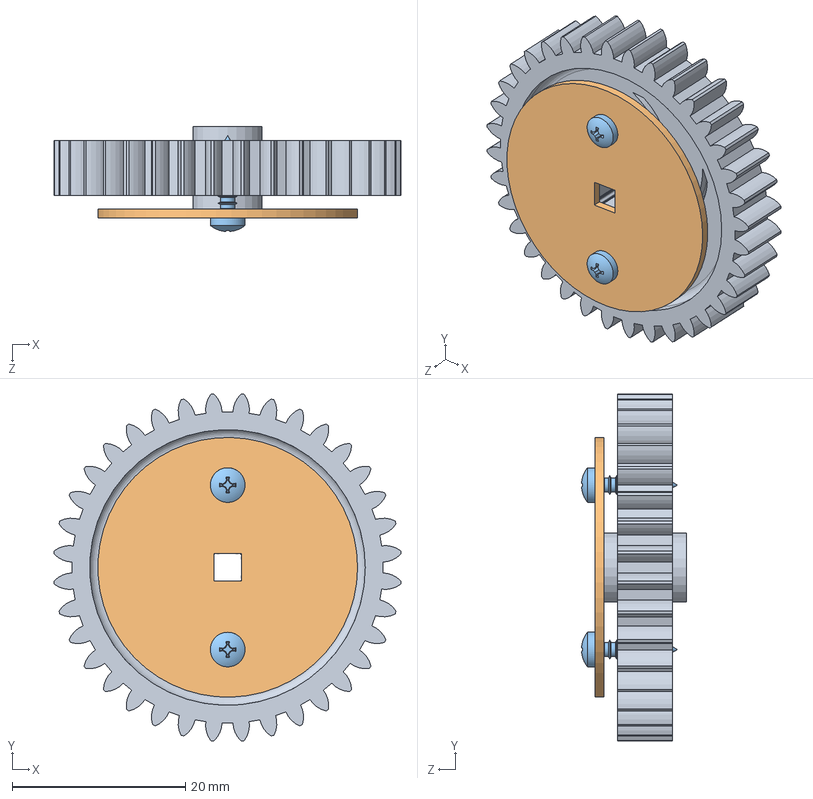
[picture p107: CAD file, 2023-12-31]
Solidworks/reinforced 36T spur gear.SLDASM
40.1 x 40.1 x 12.1 mm
Modified 36T gear
double plate 36T gear
Tapping screw DIN 7049-ST2.2x9.5-C-H-S x 2
