Katleho-engineer/Solidworks-design/Solidworks/motor support.SLDPRT

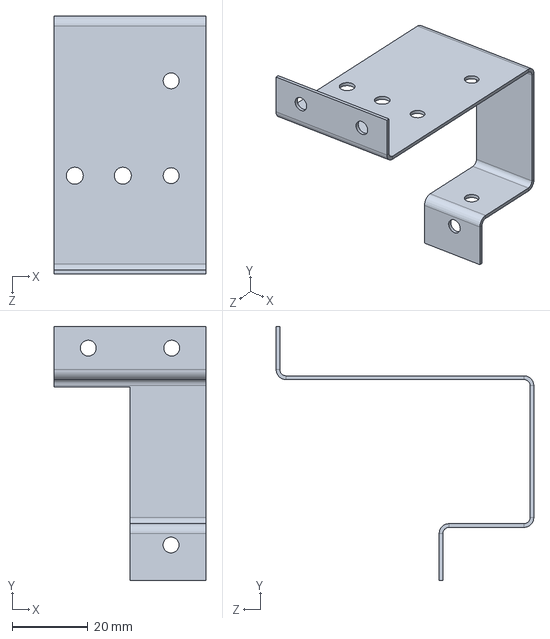
[picture p108: CAD file, 2023-12-31]
Solidworks/motor support.SLDPRT
40.0 x 67.0 x 68.0 mm
