Katleho-engineer/Solidworks-design/Solidworks/Modified 36T gear.SLDPRT

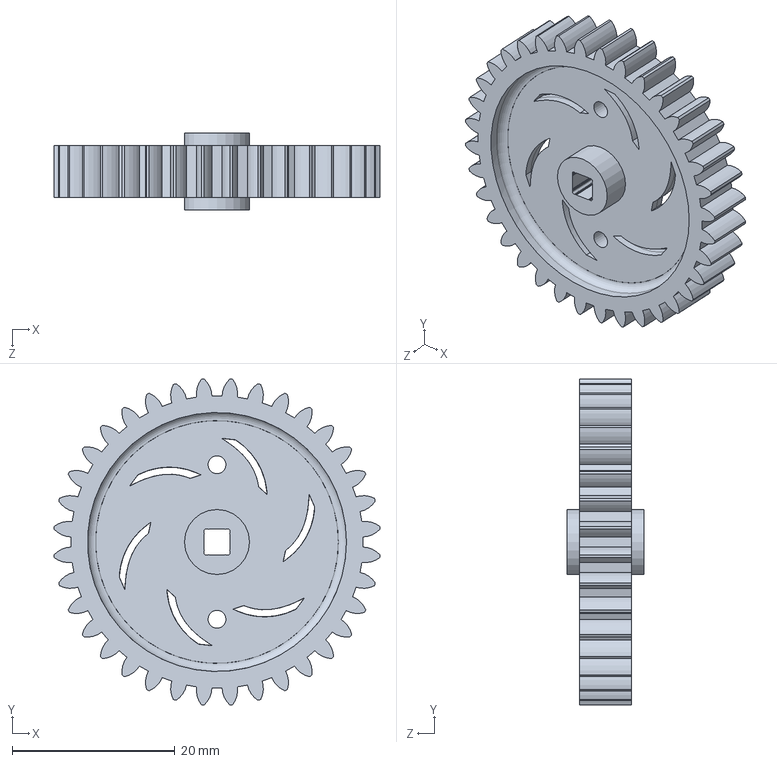
[picture p109: CAD file, 2023-12-31]
Solidworks/Modified 36T gear.SLDPRT
40.1 x 40.1 x 9.53 mm
