Katleho-engineer/Solidworks-design/Solidworks/push button.SLDPRT

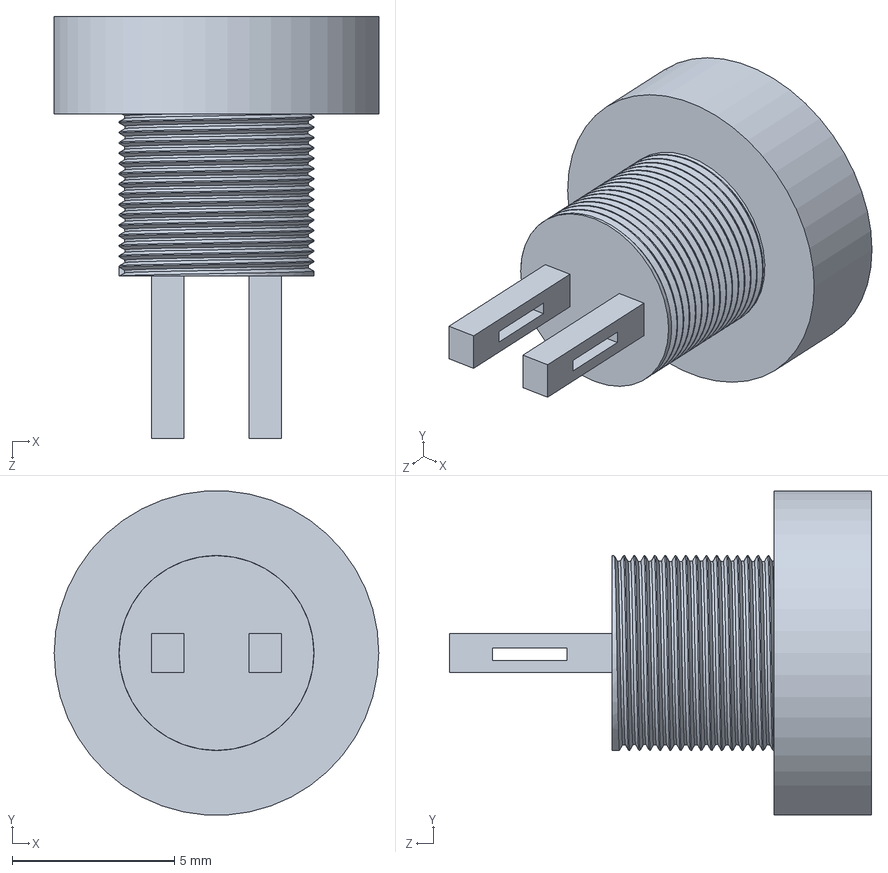
[picture p110: CAD file, 2023-12-31]
Solidworks/push button.SLDPRT
10.0 x 9.98 x 13.0 mm
