Katleho-engineer/Solidworks-design/Solidworks/microswitch.sldprt

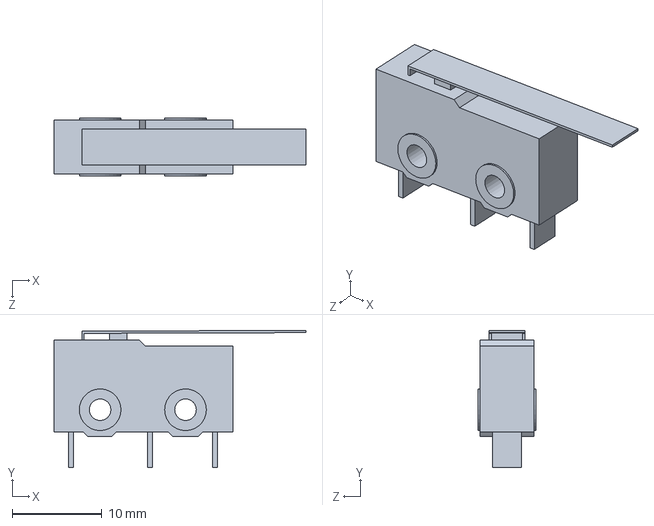
[picture p111: CAD file, 2023-12-31]
Solidworks/microswitch.sldprt
28.0 x 15.3 x 6.40 mm
