Katleho-engineer/Solidworks-design/Solidworks/Cell w Caps.SLDPRT

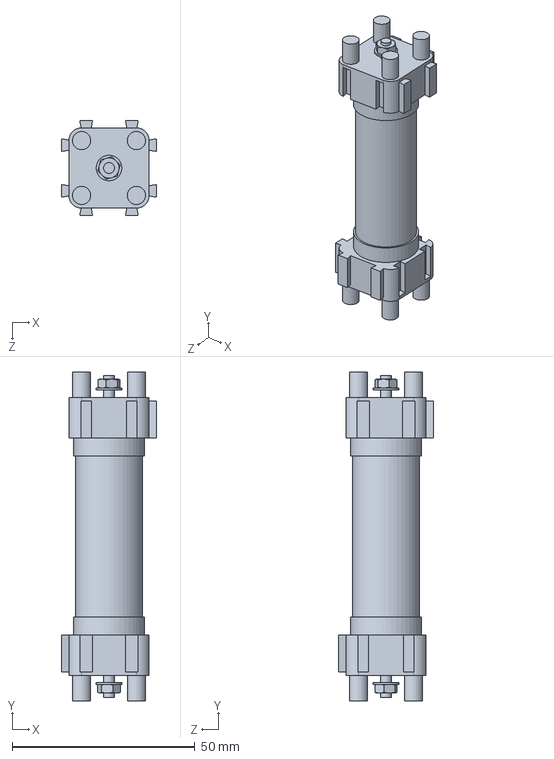
[picture p112: CAD file, 2023-12-31]
Solidworks/Cell w Caps.SLDPRT
26.0 x 90.0 x 26.0 mm
