Katleho-engineer/Solidworks-design/Solidworks/Cell link.SLDPRT

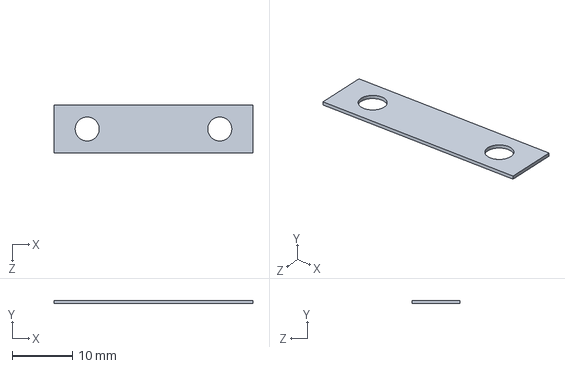
[picture p113: CAD file, 2023-12-31]
Solidworks/Cell link.SLDPRT
33.0 x 0.5 x 8.00 mm
