Katleho-engineer/Solidworks-design/Solidworks/handle.SLDPRT

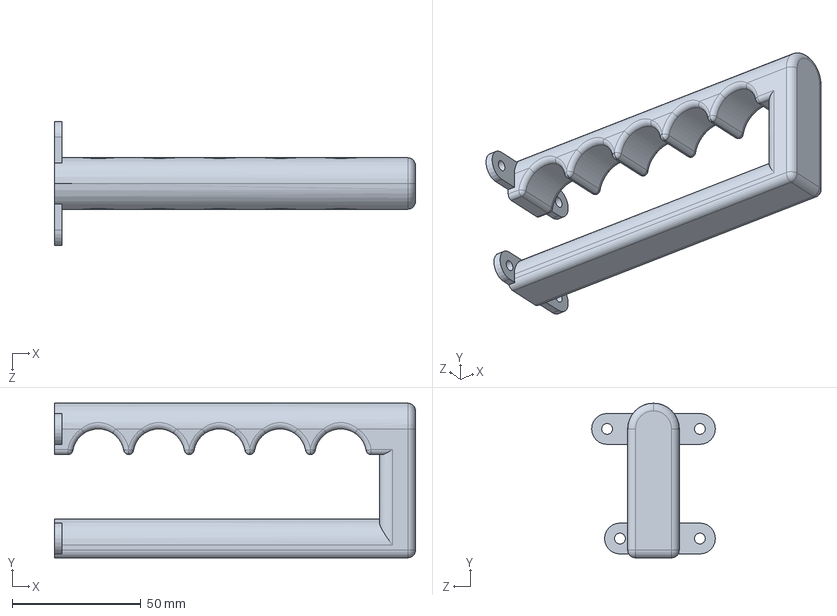
[picture p114: CAD file, 2023-12-31]
Solidworks/handle.SLDPRT
140.0 x 60.0 x 48.0 mm
