Katleho-engineer/Solidworks-design/Solidworks/Big roller.SLDPRT

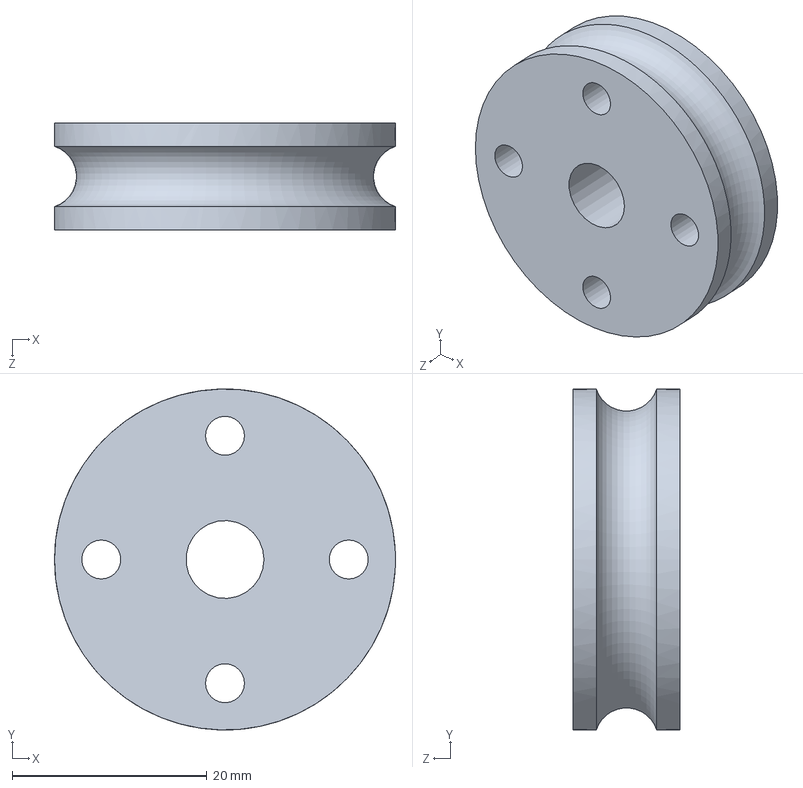
[picture p115: CAD file, 2023-12-31]
Solidworks/Big roller.SLDPRT
35.0 x 35.0 x 11.0 mm
