Katleho-engineer/Solidworks-design/Solidworks/Spacer.SLDPRT

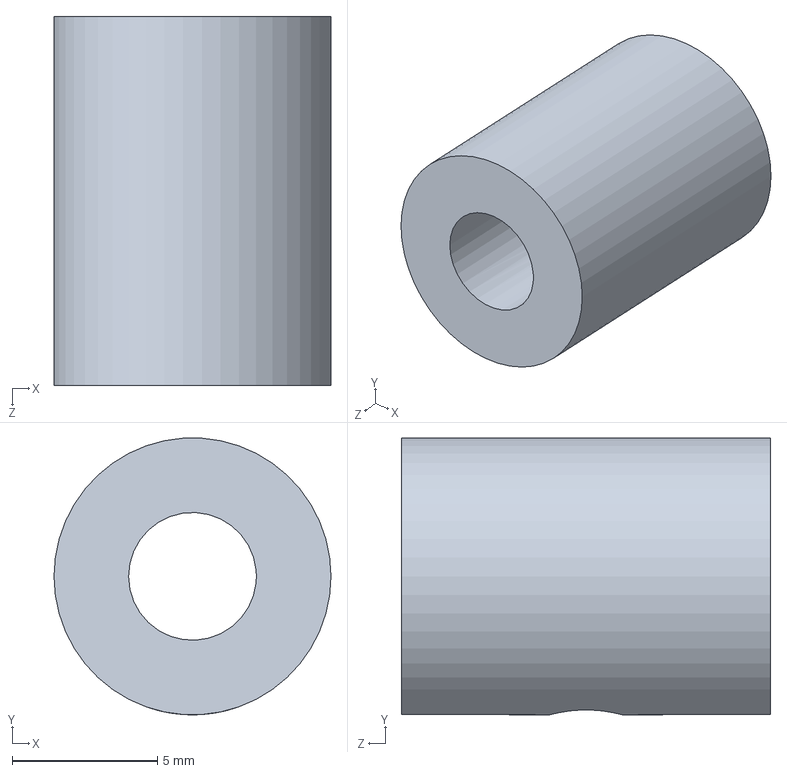
[picture p116: CAD file, 2023-12-31]
Solidworks/Spacer.SLDPRT
9.53 x 9.51 x 12.7 mm
