Katleho-engineer/Solidworks-design/Solidworks/push_button.stp.SLDPRT

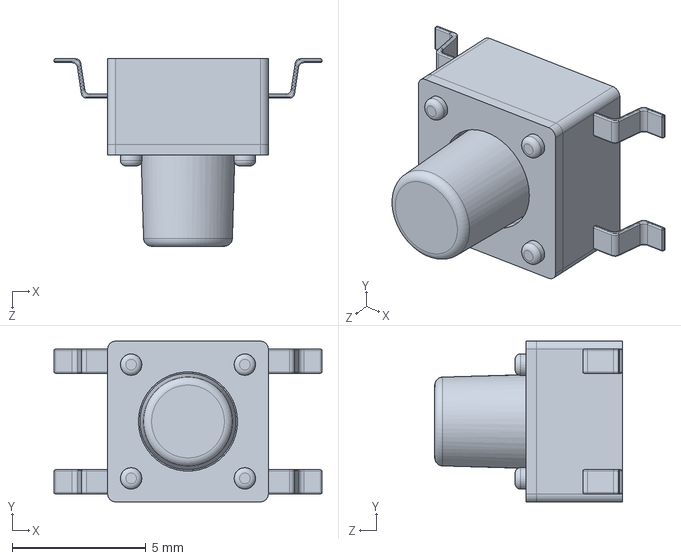
[picture p117: CAD file, 2023-12-31]
Solidworks/push_button.stp.SLDPRT
10.0 x 6.00 x 7.00 mm
