Katleho-engineer/Solidworks-design/Solidworks/Die positioner.SLDPRT

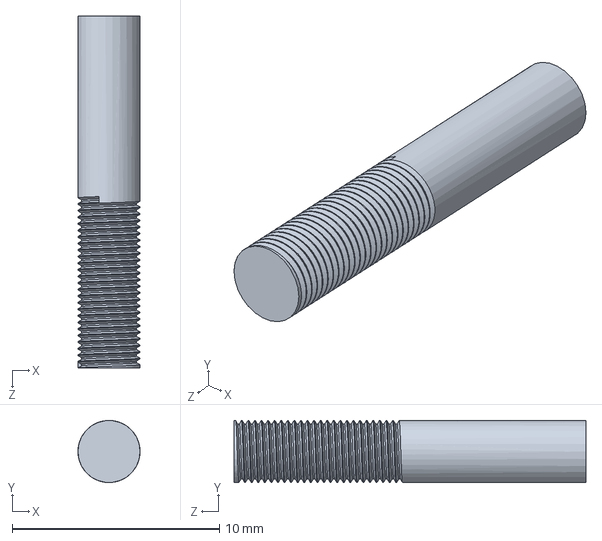
[picture p118: CAD file, 2023-12-31]
Solidworks/Die positioner.SLDPRT
3.00 x 3.00 x 17.0 mm
