Katleho-engineer/Solidworks-design/Solidworks/Shaft High strength.SLDPRT

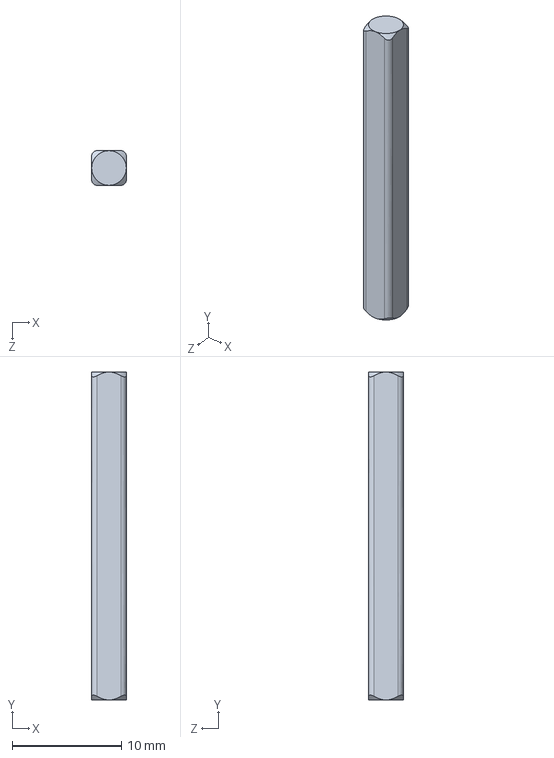
[picture p119: CAD file, 2023-12-31]
Solidworks/Shaft High strength.SLDPRT
3.17 x 30.0 x 3.17 mm
