Katleho-engineer/Solidworks-design/Solidworks/Bending die.SLDPRT

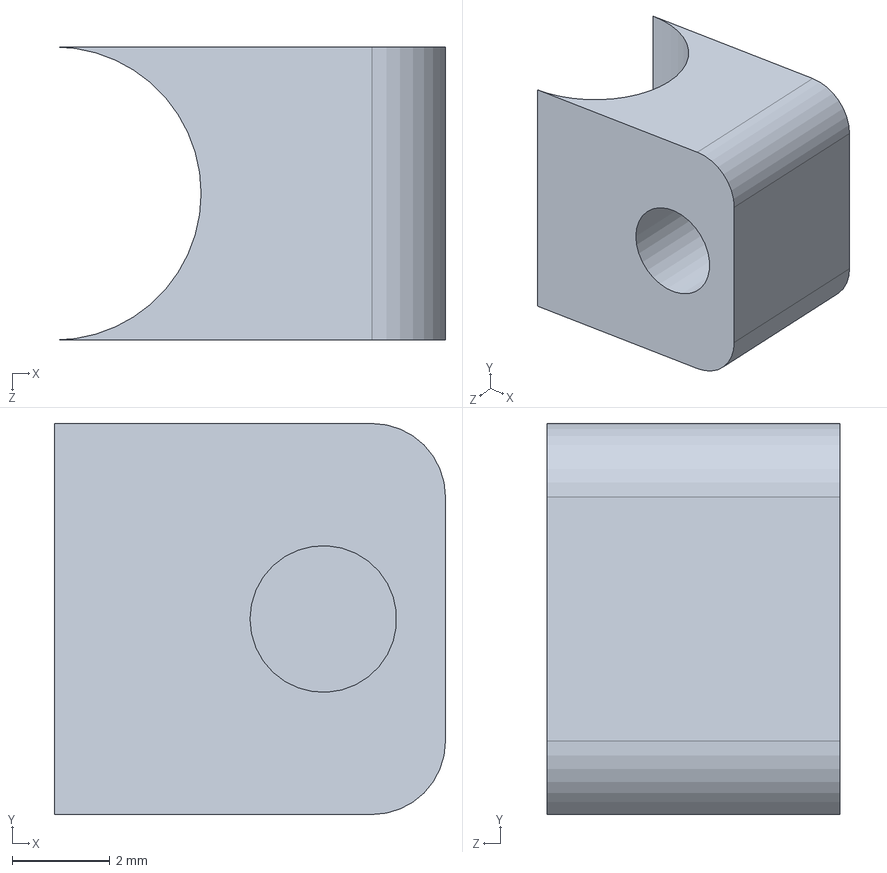
[picture p120: CAD file, 2023-12-31]
Solidworks/Bending die.SLDPRT
8.00 x 8.00 x 6.00 mm
