Katleho-engineer/Solidworks-design/Solidworks/pipe support.SLDPRT

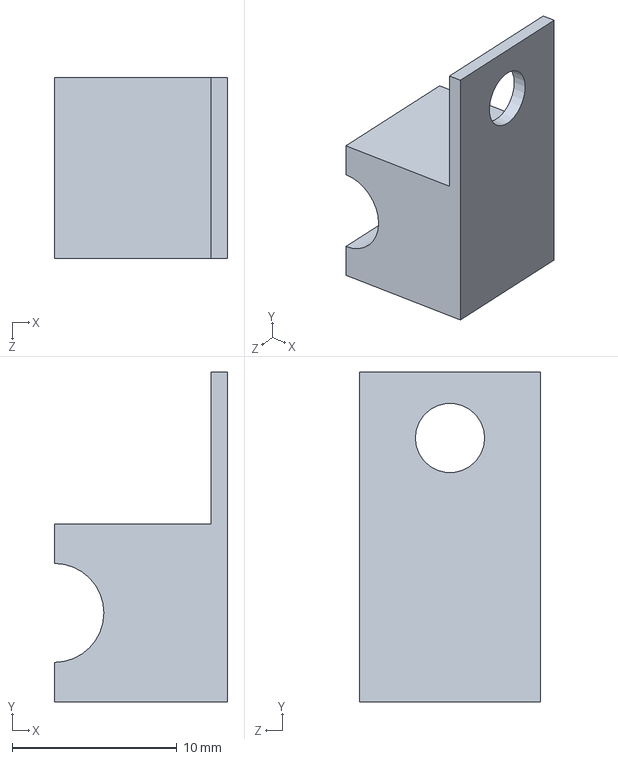
[picture p121: CAD file, 2023-12-31]
Solidworks/pipe support.SLDPRT
10.5 x 20.0 x 11.0 mm
