Katleho-engineer/Solidworks-design/Solidworks/lower shaft support.SLDPRT

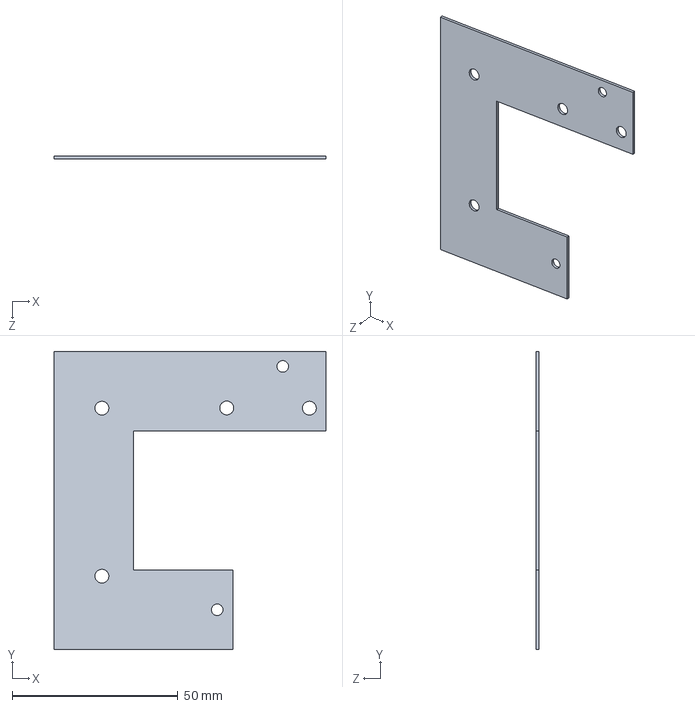
[picture p122: CAD file, 2023-12-31]
Solidworks/lower shaft support.SLDPRT
82.0 x 90.0 x 1.00 mm
