Katleho-engineer/Solidworks-design/Solidworks/Battery holder clamp.SLDPRT

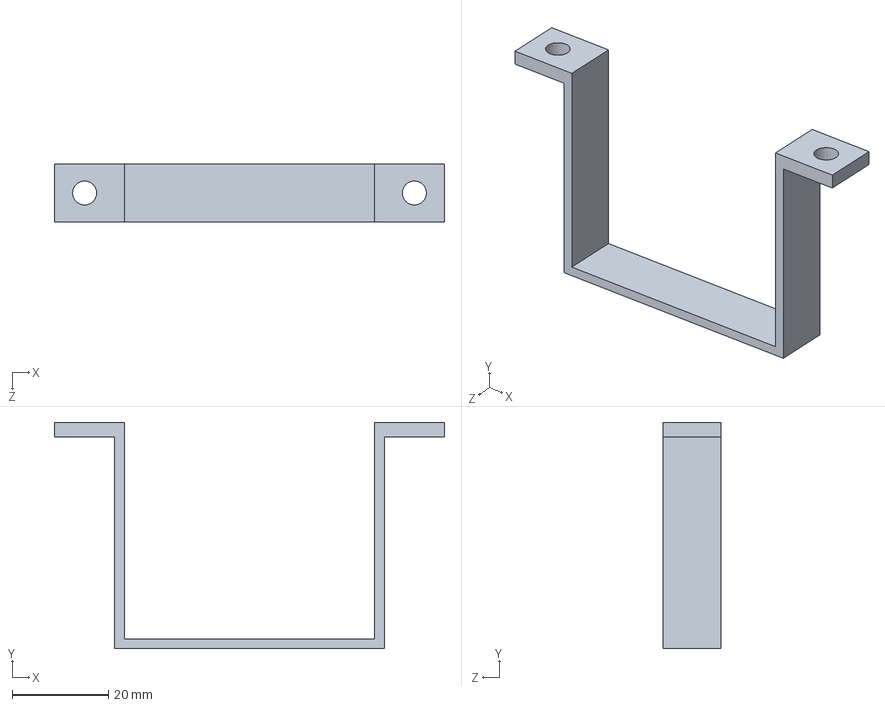
[picture p123: CAD file, 2023-12-31]
Solidworks/Battery holder clamp.SLDPRT
81.0 x 47.0 x 12.0 mm
