Katleho-engineer/Solidworks-design/Solidworks/clamp platform.SLDPRT

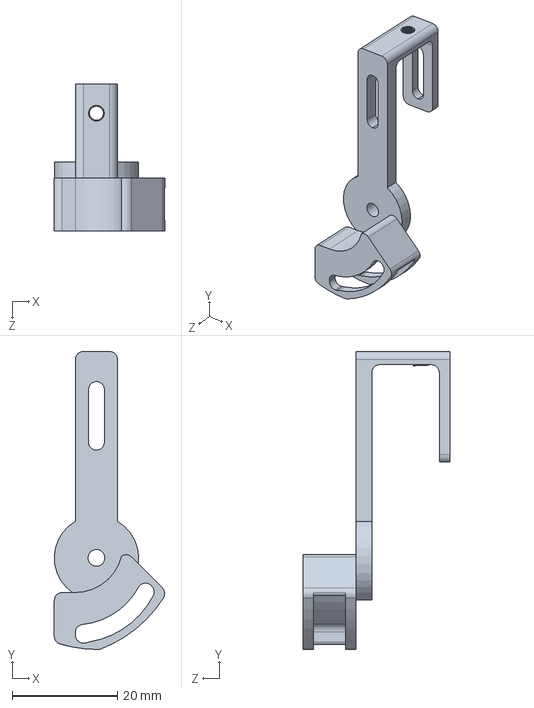
[picture p124: CAD file, 2023-12-31]
Solidworks/clamp platform.SLDPRT
21.0 x 56.5 x 27.8 mm
