Katleho-engineer/Solidworks-design/Solidworks/angle positioner.SLDPRT

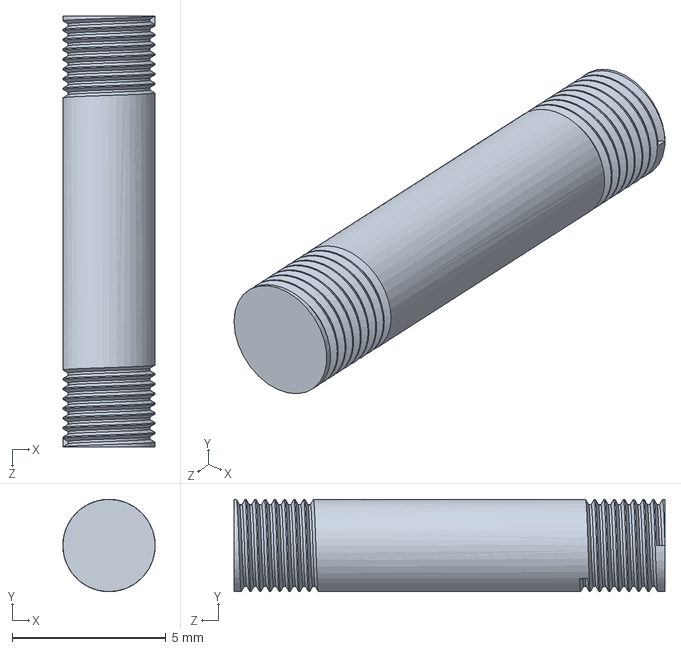
[picture p125: CAD file, 2023-12-31]
Solidworks/angle positioner.SLDPRT
3.00 x 3.00 x 14.0 mm
