Katleho-engineer/Solidworks-design/Solidworks/Circular custom shaft.SLDPRT

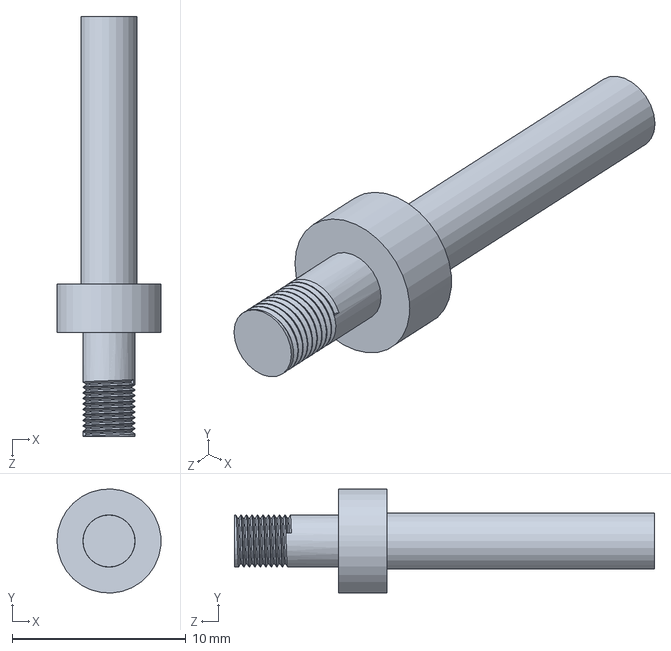
[picture p126: CAD file, 2023-12-31]
Solidworks/Circular custom shaft.SLDPRT
6.00 x 5.99 x 24.2 mm
