Katleho-engineer/Solidworks-design/Solidworks/motor lifter.SLDPRT

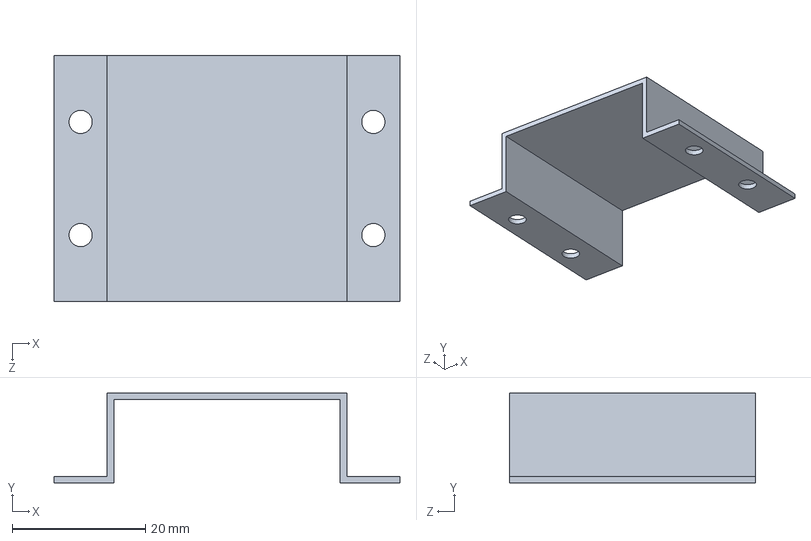
[picture p127: CAD file, 2023-12-31]
Solidworks/motor lifter.SLDPRT
52.0 x 13.5 x 37.0 mm
