Katleho-engineer/Solidworks-design/Solidworks/Lower casing.SLDPRT

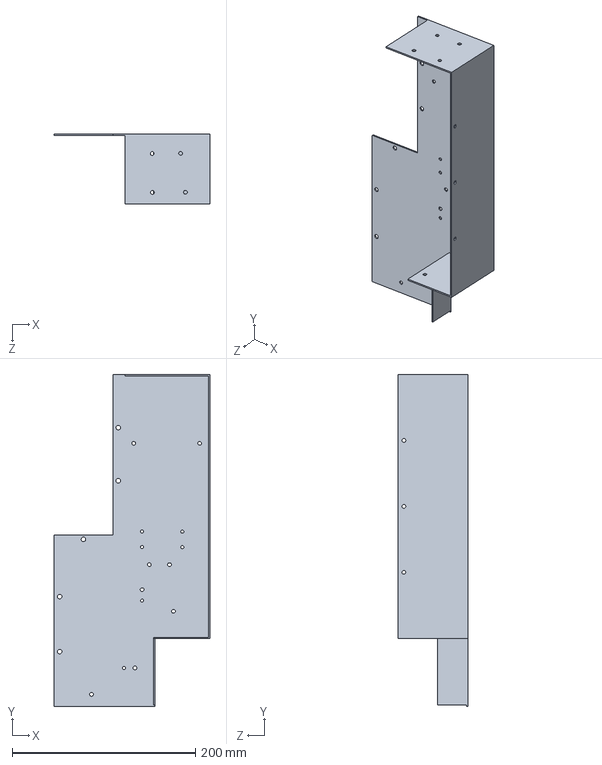
[picture p128: CAD file, 2023-12-31]
Solidworks/Lower casing.SLDPRT
170.0 x 362.5 x 76.0 mm
