Katleho-engineer/Solidworks-design/Solidworks/Upper casing.SLDPRT

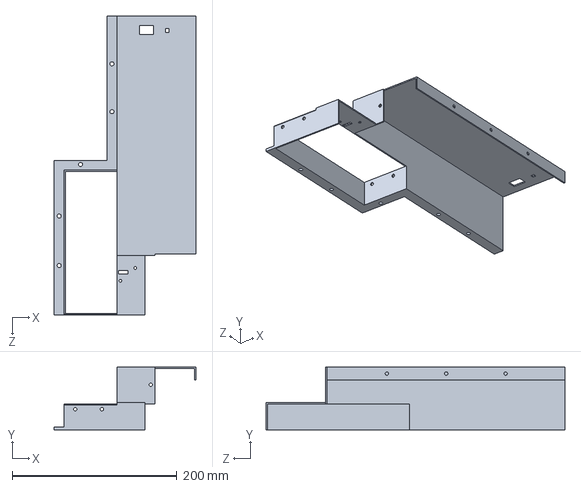
[picture p129: CAD file, 2023-12-31]
Solidworks/Upper casing.SLDPRT
171.6 x 76.0 x 362.5 mm
