Katleho-engineer/Solidworks-design/Solidworks/double plate 48T gear.SLDPRT

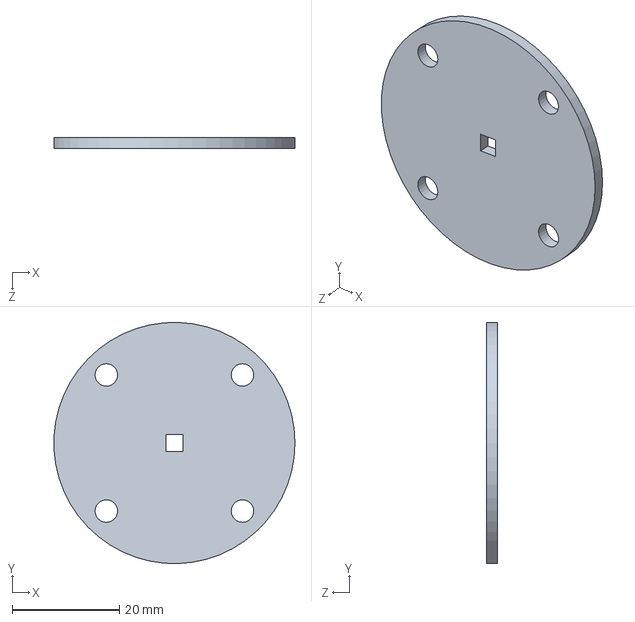
[picture p130: CAD file, 2023-12-31]
Solidworks/double plate 48T gear.SLDPRT
45.0 x 45.0 x 2.00 mm
