Katleho-engineer/Solidworks-design/Solidworks/sheet support.SLDPRT

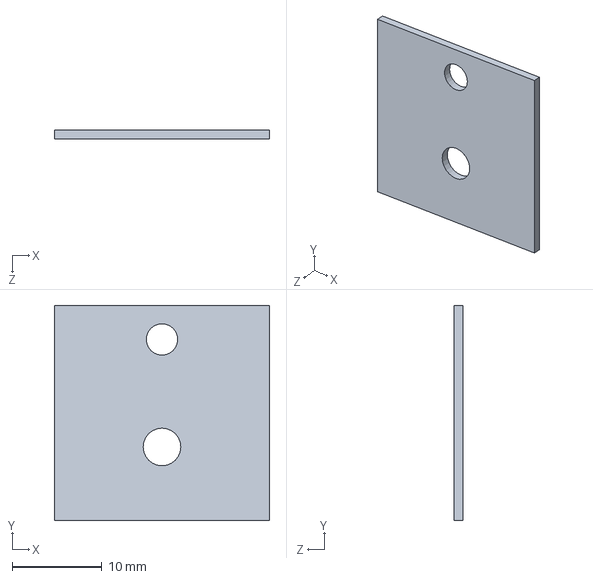
[picture p131: CAD file, 2023-12-31]
Solidworks/sheet support.SLDPRT
24.0 x 24.0 x 1.00 mm
