Katleho-engineer/Solidworks-design/Solidworks/Modified 24T gear.SLDPRT

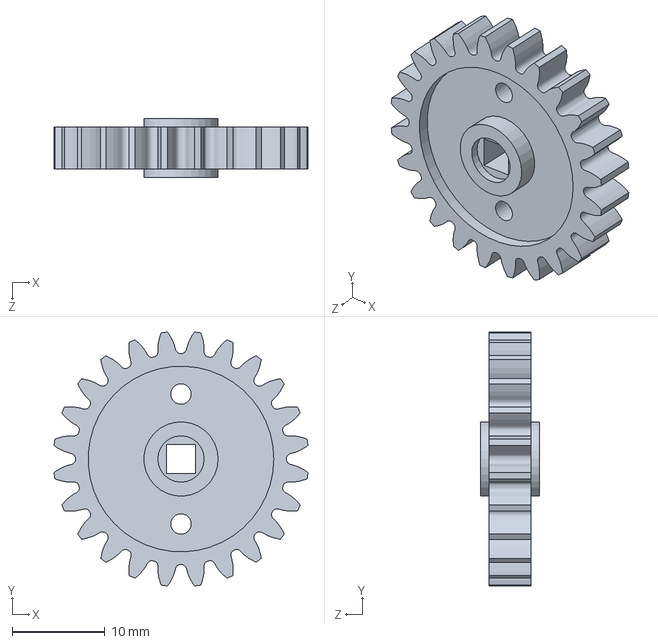
[picture p132: CAD file, 2023-12-31]
Solidworks/Modified 24T gear.SLDPRT
27.4 x 27.4 x 6.35 mm
