Katleho-engineer/Solidworks-design/Solidworks/Die lock.SLDPRT

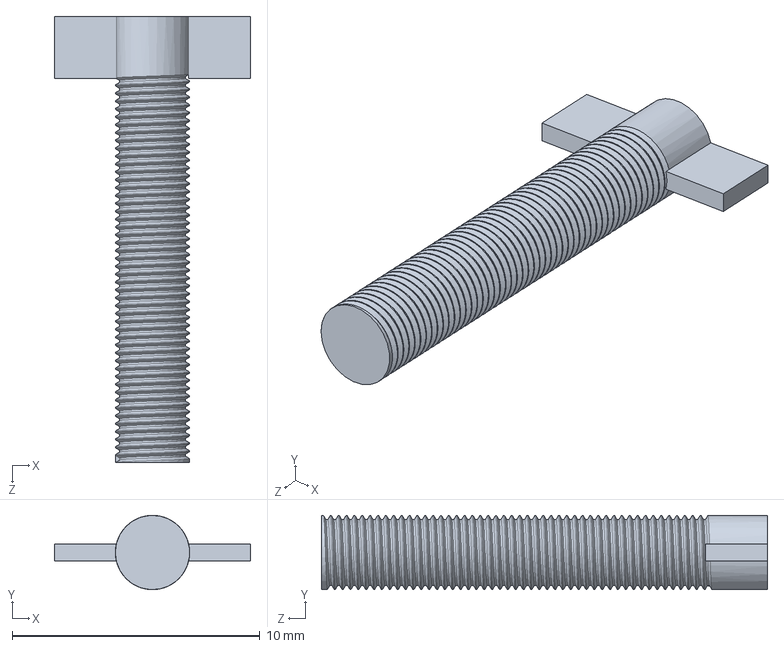
[picture p133: CAD file, 2023-12-31]
Solidworks/Die lock.SLDPRT
7.92 x 3.00 x 18.0 mm
