Katleho-engineer/Solidworks-design/Solidworks/double plate 24T gear.SLDPRT

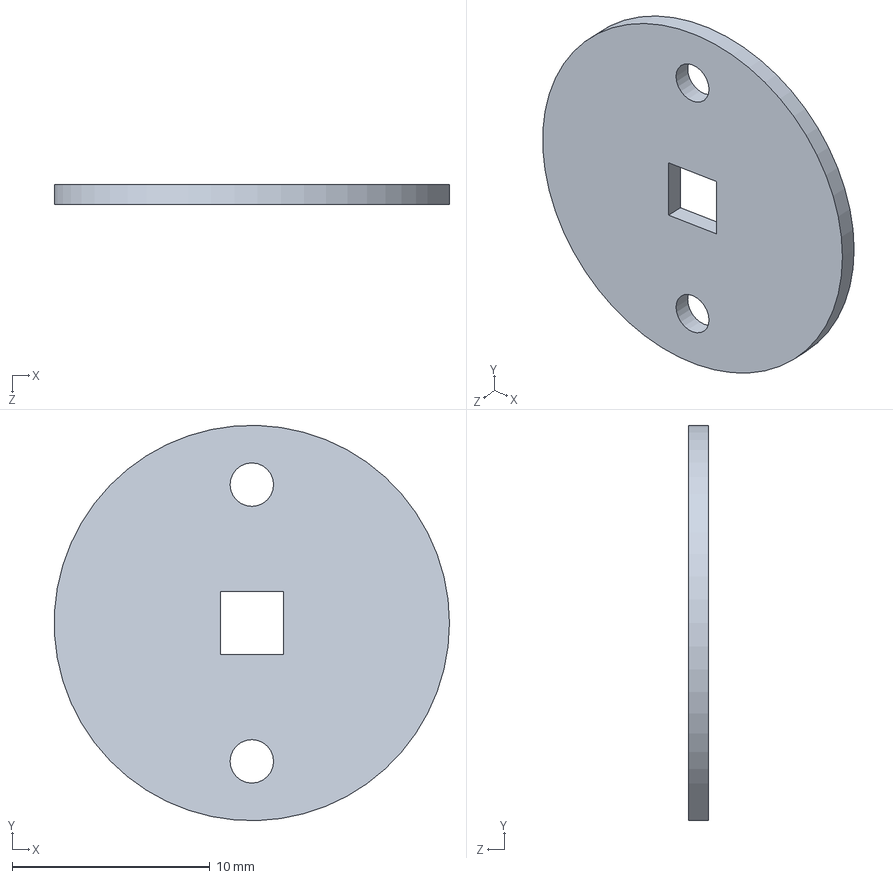
[picture p134: CAD file, 2023-12-31]
Solidworks/double plate 24T gear.SLDPRT
20.0 x 20.0 x 1.00 mm
