Katleho-engineer/Solidworks-design/Solidworks/Upper support.SLDPRT

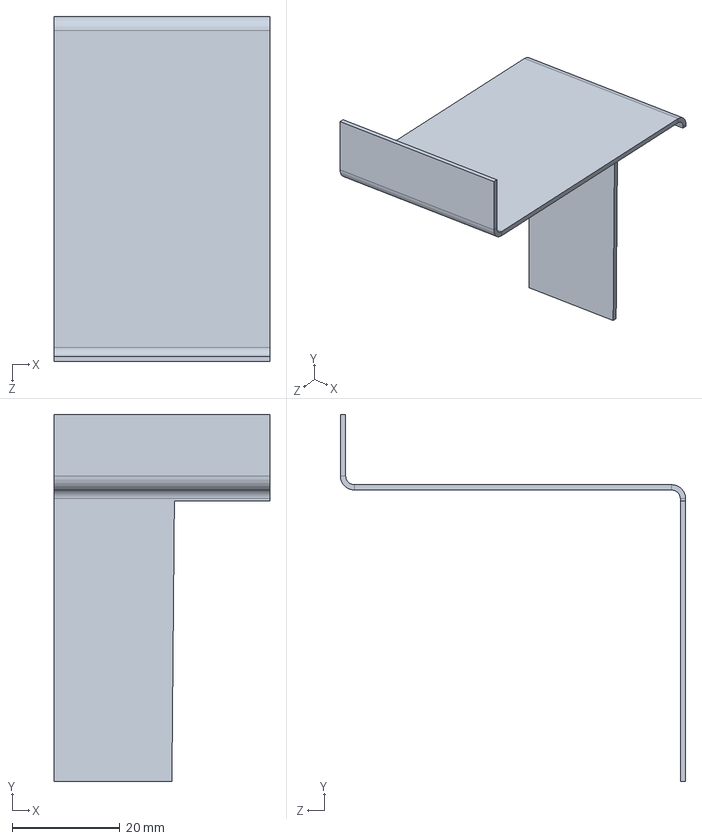
[picture p135: CAD file, 2023-12-31]
Solidworks/Upper support.SLDPRT
40.0 x 68.0 x 64.0 mm
