Katleho-engineer/Solidworks-design/Solidworks/base.SLDPRT

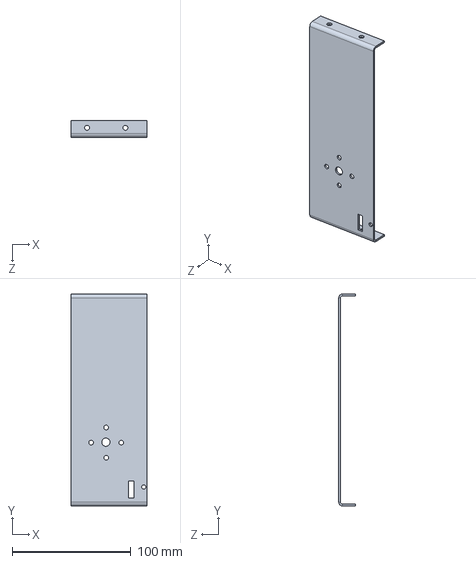
[picture p136: CAD file, 2023-12-31]
Solidworks/base.SLDPRT
64.0 x 178.8 x 14.0 mm
