Katleho-engineer/Solidworks-design/Solidworks/Upper shaft support.SLDPRT

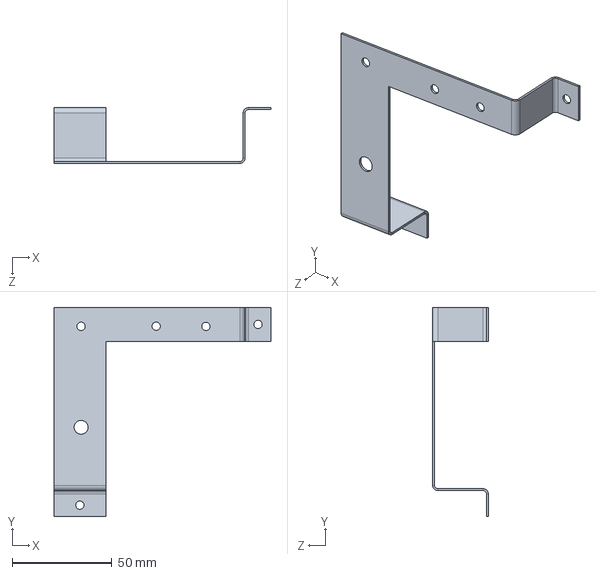
[picture p137: CAD file, 2023-12-31]
Solidworks/Upper shaft support.SLDPRT
109.0 x 105.0 x 28.0 mm
