Katleho-engineer/Solidworks-design/Solidworks/Fused link.SLDPRT

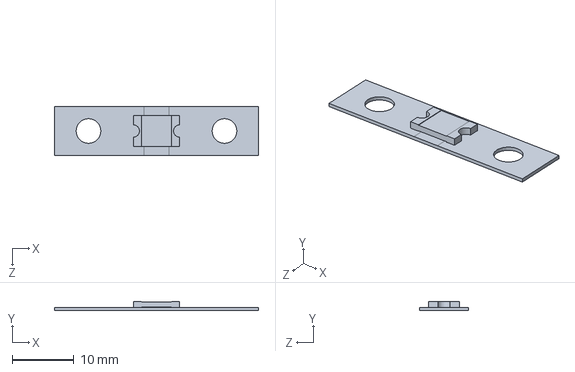
[picture p138: CAD file, 2023-12-31]
Solidworks/Fused link.SLDPRT
33.0 x 1.50 x 8.00 mm
