Katleho-engineer/Solidworks-design/Solidworks/double plate 36T gear.SLDPRT

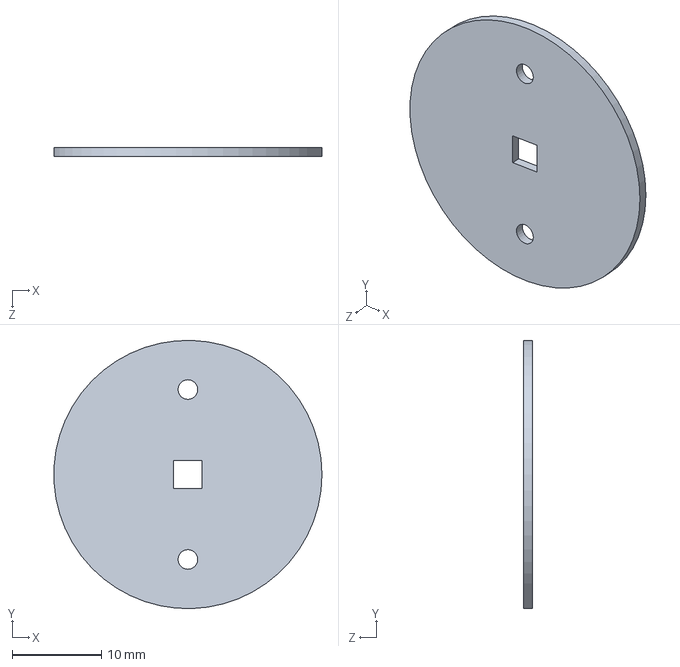
[picture p139: CAD file, 2023-12-31]
Solidworks/double plate 36T gear.SLDPRT
30.0 x 30.0 x 1.00 mm
