Katleho-engineer/Solidworks-design/Solidworks/microswitch upper holder.SLDPRT

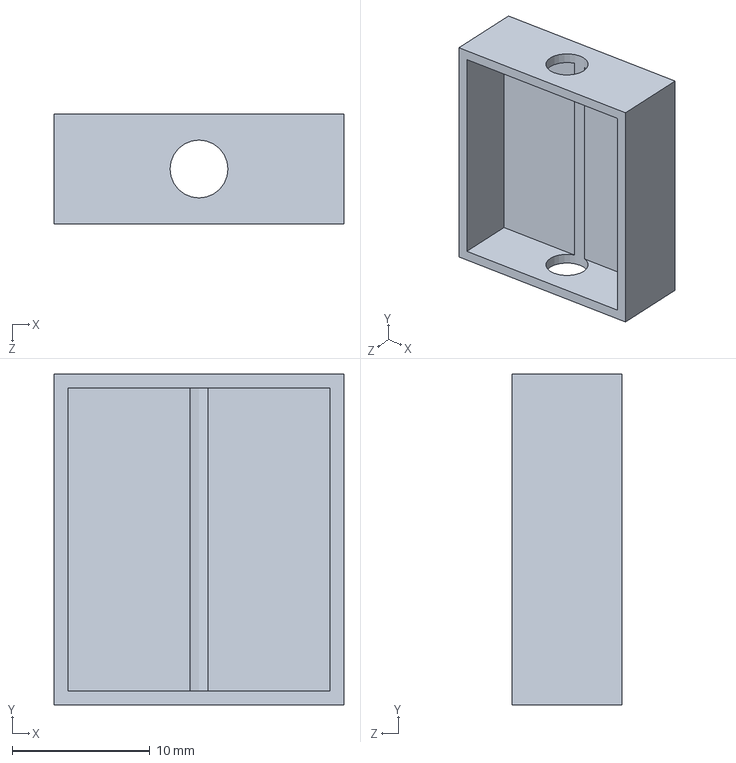
[picture p140: CAD file, 2023-12-31]
Solidworks/microswitch upper holder.SLDPRT
21.0 x 24.0 x 8.00 mm
