Katleho-engineer/Solidworks-design/Solidworks/Bevel Gear.SLDPRT

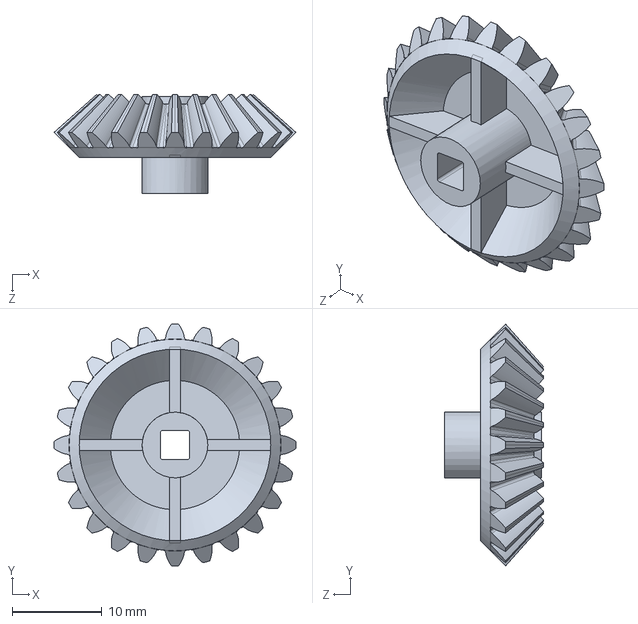
[picture p141: CAD file, 2023-12-31]
Solidworks/Bevel Gear.SLDPRT
26.9 x 26.9 x 11.0 mm
