Katleho-engineer/Solidworks-design/Solidworks/microswitch lower holder two.SLDPRT

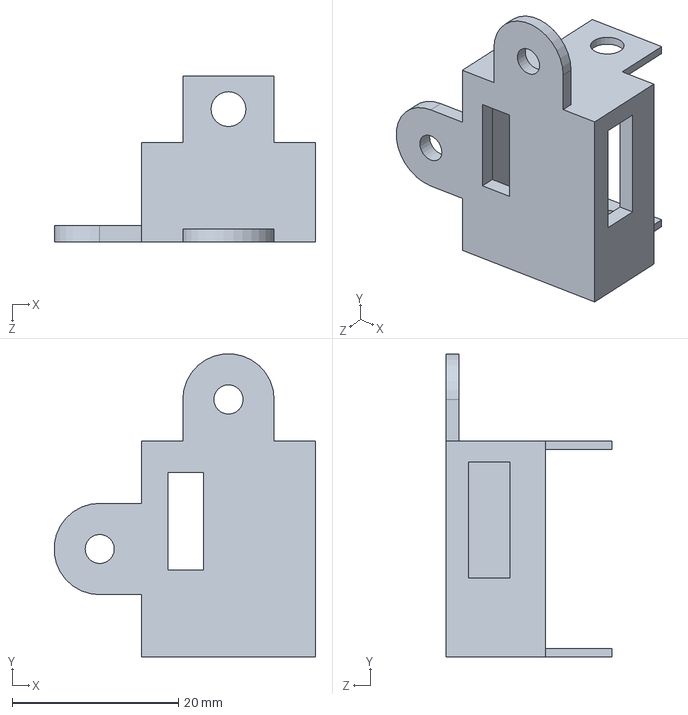
[picture p142: CAD file, 2023-12-31]
Solidworks/microswitch lower holder two.SLDPRT
31.5 x 36.5 x 20.0 mm
