Katleho-engineer/Solidworks-design/Solidworks/angle lock.SLDPRT

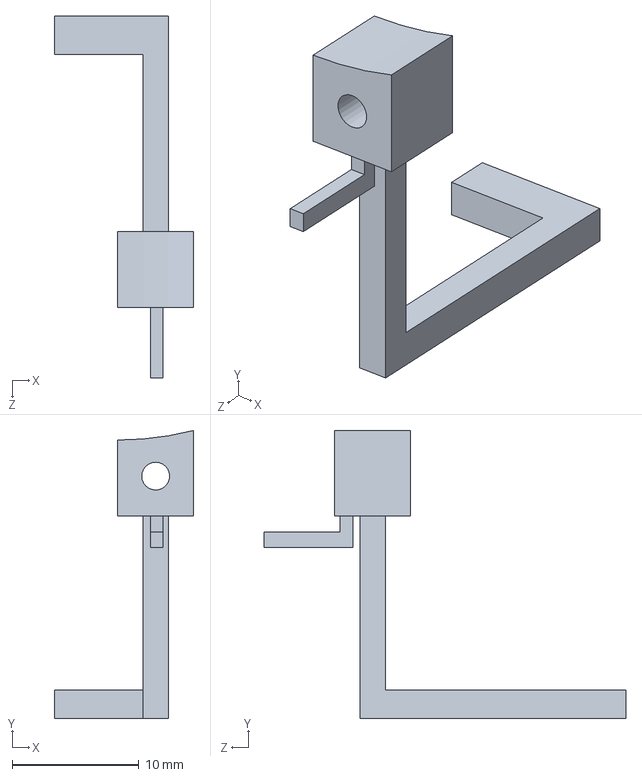
[picture p143: CAD file, 2023-12-31]
Solidworks/angle lock.SLDPRT
11.0 x 22.8 x 28.6 mm
