Katleho-engineer/Solidworks-design/Solidworks/Shaft Coupler.SLDPRT

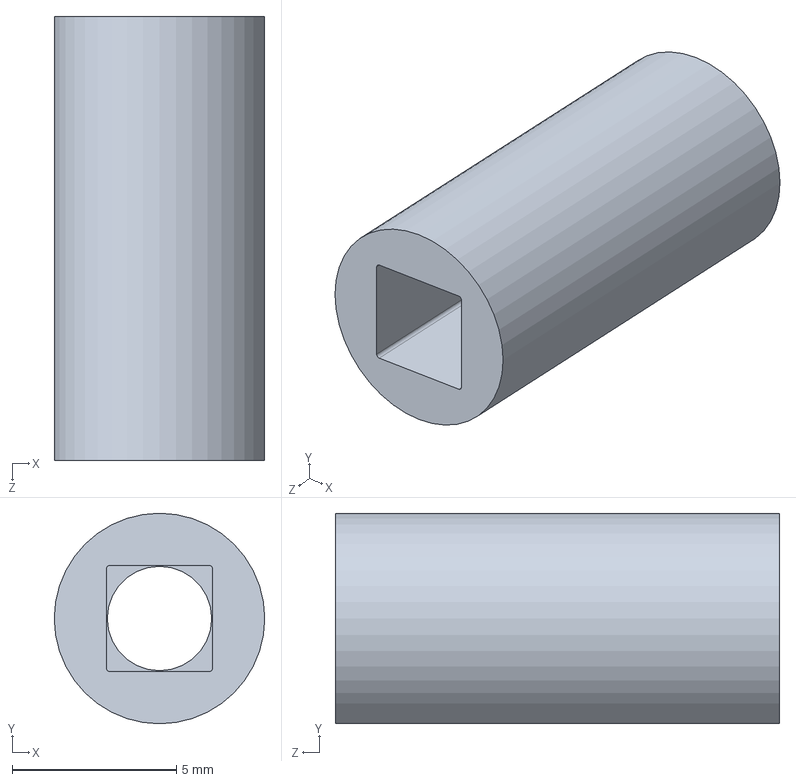
[picture p144: CAD file, 2023-12-31]
Solidworks/Shaft Coupler.SLDPRT
6.40 x 6.40 x 13.5 mm
