Katleho-engineer/Solidworks-design/Solidworks/Shaft.SLDPRT

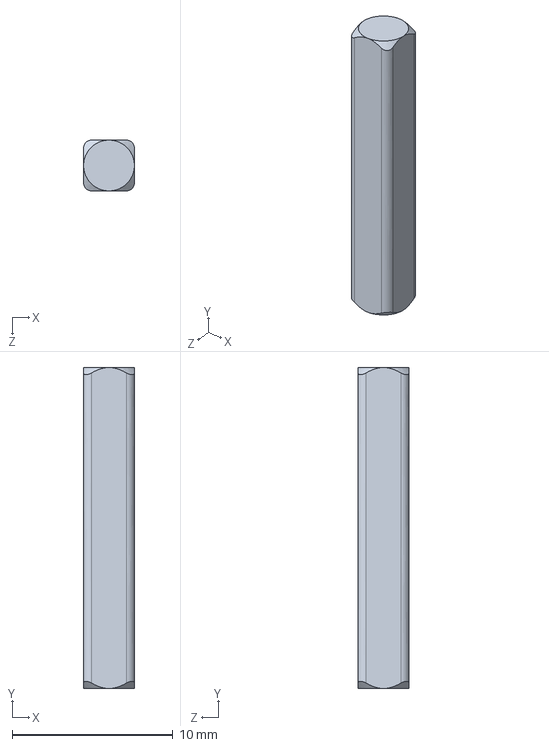
[picture p145: CAD file, 2023-12-31]
Solidworks/Shaft.SLDPRT
3.17 x 20.0 x 3.17 mm
