Katleho-engineer/Solidworks-design/Solidworks/microswitch lower holder.SLDPRT

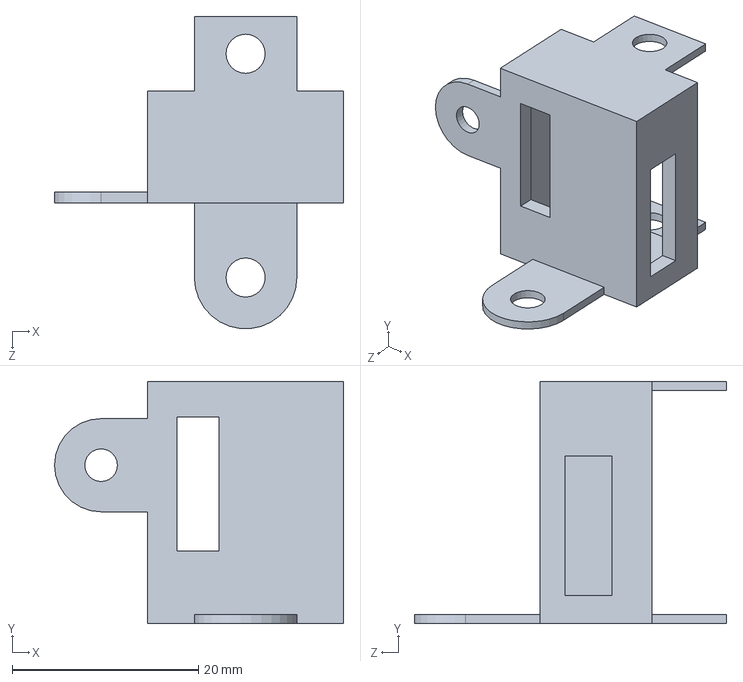
[picture p146: CAD file, 2023-12-31]
Solidworks/microswitch lower holder.SLDPRT
31.0 x 26.0 x 33.5 mm
