Katleho-engineer/Solidworks-design/Solidworks/Battery holder.SLDPRT

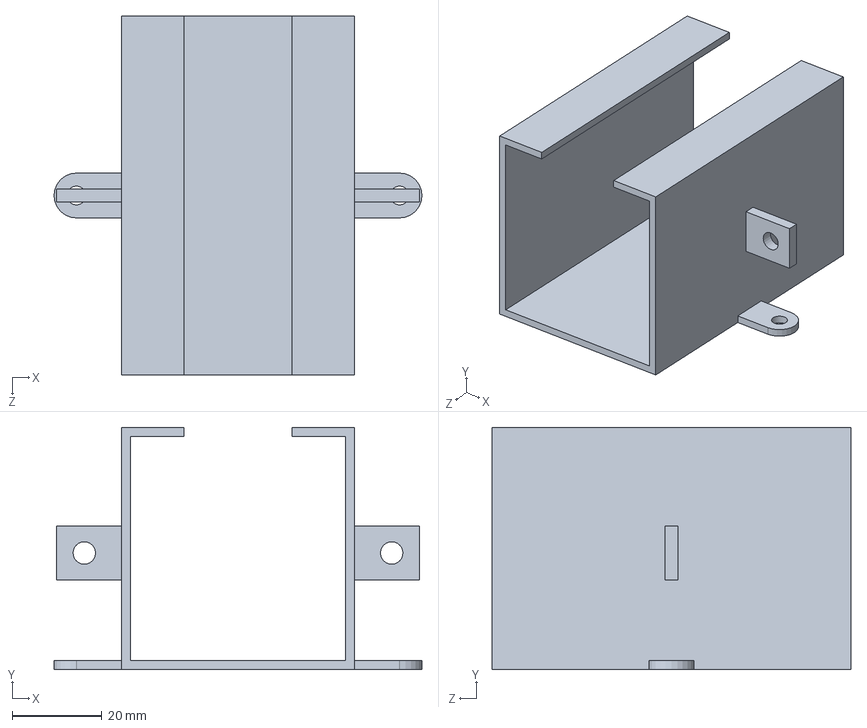
[picture p147: CAD file, 2023-12-31]
Solidworks/Battery holder.SLDPRT
82.0 x 54.0 x 80.0 mm
