Katleho-engineer/Solidworks-design/Solidworks/RockerSwitch.SLDPRT

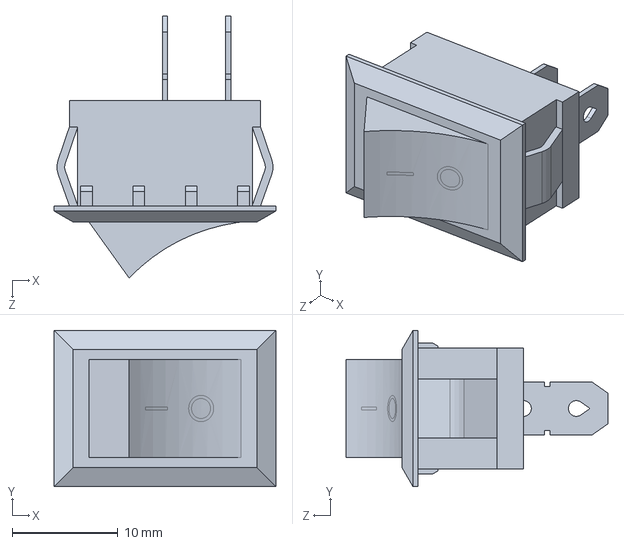
[picture p148: CAD file, 2023-12-31]
Solidworks/RockerSwitch.SLDPRT
21.0 x 14.8 x 24.8 mm
