Katleho-engineer/Solidworks-design/(list of files, cad)

Other CAD files:
Solidworks/6-32 screw.SLDPRT
